balintbalazs/thesis/appendix_a.tex

% !TEX root = dissertation_BB.tex
% \cleardoublepage
% \chapter*{Appendix A}
% \addcontentsline{toc}{chapter}{Appendix A: Bill of materials}

\section{Bill of materials}
% \markboth{\MakeUppercase{Appendix A}}{}

% \setcounter{table}{0}
% \renewcommand{\thetable}{A\arabic{table}}

\begin{singlespace}
  
% \section*{Bill of Materials}
\label{sec:BOM}
\subsection*{Optical components}
  \begin{itemize}
    \item Lenses
    \begin{itemize}
      \item 2\texttimes Nikon CFI75 Apo LWD 25x/1.10w water dipping objectives
      \item 2\texttimes Nikon ITL200 \SI{200}{mm} tube lens
      \item 2\texttimes \SI{200}{mm} x \SI{25}{mm} Dia. achromatic lens (Edmund Optics, \#47-645)
      \item 2\texttimes \SI{400}{mm} x \SI{40}{mm} Dia. achromatic lens (Edmund Optics, \#49-281)
      \item 3\texttimes \SI{75}{mm} x \SI{25}{mm} Dia. achromatic lens (Edmund Optics, \#47-639)
      \item SILL 112751 1:2 beam expander
    \end{itemize}
    \item Filters
    \begin{itemize}
      \item 2\texttimes BrightLine quad-edge dichroic beam splitter (Semrock, Di03-R405/488/561/635-t3-25x36)
      \item EdgeBasic \SI{488}{nm} long pass filter (Semrock, BLP01-488R-25)
      \item BrightLine 525/50 band pass filter (Semrock, FF03-525/50-25)
      \item EdgeBasic \SI{561}{nm} long pass filter (Semrock, BLP02-561R-25)
      \item RazorEdge \SI{647}{nm} long pass filter (Semrock, LP02-647RU-25)
    \end{itemize}
    \item Mirrors
    \begin{itemize}
      \item 6\texttimes 1" Broadband Dielectric Elliptical Mirror (Thorlabs, BBE1-E03)
      \item 2\texttimes \SI{30}{mm} Broadband $1/10 \lambda$ Mirror (OptoSigma, TFMS-30C05-4/11)
      \item 10 Pack of 1" Protected Silver Mirrors (Thorlabs, PF10-03-P01-10)
      \item Knife-Edge Right-Angle Prism Dielectric Mirror (Thorlabs, MRAK25-E02)
    \end{itemize}
  \end{itemize}

\subsection*{Mechanical components}
  \begin{itemize}
    \item \SI{40}{mm} travel range pneumatic cylinder (Airtac, HM-10-040)
    \item 5/2-way electric valve (Airtac, M-20-510-HN)
    \item 2\texttimes \SI{25}{mm} extended contact bearing steel stage (OptoSigma, TSDH-251C)
    \item 30x90 mm stainless steel slide (OptoSigma,  IPWS-F3090)
    \item close proximity gimbal mirror mount (Thorlabs, GMB1/M)
    \item \SI{30}{mm} cage elliptical mirror mount (Thorlabs, KCB1E)
    \item Melles Griot Performance Plus Optical Breadboard
    \item 4\texttimes Newport Stabilizer, High Performance laminar Flow Isolator, I-2000 Series
  \end{itemize}

\subsection*{Custom parts}
  All parts are (anodized) aluminium, unless stated otherwise.
  \begin{itemize}
    \item 2\texttimes mirror holder block
    \item Front plate for objective, chamber and mirror mounting
    \item Imaging chamber (PEEK)
    \item Wedge ring and matching threaded ring to fasten objectives
    \item Camera bridge
    \item Illumination splitter unit
    \item adapter plates to mount stages
  \end{itemize}

\subsection*{Electronics}

  \begin{itemize}
    \item Embedded system (National Instruments, cRIO-9068) equipped with:
    \begin{itemize}
      \item 2\texttimes C series digital I/O card (NI 9401)
      \item 1\texttimes C Series \SI{100}{kS/s} 4-channel Voltage Output Module (NI 9263)
      \item 1\texttimes C Series \SI{25}{kS/s} 16-channel Voltage Output Module (NI 9264)
    \end{itemize}
    \item Omicron SOLE-3 laser combiner, with 488, 561 and \SI{638}{nm} laser lines
    \item Andor Zyla 4.2 sCMOS Camera
    \item Galvanometric scanner mirror (Cambridge Technology, 6210B)
    \item 6 position filter wheel (Ludl Electronic Products, 96A361)
    \item Filter wheel controller unit (Ludl Electronic Products, MAC5000)
    \item 2 piezoelectric stages (Nanos Instruments, LPS-30-30-1-V2\_61-S-N) 
    \item 2 stage controller boards (Nanos Instruments, BMC101)
  \end{itemize}
\end{singlespace}
