balintbalazs/thesis/diplomaterv.pdf

# Development of a symmetric single-plane

# illumination microscope

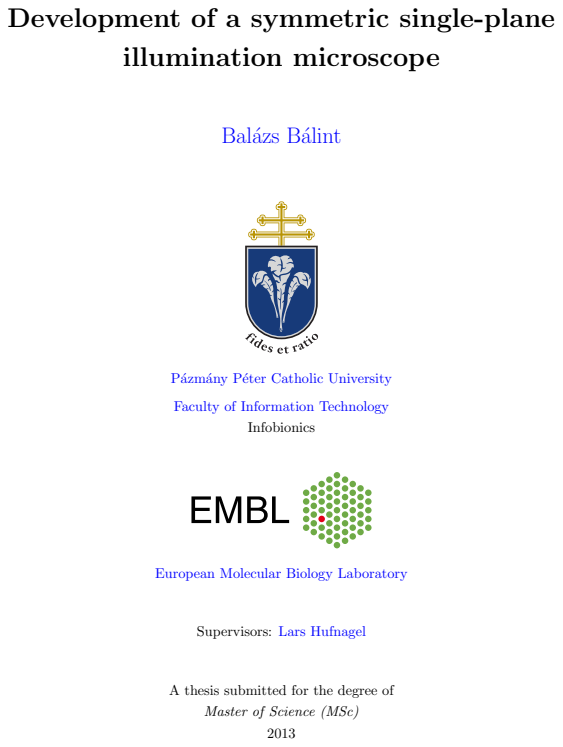
[picture p47: page 1]
Infobionics

Balázs Bálint

Pázmány Péter Catholic University (http://www.ppke.hu/)

Faculty of Information Technology (http://www.itk.ppke.hu/)

European Molecular Biology Laboratory (http://www.embl.de/)

Supervisors: Lars Hufnagel

A thesis submitted for the degree of
Master of Science (MSc)

Jelen dolgozat 2013 márcuis hó 27. napon a XXXI. OTDK Informatika szekciójában I. helyezést ért el.

## Nyilatkozat

Alulírott Balázs Bálint, a Pázmány Péter Katolikus Egyetem Információs

Technológiai Karának hallgatója kijelentem, hogy ezt a szakdolgozatot meg nem engedett segítség nélkül, saját magam készítettem, és a szakdolgozatban csak a megadott forrásokat használtam fel. Minden olyan részt, melyet szó szerint, vagy azonos értelemben, de átfogalmazva más forrásból átvettem, egyértelműen a forrás megadásával megjelöltem. Ezt a Szakdolgozatot más szakon még nem nyújtottam be.

Budapest, 2013.05.16.

aláírás

## Tartalmi kivonat

A komplex biológiai rendszerekben lezajló fejlődési folyamatok jobb megértésének feltétele az élő minták hosszan tartó képalkotása. A light-sheet alapú egysík megvilágítású mikroszkópia (SPIM) segítségével lehetővé vált ilyen minták

időbeni vizsgálatára három dimenzióban. A gyors képalkotás segítségével a sejtek mozgása megfelelően követhető még olyan gyorsan változó mintáknál is, mint például fejlődésben levő drosophila embrió, zebrahal agy vagy phallusia embrió.

Ez a mikroszkópia két, egymásra merőlegesen elhelyezett objektívet használ: az egyik egy vékony síkban megvilágítja a mintát, míg a másik a képalkotáshoz szükséges. A konfokális lézermikroszkópiához képest ez a technika jobb három dimenzós felbontást tesz lehetővé gyorsabb adatgyűjtés és kisebb fototoxicitás mellett. Ezen tulajdonságok alapján a light-sheet alapú mikroszkópia különösen alkalmas élő minták hosszan tartó megfigyelésére.

Jelen munkának célja egy olyan SPIM építése, mely két azonos objektívet felváltva használ mind megvilágításra, mind képalkotásra. Így jelentősen

növelhető a három dimenziós felbontás, hiszen a két különböző irányból készült felvételek fúziója mindkét eredeti képnél jobb felbontást fog eredményezni.

A mikroszkóp megfelelő irányításához és automatizálásához terveztünk továbbá egy egyedi programot, mely vezérli a képalkotás lépéseit és megfelelő felhasználói felületet nyújt. A program fejlesztésénél a legfőbb szempontjaink a felhasználóbarát felület biztosítása mellett a modularitás és könnyű adaptálhatóság voltak, így biztosítva a kompatibilitást különböző SPIM rendszerekkel.

Végső célunk a mikroszkóp használatával valós biológiai mintákról történő képalkotás. Az ezen mikroszkóppal szerzett adatok feldolgozásával lehetőség

nyílik a sejtek szegmentálására, valamint a sejtek osztódásának és migrációjának követésére, mely értékes információval szolgálhat számos faj embrionális fejlődésének megértésében.

## Abstract

To better understand development of complex biological systems, imaging of living samples over time is necessary. Using the light-sheet based Single-Plane Illumination Microscopy (SPIM), it became possible to image live specimens

with high resolutions in 3 dimensions over time. Fast image acquisitions makes cell tracking possible even in highly motile samples, such as a developing drosophila embryo, zebrafish brain, or phallusia embryo.

This microscopy technique uses two perpendicularly aligned objectives. One is used to illuminate a thin plane of the specimen, and the other is used to capture an image of this plane. Compared to confocal microscopy, this method provides better 3D resolution, higher acquisition rate and less phototoxicity. This makes light-sheet based microscopy especially suitable for imaging live specimens over a long period of time.

The aim of this work is to build a SPIM that uses identical objectives, and uses both of them for illumination and detection in an alternating fashion. This will significantly improve 3D resolution, because the two images taken from different views can be fused together providing a better resolution than either of them.

To be able to control and automate the microscope, we also designed a custom program that controls image acquisition and handles user interactions. Our aim when developing this program was that it should be modular and easily adaptable to different kinds of SPIM setups.

Our final goal is to use this microscope to image live specimens. Using data acquired with this microscope it will be possible to segment cells, and track cell divisions and cell migrations. This will provide valuable information on embryonic development in several species.

vi

# Contents

1 Introduction | 3
2 Single-plane illumination microscopy | 9
3 Control unit | 19
4 Results | 35
Acknowledgements | 41
References | 43

1

2

# Chapter 1

# Introduction

Vision is the most important of all of our senses, it provides the brain with more information than all the other senses together. However, using just the naked eye, it is not possible to answer all the questions of a curious mind. Using the tool of optics however, one can construct such instruments that allow to extend the boundaries of one’s eyes, and see much farther, or much closer.

Microscopy, derived from the ancient Greek words mikros, “small” and skopein, “to see”, aims to bring us closer to understand our world, by making it possible to visualise much smaller things than the naked eye can perceive.

Optical microscopy, or as often called, light microscopy uses a system of lenses to alter the path of visible light, and create magnified images of small samples. It dates back to the 17th century, when Leeuwenhoek first observed single cells using carefully crafted glass

spheres. It was also realized, that using multiple lenses, a more powerful device can be constructed.

Since then, optical microscopy advanced a great deal, and today it extended its boundaries to the infrared and ultraviolet range of light. The light source used for imaging is usually a light bulb, LED or laser. The path of the light is controlled by lenses, mirrors and apertures between the light source, the sample and the detection unit. The detection unit, if not our own eyes, can be a photomultiplier or a digital (CCD or sCMOS) camera.

Image appears on the detector, because the sample somehow interacts with the illumination light: it transmits, absorbs, reflects and scatters it. These can be visualized in different ways. Modern light microscopy also takes advantage of detecting all three properties of the light (wavelength, polarization and momentum), which provides us with

a wide variety of different contrasts.

In this work I will first revise current light microscopy techniques, and in Chapter 2 show the principles of single-plan illumination microscopy. In Chapter 3 I describe a custom program that was developed to control and automate a SPIM microscope. Finally, in Chapter 4 I demonstrate the capabilities of our symmetric SPIM controlled by the custom program.

3

## 1.1 Fluorescence microscopy

Fluorescence microscopy [1] is a microscopy technique that uses fluorophores, a special

group of chemicals that are capable of absorbing a photon of well defined energy, and emit a different photon within a stochastically determined time frame. The emitted photon usually has less energy than the absorbed photon, it is shifted towards the red side of the spectrum. This effect is called the Stokes-shift.
Using this phenomenon, it is possible to differentiate between the photons used for excitation and the emitted photons using an appropriate filter. Since the emitted photon usually has less energy, a low-pass filter can be used that will filter out the higher energy, lower wavelength illumination photons. Even though a very small amount of illumination photons will result in fluorescence (< 0.0001%), the signal to noise ratio of the fluorescence

is still very high due to the filtering.
Fluorescent microscopy is especially suitable to image live specimens, since a lot of organisms has naturally fluorescent structures. This phenomenon is called autofluorescence.
Imaging specimens using just autofluorescence although can be useful in some cases, but in most of the time we would want to narrow our interest in a specific part, specific structure of the specimen. This can be achieved in several ways, but the simplest and earliest solution is the use of fluorescent dyes. These dyes, as the name implies, emit fluorescence under a certain excitation wavelength, and have such a structure, that they can specifically bind to certain parts of the cell. Fluorescent dyes although very useful in most cases, have some limitations.
However, fluorescent microscopy took a great leap with the discovery of the green fluorescent protein. This had such an impact on future development of fluorescence microscopy, that three scientists were awarded with a Nobel Prize in chemistry in 2008 for it’s discovery [2]. Since then, several variants were generated, and so today a whole spectrum of fluorescent proteins are available [3]. The huge benefit of these proteins over the

synthetic fluorescent dyes, is that the cell is capable of producing them by itself. Using genetic manipulation techniques, it is possible to introduce the genetic material coding a fluorescent protein into the genome of virtually any organism. These proteins can also be modified and fused with certain proteins of interest. Using this technique, the fluorescent protein will be attached to a functional protein, this way its expression and localisation pattern can be determined.

### 1.1.1 Wide-field fluorescence microscopy

One of the simplest fluorescent microscopes is a wide-field fluorescent microscope (Figure 1.1). The main difference to a regular microscope, is the introduction of a filter cube.

This cube contains an excitation filter, emission filter and a dichroic mirror. The dichroic mirror is used to couple the illumination and detection light paths, and the filters are

4

used to separate the fluorescent light from the excitation light. The image of the sample is focused on the detector of a digital camera.

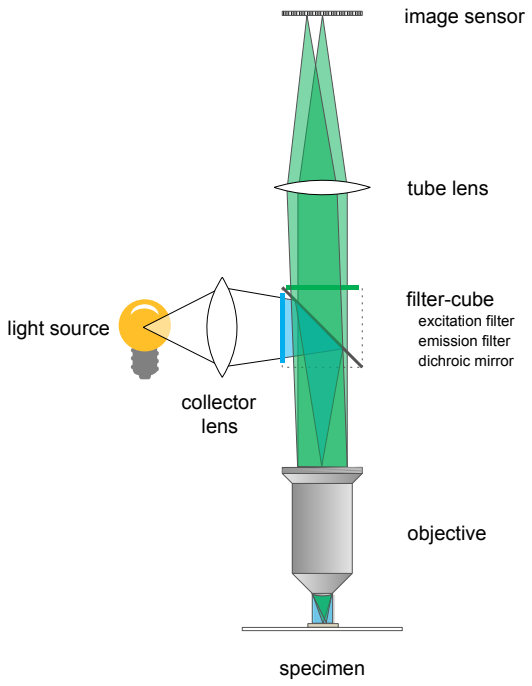
[picture p48: figure]
tube lens; filter-cube excitation filter emission filter dichroic mirror; objective; specimen; light source; collector lens; image sensor

Figure 1.1: Wide-field fluorescent microscope.

Resolution of a wide-field microscope

Resolution of a microscope is given by the minimal distance of two point that can sill be distinguished. The smaller this distance is, the better the resolving power of the microscope. However, the resolution is limited by the wave nature of light, and cannot be decreased infinitely.
A generally accepted method to calculate lateral (σxy) and axial (σz) resolution of an optical microscope is described by the Stelzer-Grill-Heisenberg, or SGH theory[4, 5]:

σxy =

λ
√
3 − 2 cos α − cos 2α

(1.1)

σz =

λ
1 − cos α

(1.2)

Generally, instead of α, the numerical aperture (NA) is commonly used to characterize a lens’ aperture. NA = n · sin α, where n is the refractive index of the medium and α

stands for the angular aperture.
Although high NA objectives have better axial resolution (Figure 1.2), this is still

around 3–6 times worse than the lateral resolution. In theory, it is possible to achieve

5

isotropic resolution in case of α = 180◦
, which means collecting all light emitted from the sample. However, it is currently unachievable to realize such a device that is capable of this. Because of this, 3D imaging with any microscopy technique that use one objective will always produce an anisotropic image.
Another disadvantage of the wide-field microscope, is that it can not be used with thick specimens. Usually this type of microscopy is only used for a single layer of cells, because all the objects in the field of view will appear on the imaging plane, not just the plane in focus. These objects will appear blurred if close to the focus, or just evenly add to the background noise if they are further from the focus. This is why imaging specimens much thicker than 10 µm will result in suboptimal image quality.

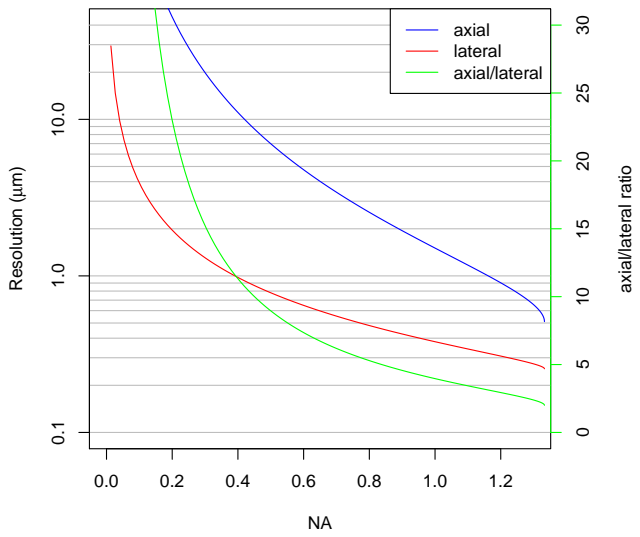
[picture p49: figure]
axial; lateral axial/lateral; Resolution (; axial/lateral ratio

Figure 1.2: Resolution of a wide-field microscope. Axial (blue) and lateral (red) resolutions of a wide-field microscope are shown with respect to the numerical aperture (NA). Resolutions are calculated with λ = 510nm, the emission maximum of GFP and n = 1.333, the refractive index of water, for water dipping objectives.

## 1.2 Confocal microscopy

Laser scanning confocal microscopy [6] addresses the problem of noise originating from

the out of focus planes. The principle for illumination and detection optics is very similar to a wide-filed microscope, but for illumination a focused laser light is used.

The biggest change is in the detection method: the confocal microscope uses a pinhole, to exclude light coming from out of focus planes. Since only those rays are taking part in the imaging that originate from the focus, the image quality is highly improved. This microscopy technique is also capable of 3D imaging, with an axial resolution corresponding

6

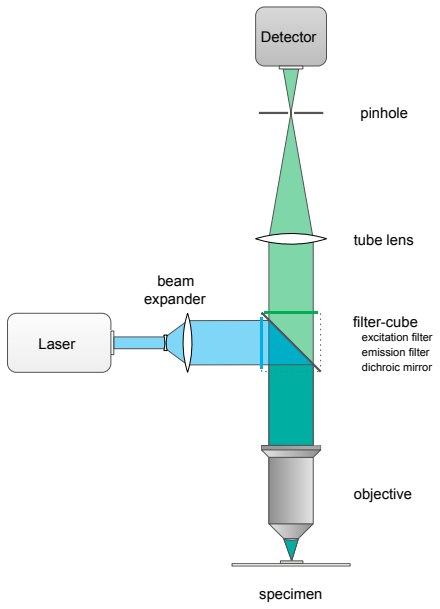
[picture p50: figure]
Laser; pinhole; Detector; tube lens; objective; beam expander; specimen; filter-cube excitation filter emission filter dichroic mirror

(a) Confocal microscope

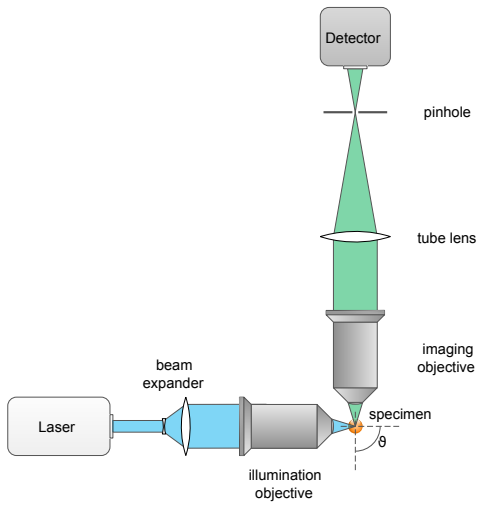
[picture p51: figure]
Laser; pinhole; Detector; tube lens; illumination objective; beam expander; specimen; imaging objective

(b) Confocal-theta microscope

Figure 1.3: Basic optical components of a laser scanning confocal and confocal-theta microscope. Both type of microscopes use confocal images detection, which means that a pinhole is used to exclude light coming from out of focus points. Light intensity is measured by a photomultiplier for every voxel in the region of interest. The final image is generated on a computer using the positions and recorded intensity values. A regular confocal microscope (1.3a) uses the same objective for illumination and detection, while a confocal-theta microscope (1.3b) uses a second objective that is rotated by ϑ around the focus. In this case, ϑ = 90◦.

to a wide-filed microscope.

However, the image can not be registered as simply as with the wide-filed detection, since at any given time, only a very small portion of the sample will be used in the imaging. Because of this, a more sensitive detection is required, which generally means the use of a photomultiplier. To get the whole image, the focus is scanned through the whole sample (or rather, the sample is scanned through the focus), recording an intensity value for each

position. The image is then generated using a computer based on the recorded position and intensity values.

Although this microscopy technique already has 3D capabilities, it’s axial resolution is still limited by the SGH theory, since it uses only one objective. Imaging live specimens for an extended period of time with confocal microscopy although possible [7], is not

ideal. Since for each voxel imaged, almost the entire specimen has to be illuminated, which results in a very high dose of radiation of the samples. This can be as much as 30–100 times bigger, than the dose used for the actual imaging [8]. High power of laser

for an extended time frame can result in bleaching the fluorophores, thus resulting in a lower signal at later times, but the more significant issue is phototoxicity, that is when the cells themselves are damaged by the laser light.

7

## 1.3 Confocal-theta microscopy

Although confocal microscopy already provides a better resolution in all dimensions, the ratio of the axial and lateral resolution is still very high, due to the single objective illumination and detection. This seriously limits the microscope’s 3D imaging capabilities, since in the z direction (i.e. along the imaging axis) the resolution would be significantly

worse than in the other directions.
Confocal-theta microscopy [9] introduces a second objective to a regular confocal microscope, that is used to illuminate the sample (Figure 1.3b). Since this decouples the

illumination and detection, using a filter cube is no longer necessary. The second objective is rotated by ϑ around the focus, this is the where the name of this setup originates. Resolution is also improved compared to the regular confocal microscope, because the lateral resolution of the imaging objective now corresponds to the axial resolution of the detection objective. The combined resolution of the two-objective system can be calculated in the following manner [10]:

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
(1.3)

where σill = σxy and σdet = σz for the axial resolution of the system, and reversed for the lateral resolution of the system. This means, that the axial and lateral resolution would be the same (if the same objectives are used), and the resulting point spread function is

almost isotropic.
Although this is a big improvement to confocal microscopy, the issue of photobleaching and phototoxicity is still not solved with a confocal theta microscope, which means that longer developmental processes are near impossible to follow with this type of microscopy.

8

# Chapter 2

# Single-plane illumination

# microscopy

The main principle behind single plane illumination microscopy, that is illuminating the sample from the side by a very thin light-sheet, dates back to the early 20th century, when

Siedentopf and Zsigmondy first described the ultramicroscope [11]. This microscope used

sunlight as an illumination source, that was guided through a precision slit to generate a thin light-sheet. This allowed Zsigmondy to visualize gold nanoparticles floating in and out of the light-sheet. Since these particles are much smaller than the wavelength of the light, the device was called an ultramicroscope. His studies with colloids together with the development of the ultramicroscope led Zsigmondy to win the Nobel Prize in 1925.

Since then however, light-sheet microscopy was seldom used, but in the last decade it was reinvented and combined with fluorescent microscopy. The first notable light-sheet fluorescent microscope (LSFM) was developed at EMBL in 2004 [12], that demonstrated

the benefits of using a light-sheet in imaging developmental processes in three dimension.

Since then, light-sheet based imaging has gained more and more popularity, as it can be adapted and applied to a wide variety of problems. It was numerously proven to be a better choice than confocal microscopy [8, 13] especially in developmental biological applications [14]. It can also be used with a wide variety of specimens of different sizes, such as zebrafish embryo [15], mouse brain [16] or drosophila embryo [17]. It is also

possible to use light-sheet microscopy in super-resolution, allowing for individual molecule localization [?].

## 2.1 Optical properties

A selective-plane illumination microscope (SPIM) uses a light-sheet to illuminate only a thin section of the sample (Figure 2.1). This illumination plane is perpendicular to the

imaging axis of the detection objective and coincides with the focal plane. This way the image is taken of only that specific plane that is illuminated, thus providing much better

9

signal to noise ratio. In case of conventional wide-field fluorescent microscopy, where the whole specimen is illuminated, light scattering from different regions contribute to a significant background noise. With selective-plane illumination, this problem is intrinsically solved, and it also provides a true sectioning capability. This makes SPIM especially suitable for 3D imaging.

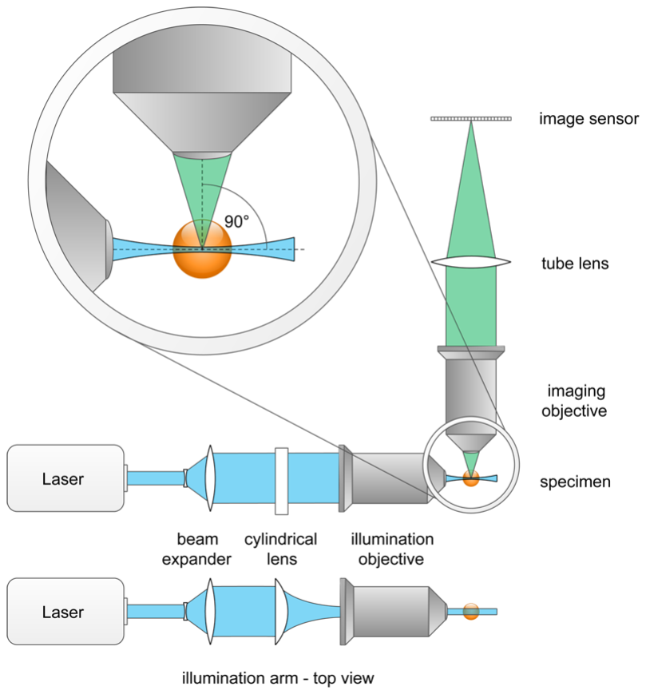
[picture p52: figure]

Figure 2.1: Basic optical components of a SPIM. A selective plane illumination microscope uses two objectives orthogonally aligned. One objective is used to generate a thin light-sheet that illuminates the sample from the side, while the other is used for detection. To generate an image of the specimen, a suitable tube lens is used to focus the light on the sensor of a detection unit (e.g. sCMOS camera). The light-sheet is generated by the illumination objective, using a beam that is previously shaped by a cylindrical lens.

### 2.1.1 Detection

The detection unit of a SPIM is basically equivalent to a detection unit of a wide-field microscope, without a dichroic mirror (Figure 2.1). Most important components are the

objective together with the tube lens, filter wheel, and a sensor, typically a CCD or sCMOS camera.
One of the most important aspects that determine the resolution of the microscope is the detection objective. Since in developmental biology specimens require a water-based

10 solution, these objectives are usually water dipping objectives directly submerged in the medium. Since the refraction index of water (n = 1.333) is greater than the refraction

index of air, these objectives tend to have a higher NA, which results in higher resolution. This, however, also depends on the sensor used, mainly on the pixel size (dsensor).

The magnification is typically 10×, 20×, 40× or 100× but these values are sound

only when the objective is used together with the prescribed tube lens. These lenses are specially made to be used with the specific objectives, and are corrected for any aberrations. They typically have a focal length of 160–200mm.

### 2.1.2 Illumination

Using cylindrical lens

The light-sheet can be generated using a cylindrical lens, which focuses the laser beam in only one direction, and creating a thin sheet in the proximity of the focal point. However, to achieve light-sheets that are thin enough, one would need to use cylindrical lens with low focal lengths, but these are hardly accessible in well corrected formats. For this reason, its more common to use a longer focal length cylindrical lens in conjunction with a microscope objective, which is well corrected for chromatic and spherical aberrations [18]. This way, the light-sheet length, thickness and width can be adjusted for the specific

imaging tasks.

For paraxial waves, i.e. waves with nearly parallel wave front normals, a general wave equation can be approximated with the paraxial Helmholz equation [10, 19]

∇²
T + i2k

∂U
∂z = 0 | (2.1)

where ∇²
T =

∂

2
∂x² +

∂

2
∂y² , U(~r) is the wave-function, k =

2π
λ
| is the wavenumber and we
assume, that the light spreads in z direction.
A simple solution to this differential equation is the Gaussian beam:

U(r, z) = A0 ·

W0
W(z)
- e

− r

2
W2(z)
- e

−i·φ(r,z)
| (2.2)

where A0 is the amplitude of the wave, W0 is the radius of the beam waist (the thinnest location on the beam), r =

p
x

2 + y

2 is the distance from the center of the beam, W(z)

is the radius of the beam z distance from the waist, and φ(r, z) is the combined phase

part of the wave-function. Furthermore:

W(z) = W0

s
1 +
z
z0

2
(2.3)

where the parameter z0 is called the Rayliegh-range. This has the following connection with the beam waist:

11

z0 =

πW0
λ

(2.4)

Which means, the thinner the beam waist, the shorter the Rayliegh-range, that is the beam divergence is faster for more focused beams.

Intensity of the emitted flurescence is based on the intensity of the excitation light. In case of a Gaussian beam:

I(r, z) = U(r, z) · U

∗
(r, z) = |A0|

2
·
W0
W(z)

2
- e

− 2r

2
W2(z) | (2.5)

Apart from the circular Gaussian beam, the elliptical Gaussian beam is also an eigenfunction of Helmholtz equation (2.1):

U(x, y, z) = A0 ·

s
Wx,0
Wx(z)

s
Wy,0
Wy(z)
- e

− x

2
W2
x(z)
- e

−

y

2
W2
y (z)
- e

−i·φ(x,y,z)
(2.6)

This beam still has a Gaussian profile along the x and y axes, but the radii are uncoupled, which results in an elliptical beam. Since the beam waist is different along the two axes, the Rayliegh range is also different:

zx,0 =

πW²
x,0
λ

(2.7)

zy,0 =

πW²
y,0
λ

(2.8)

Intensity of the beam is the following:

I(x, y, z) = U(x, y, z) · U

∗
(x, y, z) = |A0|

2
·

Wx,0
Wx(z)

·

Wy,0
Wy(z)
- e

− 2x

2
W2
x(z)
- e

−

2y

2
W2
y (z)
(2.9)

where

Wx(z) = Wx,0

s
1 +
z

zx,0

2
and Wy(z) = Wy,0

s
1 +
z

zy,0

2
(2.10)

Since the illumination is uneven, the usable field of view is smaller than the actual illuminated region (Figure 2.2a). The width of the field of view wf ov is determined by the

Rayliegh length, since this is in a direct relation with the beam divergence. To stay in the optimal region, the light-sheet should only be used in the range of 1 Rayleigh length on both sides of the beam waist (Figure 2.2b). In this range, the ratio between the thickest (at z = z0) and the thinnest (at z = 0) part of the beam W(z) will be √
2 ≈ 1.4142 which

is still acceptable.

Light-sheet height is determined by the profile of the beam along the vertical axis (Figure 2.2c). Since this is a Gaussian function (see Equation 2.2), only a small part in

12 the middle can be used for imaging, because towards the sides the intensity dramatically drops. To allow a maximum 80% drop of intensity at the edges, the light-sheet height is hf ov = 2 · 0.472 · Wx,0

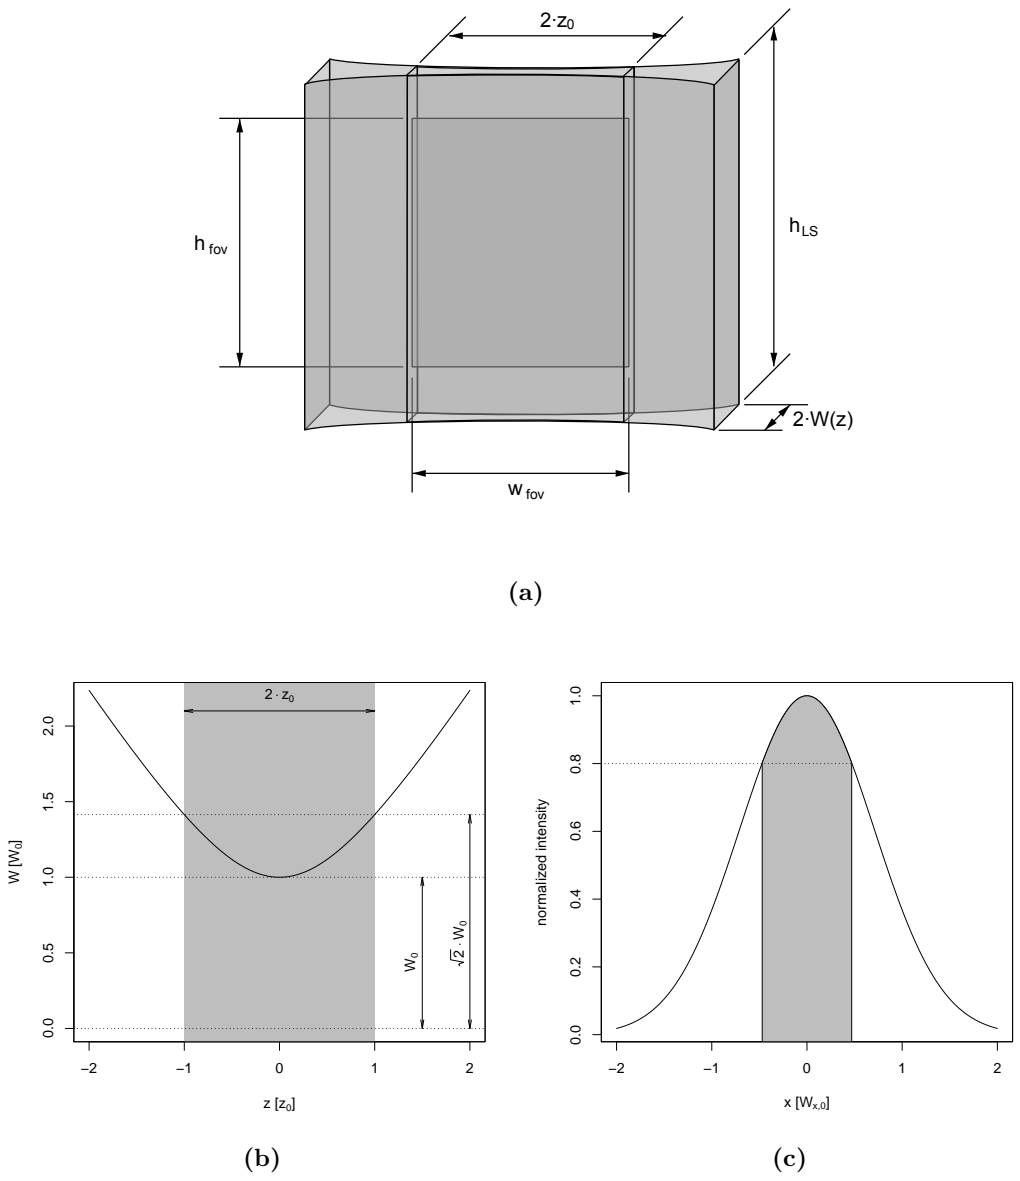
[picture p53: figure]
h fov; w fov; hLS; normalized intensity

Figure 2.2: Light-sheet dimensions. 2.2a shows a light sheet, with the field of view indicated. Since the light-sheet intensity is uneven, the field of view has to be confined to a smaller region. 2.2b The width and thickness of the field of view depends on the Rayleigh length of the beam (zy,0). 2.2c Height of the field of view is determined by the Gaussian profile of the elliptical beam.

13

Using focused beam scanning

Since using cylindrical lenses it’s not possible to generate a homogeneous light-sheet, moreover at higher magnification the Rayleigh range would be too small, we also consider using focused beam scanning to generate the light-sheet (digital scanned light-sheet microscopy, DSLM). To generate a scanning beam, a galvanometer controlled mirror is

used to alter the beam path. This can quickly turn around its axis which will result in an angular sweep with the laser beam. To change the angular movement to translation, a scan lens is used to generate an intermediate scanning plane. This plane is then imaged to the specimen by the tube lens and the illumination objective, resulting in a scanned focused beam.

This method to generate the light-sheet has several advantages compared to a static light-sheet. The height of this sheet is not determined by the cylindrical lens, but it can be dynamically modified. Also, the intensity is uniform through the whole height of the

light-sheet.

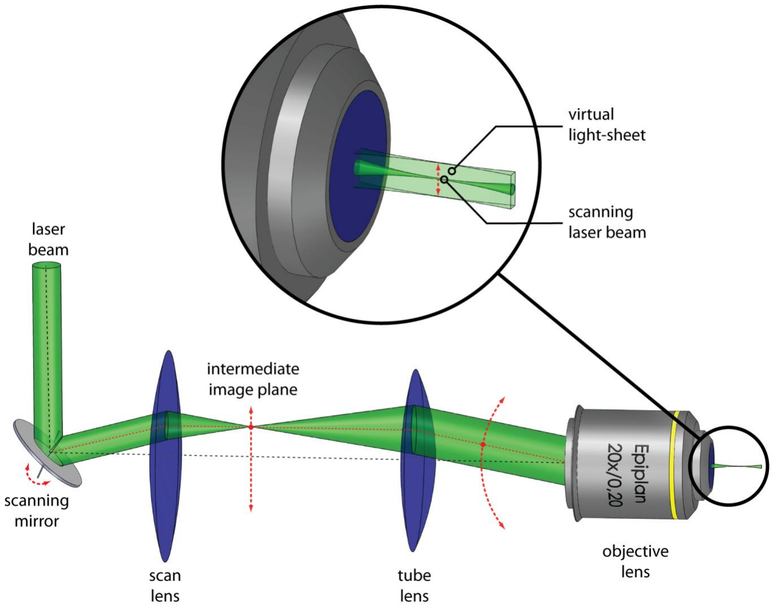
[picture p54: figure]

Figure 2.3: DSLM illumination. DSLM illuminates a specimen by a circularly-symmetric beam that is scanned over the field of view. This creates a virtual light-sheet, which illuminates a section of a specimen just like the SPIM. Light-sheet in DSLM is uniform over the whole field of view and its height can be dynamically altered by changing the beam scan range.

## 2.2 Symmetric SPIM

To address the challenges of isotropic 3D imaging, we propose a new SPIM microscope. Usually, in a SPIM setup, the two objectives have different optical properties – the one

14

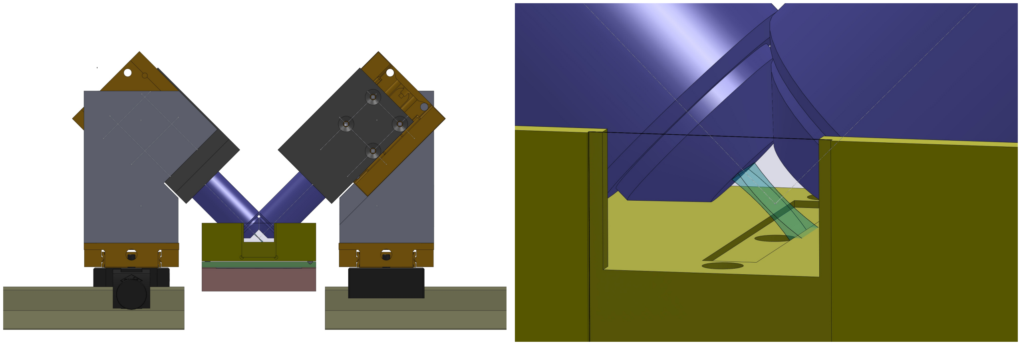
[picture p55: figure]

(a) Objective alignment | (b) Light-sheet

Figure 2.4: Objective alignment and light-sheet position.

used for imaging typically has a higher NA, and the one used for illumination has a lower NA. In the isotropic SPIM setup we use two objectives of the same type, both for illumination and detection. The objectives are placed in a V-shape, above the sample (Figure 2.4a), perpendicular to each other and the light-sheet in a 45◦ angle (Figure 2.4b).

This arrangement makes sample mounting much easier compared to mounting in capillary, but rotation is not possible.

However, since both objectives are used for imaging and illumination in an alternating fashion, this makes sample rotation unnecessary, and images from the two opposing views can be taken in rapid succession. This, and the fact that sample mounting is much simpler makes this microscope an ideal candidate for screening applications. Combined with a multi-positioning stage, it will be possible to image as much as 100 specimens with this microscope.

To achieve this type of operation, it is not enough to just simply put two conventional SPIMs facing towards each other. Since the objectives are now used both for imaging and illumination, a dichroic mirror is needed to couple the optical paths. The dichroic mirror is chosen so it will reflect the wavelength of the illumination light, but transmit the wavelength of the excitation light (Figure 2.5). Besides this, the detection uses the

same components as a normal wide-field fluorescent microscope, a filterwheel, a tube lens and a detection unit, in our case a CCD camera.

### 2.2.1 Image registration

When imaging with the symmetric SPIM, we have to take into consideration the 45◦

objective alignment. Since the stage moves horizontally, this will result in a specimen translation not perpendicular to the imaging axis, but rather in a 45◦ angle. Since nor-

mally the 3D image stacks are represented in an orthogonal coordinate system, when displaying a stack made with the symmetric SPIM, it will be sheared along the imaging plane. To correct this, we have to apply an affine transformation, which will align the

15

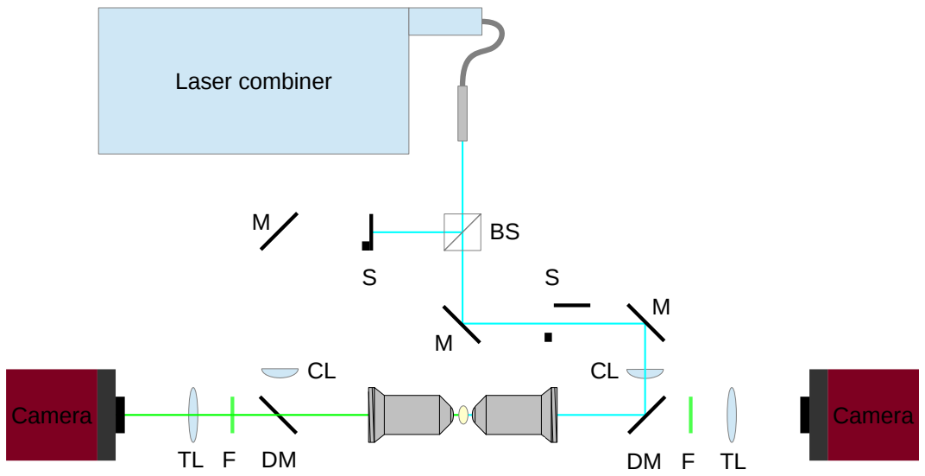
[picture p56: figure]
Laser combiner; Camera

Figure 2.5: Schematics of a symmetric SPIM setup. The laser light is split in two with a 50–50 beamsplitter (BS). The light-paths are selected using mechanical shutters. The laser beam is then shaped using a cylindrical lens (CL), which focuses the beam in one direction to the back focal plane of the illumination objective. This objective then creates the final light-sheet that can be used for imaging. Abbreviations: M – mirror, BS – beam splitter, S – shutter, CL – cylindrical lens, DM – dichroic mirror, F – filter, TL – tube lens.

planes correctly.

When the imaging and translation axes are not perpendicular, but in an α angle, the real stack recorded will be a parallelepiped (Figure 2.6, marked in red). However, when

opening it in an image processing application, the program will assume that all the bases are orthogonal, and will display it incorrectly, that is sheared compared to the original, real stack (Figure 2.6, marked in blue).

To perform the inverse shear transformation, we need to apply the following transformation matrix to our 3D stack:

A =

1 0 0
0 1 s
0 0 1

| (2.11)

where s depends on the lateral resolution(dxy), the stage translation (d

0
z

) and the angle
between the imaging and translation axes (α).

s =

c

dxy

(2.12)

16

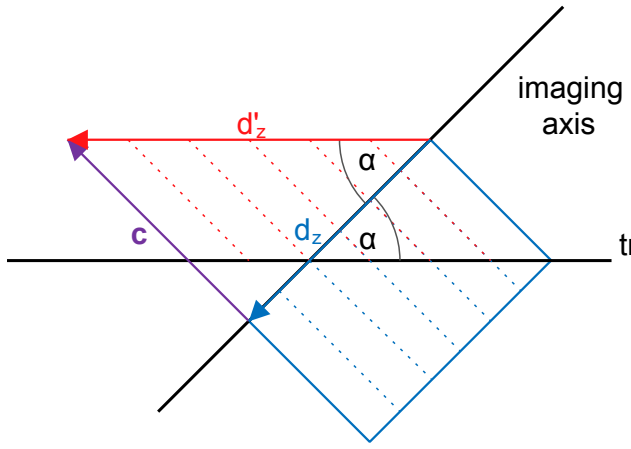
[picture p57: figure]
imaging axis

## translation axis

Figure 2.6: Real and virtual stacks. The red dashed lines indicate the positions where the images are taken. The parallelogram shape is the result of the α angle between the translation and imaging axis. When displaying the stack on a computer, it will display a transformed, virtual stack, which is marked with blue. To correctly display the 3D stack, an inverse of this shear transformation has to be performed.

where dxy =

dsensor
M and c = d

0
z

cot sin(α), thus

s =

d

0
z
dsensor
M

sin(α) = d

0
z
- M

dsensor

sin(α) | (2.13)

For α = 0◦
, when the imaging axis is parallel to the translation axis, A = I.

17

18

# Chapter 3

# Control unit

Since the microscope setup is custom built and uses components individually selected, the second objective of this work was to develop a program to control and automate image acquisition. The main criteria for this program were modularity and user friendliness. Although the group already had a working microscope (MuVi SPIM [17]) with a custom

program, this program was completely specific to that setup. Since the group plans to build several different microscopes that use similar components, we aimed to develop a completely modular program that has the ability to control different SPIM (or other microscope) setups.

User friendliness is also critical, because microscopes are typically used by personnel who has little programming knowledge. To this end, we used LabView to implement the program, because LabView is mainly designed for hardware control it also provides a convenient tool to generate user interfaces.

## 3.1 General description

The devices we implemented in this program are camera, laser, stage, galvanometric scanner (galvo), filter wheel and shutter. Since most of these devices can be controlled by digital triggers and/or analog signals, and synchronization is critical, we use an FPGA

to generate the appropriate signals. Some devices however are still controlled through other means of communications, such as VISA, through COM port. These devices can introduce some factor of uncertainty, but fortunately all of the devices that are used in the most time-critical operations use digital triggers or analog signals as an input. These devices include the laser, camera, scanning mirror (galvo) and translation stage. Because

the program uses these names as class names, in further discussion I will use regular text to refer to physical devices, and emphasized text to refer to Classes or Functions. For example, laser will mean the actual hardware, and Laser will mean the class that is used to control the laser.

When starting the program, the user first has to define the hardware configuration

19 of the microscope. This includes selecting the physical channels the device is connected to and some other parameters that influence how the device should work. These parameters are further discussed in the following sections. After setting up the hardware configuration, it is possible to save the settings and load them later.

When the hardware settings are defined, Main loops through each device to initialize them (InitDevice). Most of the time this mean opening communication port, handshaking,

and setting initial values. In the case of FPGA, this is only setting the initial values. After initialization, Main enters the main loop, where it displays the appropriate front panels for devices, listens for user events, and handles them appropriately. Since in the development phase we wanted to have the program as flexible as possible, all devices have a separate front panel, and Main opens a new one for each of them. These front panels then communicate with Main through TCP/IP, implemented using the STM package for LabView (Figure 3.1).

This means, that the user interaction side of the program is completely uncoupled from Main, so these front panels could run on a completely different computer. Furthermore, the front panels don’t even need to be programmed in LabView, they can be implemented in any other programming language, which makes it possible to run the microscope from a browser for example. TCP/IP communication also enables us to control the whole

program through external scripts, without real user interaction. This can be useful in the future for example if we want to couple the microscope operation with real-time image analysis. The external program could adjust the microscope settings according to the results, for example determine the center of mass of the fluorescence, and set the stage so it would be in the center of the field of view. Main Computer

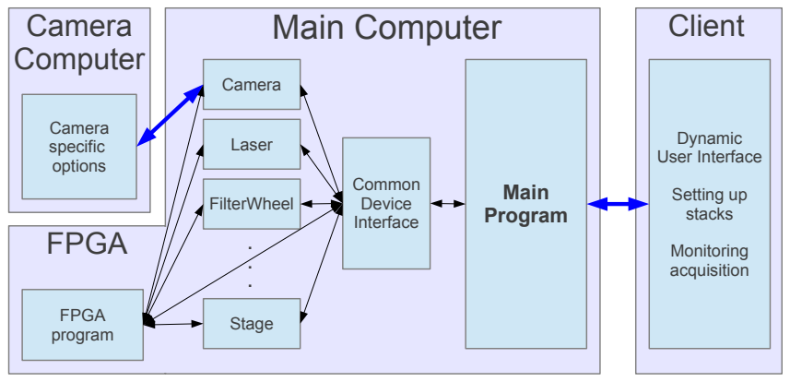
[picture p58: figure]
FPGA; Client; Main Program; Camera; Laser; FilterWheel; Stage; Common Device Interface; Dynamic User Interface; Setting up stacks; Monitoring acquisition; Camera Computer; Camera specific options; FPGA program

Figure 3.1: Basic structure of the control program. The main program is written in LabView (National Instruments), and runs on the computer which is directly connected to the components of the microscope. To ensure flexibility and modularity, we took an object oriented approach towards the implementation. The main program only calls the functions of a generic Device class, and has no further knowledge of the devices. Black arrows: LabView internal communication; blue arrows: TCP/IP communication.

20

## 3.2 Detailed operation

The program is implemented in a way, that the Main doesn’t need to know anything about the specific data types of the Devices. This is achieved through LVOOP (LabView Object Oriented Programming), which is very similar to regular object oriented programming,

but still retains the data-flow model used by LabView. The Main stores the Devices in an associative array, and calls only the high-level functions of the general Device. The only exception is the FPGA which does need to have some specific functions on Main, but this can be treated specially, because it is needed for the operation of several other devices.

### 3.2.1 Automator

The devices apart from the physical components of the microscope, also include an Automator. This Automator is a virtual device, it is used to control the flow of the imaging loop. The two main concepts it uses are Stacks and Channels.

Stacks are used to define a region in the specimen to image. They store two stage positions, a starting and end positions together with the number of planes to image. The Run mode will then use this data to move the stage to every position and take an image with the settings specified in Channels.

A Channel defines the settings of every device that is used to by the microscope, except for the stage (stage data is used in Stacks. When the user is satisfied with a certain

combination of settings, e.g. laser wavelength and intensity, filter type or exposure time; they can define a Channel based on the current device settings. These Channels then can be added to the Stacks, even to multiple Stacks, or multiple Channels to the same Stack.

Live mode

In live mode, all the front panels are active, the user can interact with the devices in real time, and see the result immediately. This mode is used to move the specimen to the correct positions, define stacks and find the optimal settings for channels. Live mode has two further options, continuous and single. Depending on the user’s choice, the images are taken continuously, or just on at a time. Continuous mode offers faster feedback on the changes, and so this is normally used for coarse alignment of the specimen, or adjusting the light-sheet properties. Single mode is better suited for sensitive samples. Using this to fine-tune the settings although can take a little more time, but the phototoxic stress on the sample is greatly reduced.

Live mode is also used to define the flow of the automated image acquisition. Once the stacks and channels are defined, the user can build a command queue of these elements (see Figure 3.2). The simplest case uses a loop over time: one can specify the delay

between the loops and the number of repetitions. This feature can be used for time-lapse

21

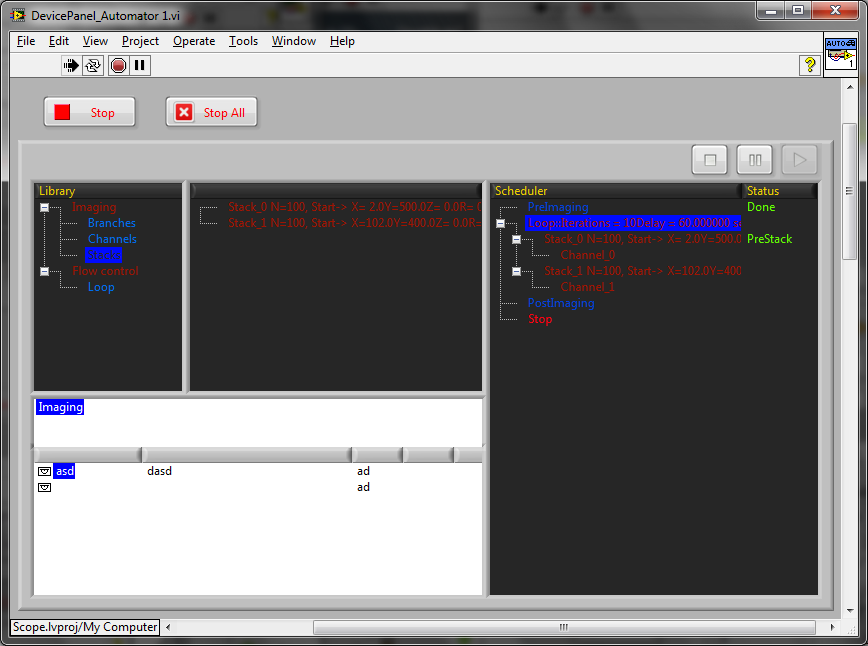
[picture p59: figure]

Figure 3.2: User interface for Automator. The front panel of the Automator consists of 3 main panels. The left panel contains a library of possible commands or functions that define the flow of microscope automation. The center plane displays further information when an element is chosen from the library, and the right panel shows the Scheduler, which contains the currently selected operations. Adding elements to the queue can be done simply by drag-and-drop, and they can be removed or modified by right clicking on them. When in run mode, the execution status is displayed next to the elements (green).

imaging.

Other options are also taken into consideration, but are not yet implemented. This could include for example some kind of checkpoint, where after taking the images they are immediately processed (either in LabView, or an other application), and depending

on the results, the settings of the microscope could be updated automatically.

Run mode

When the user defines the flow of the microscope program and clicks on Play, the Automator will enter the Run mode. Here, a series of functions will be called based on the scheduler queue. Once the next element in the queue is executed it is removed, unless it is tagged, in which case it will be popped back to the queue again. This is the case for the stacks for example.

If the stacks would just run in a loop with a pre-set number of repetitions, aborting or stopping the execution would not be so simple. In this case however, when a stack is running and the user clicks Pause or Stop, these command will be pushed in the queue before the next stack. This means, that the program flow can be easily manipulated while it is still running.

When executing the time loop, the Automator loops through all the stacks (all of them are represented in the scheduler queue), and then in a stack loops through all

22 channels. Before executing a stack, P reStack is called, which sets the stage to its initial position and calls any other functions that need to run before taking the stack. After this, the Automator loop through all the channels that are defined for the stack, and after completing this it calls PostStack for all devices which prepares the devices to be ready for the next stack.

Executing the channels also consists of 3 parts: PreChannel, Execute, and PostChannel. The pre- and post functions serve similar functions as the ones for the stacks, only this is on a different level of execution, thus allowing for more generalized structure. After setting every device to the appropriate initial position defined in the channel, the Automator loops through all the planes and performs stage translation, laser control and image exposure in a synchronized fashion. Since all the devices that are used at this point receive signals from the FPGA, this part of the program just uploads the appropriate

commands on the card and executes them.

### 3.2.2 FPGA

FPGA, or field programmable gate array is an integrated circuit device that can be reconfigured after manufacturing. Since the reprogramming is done in the hardware level, FPGAs can be really fast executing a single, specific operation. They usually also provide configurable inputs and outputs which can be used for measurements or to control other devices.
To program the FPGA we used the FPGA module for LabView, which creates an interface to the FPGA that enables normal vi-s (virtual instruments) to communicate

with the FPGA and pass data to it. The card we use is NI PCIe-7841R, which contains a Xilinx Virtex-5 LX30 FPGA. It has 8 analog and 96 digital outputs, and the current version uses 8 of each. The digital outputs have a maximum output rate of 40MHz, while the analog outputs have a maximum output rate at 1MHz. Output ranges from -10 V to 10 V with 16 bit resolution. These properties make this FPGA card especially useful

when generating the signals to control time-critical operations.

Sections

We define a signal with a series of sections that are interpreted by the FPGA. For the digital lines these sections are defined by a section length, section value which is a boolean value, and section type. Since the FPGA operates in discrete time domain, instead of continuous time, we define the length of a signal in counter ticks (n = t/f, where f is the counter frequency on the FPGA and t is the signal length). Section type is also boolean,

it defines whether to update the output to a new value, or use the previous one. In this case, section value is not taken into consideration, only the section length (Figure 3.3).

For analog channels the section value is a 16 bit integer which will be converted to voltage in the range of -10 V to 10 V. Analog sections have two more properties: Dvalue

23 and DDvalue, which are values of the first and second derivative respectively. For every time point, the FPGA integrates, and adds the DDvalue to the Dvalue, and Dvalue to the value, which becomes the output signal. Section type is also different, it is a 1D boolean array of length 3, which defines if the value, Dvalue or DDvalue needs to be updated or not at the beginning of the section.

| 1 | 2 | 3
length | 100 | 100 | 200
value | 0 | 10000 | 0
Dvalue | 0 | -200 | 0
DDvalue | 0 | 0 | 1
type (base 2) | 111 | 011 | 110

(a)

0 | 100 | 200 | 300 | 400

−10000 −5000

0 5000 10000

Output example of FPGA

t [ticks]

value

1 | 2 | 3

(b)

Figure 3.3: Example for analog sections. The first section sets every value to 0, resulting in a constant signal for 100 ticks. The next section then sets only the value and Dvalue, to 10000 and -200 respectively, this produces a linear slope. The last section sets the Dvalue and DDvalue to 0 and 1, which results in a parabolic signal that starts from the last value of the previous section.

Using these sections to define the signals is very convenient, since the data passed to the FPGA is minimal compared to the case where all the values are calculated for every time point. Instead, we just need to send these few parameters, and the FPGA will do the calculations for any signal that can be represented as a series of linear and parabolic segments.
The FPGA also uses a global variable which is the signal length in ticks. After the number of iterations reach this number, the FPGA sets all channels back to the initial position and starts iterating form the beginning again. This length is the sum of the exposure time and the delays that the user defined. If the sections for a channel are shorter than this signal length, then the sections will repeat periodically until the signal length is reached.

Uploading new sections

Whenever the device settings change in Main, the program recalculates the sections and sends this data to the FPGA through a FIFO, which enables direct memory access on the FPGA. The sections for every 8 channel are sent as a continuous stream of numbers, but at the beginning of every channel the first value indicates the number of sections that the channel will need to use. Also, before all the sections, the length of the whole data stream is sent, so the FPGA will know right away how much data it will need to handle.

24

Based on this number, the FPGA then reads the values and stores them in an internal random access memory block. When executing the sections, the pointer to the first element of the sections are specified, and the FPGA will iterate through all of them sequentially. Since the memory on the FPGA is big enough, it is possible to upload multiple streams of sections, each of them to a different starting position of the memory block. After this is done, the M ain just needs to send the appropriate pointer value, and the FPGA will execute the corresponding sections.

Another feature of the FPGA program, is the automatic smooth transition of analog signals when new sections are uploaded to the card that has different initial values than the current values. This is necessary, because in some cases the analog signal directly controls a mechanical system that can be very sensitive to sudden changes of the input. Although some of these devices has built in low-pass filters to prevent this, it is still better

not to take the chance, and use smooth transitions whenever possible.

These transitions are achieved also by using sections to define paraboloids, but in this case the FPGA itself calculates these based on its current state and the next initial values. These sections are then stored in a separate part of the memory, so the Main can not modify it. The transition occurs immediately after uploading the new sections, this way ensuring that the outputs are already in the correct initial position when starting executing the sections.

Section manager

Since the instruments controlled by the FPGA are not completely independent, we introduced a section manager that collects data from all the devices and synchronizes their settings. In some cases for example, when a device needs a parabolic output, it can happen that when calculating the sections for these devices, the sum of their length won’t be exactly the same as the globally defined length. This happens due to rounding errors, and even though the ratio of these error are quite small (< 10⁻³
), they can not be neglected.

At first, this won’t pose any problems, but since these section run periodically again and again, the different channels will go out of synchronization which will severely affect the imaging quality.

The section manager deals with this problem in a way, that if it detects that under the current setting a timing error would occur, it overrides the section lengths for those devices that don’t use any rounding when calculating the sections. Even though this will result in a slightly different timing than the user specified, the ratio of difference as mentioned, in below 10⁻³
, so the overall image quality won’t be affected.

The section manager also has the ability to qualitatively change the behaviour of a device. The laser for example has two modes of operation, one with galvo and one without it. For more details see sections Laser (3.2.4) and Galvo (3.2.5).

25

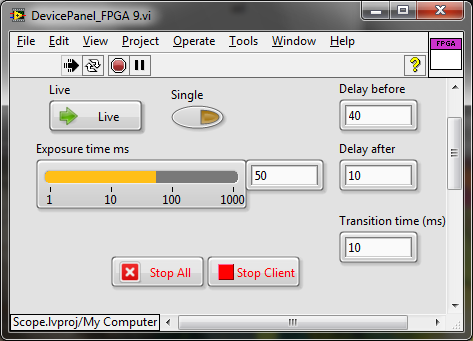
[picture p60: figure]

Figure 3.4: User interface for FPGA. In this interface the user can specify all the timing values of an imaging cycle, including the exposure time and delays before and after exposure. Values have to be provided in milliseconds. When in live mode (see Automator, section 3.2.1) the user can also control the trigger output using the Live and Single buttons.

User interface

The FPGA settings can be modified through a specific front panel (Figure 3.4). Since

most of the other devices depend on the FPGA, especially those used for the actual

imaging, the timing has to set here. This includes setting an exposure time, and a delay before and after the exposure. The reason we have 2 different delays instead of just one, is that this solution offers more flexibility when designing the triggers of an imaging cycle.

The front panel also has two buttons, Live and Single. When the microscope is in live mode (i.e. started but not acquiring images), the FPGA by default doesn’t send any

triggers yet. The user can control the trigger output by turning Live on or off on the FPGA front panel. Turning this on will start sending triggers to all connected devices continuously. To offer a better control, when Single is selected and turning Live on, the FPGA will send only one period of the triggers instead of a continuous signal. This allows the user to have a more precise control over the amount of laser used, which can significantly reduce photobleaching effects occurring while setting up the experiment.

Additional to the settings above, one can also specify the length of the smooth transition that occurs when updating the analog sections on the FPGA.

### 3.2.3 Camera

Cameras are handled on a different computer (see Figure 3.1) for two reasons. First,

compared to the other devices, they have significantly more options, and thus it requires more elaborate programming to control them. Even though most cameras share some basic settings, they can be very different depending on the manufacturer. Because of this, the Camera Control program is completely separate from the Main, and uses a simple command-based communication over TCP/IP. This approach allows us to easily expand

the range of supported cameras by just implementing the appropriate functions for this command-based operation.

The other reason to have the cameras on a different computer is that they produce

26 such incredible amount of data in a short period of time, that serious computing power is needed just to store the images. To ensure smooth operation, this process needs to be handled on a different computer than the one that runs Main. The dedicated camera computer generally has more RAM (typically 24 GB), and uses a RAID 0 array of up to

7 hard drives.

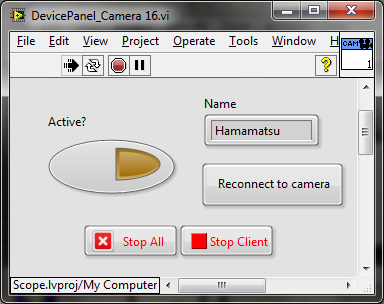
[picture p61: figure]

Figure 3.5: User interface for camera

The user interface has two parts: one runs on the main computer, while the other on the dedicated camera computer. The program on the main computer (Figure 3.5) is really

simple. It only has two options, a button to reconnect to the camera computer in case the connection was lost, and a switch to select whether to use the camera for imaging or not. This function is useful when using the program with more than one cameras (such as in case of the symmetric SPIM), but we don’t need both to image at the same time.

The program on the camera computer differs with each type of camera, but the structure is the same. After initializing the camera, and connecting to Main through TCP/IP,

the camera program starts three parallel loops.

The first loop has three states, and it defines the camera operation mode. These can be idle, continuous image acquisition or finite image acquisition. Idle mode is self explanatory, continuous mode is used when the Main is in live mode, while finite is used when imaging a stack, since in this case the number of images to acquire are predefined.

The second loop constantly listens for user interactions on the camera program front panel. These include for example setting the ROI or the binning of the camera, along with some camera specific setting, such as operating mode of the sensor, camera cooling, or trigger mode.

The third loop listens to the Main through the TCP/IP communication, and performs

the appropriate functions, acknowledging completion by replying to the command. These commands include for example getting camera settings, initializing directory structure, or starting finite image acquisition. In most of the cases, when the camera completed the action, it just replies with ”Done”, however in the case of getting the camera settings, it also sends a user readable string that contains the most important settings along with all of the setting flattened to a string. The Main uses the user readable string to display it in the Automator window, but has no knowledge how to interpret the full settings. These

27 settings are just stored in the appropriate channel data, and before starting to image a stack, they are sent back to the camera control computer which can interpret it, and will set the camera accordingly.

### 3.2.4 Laser

The lasers are controlled through a digital and an analog channel simultaneously. The analog channel sets the laser power, while the digital channel controls the blanking. The input typically ranges from 0–1 V to 0–5 V based on the laser model. When configuring a new laser for the program, one has to provide this range together with the channels used by the FPGA, and the wavelength of the laser. The user has the option to configure up to 6 laser lines which will share the same front panel (Figure 3.6).

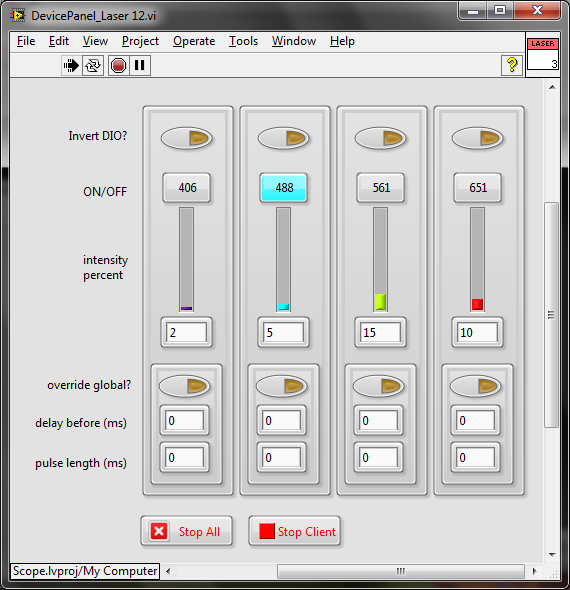
[picture p62: figure]

Figure 3.6: User interface for laser

The front panel is dynamically generated based on the current laser configuration. The number of controls appearing depends on the laser lines configured, and each of these controls are colored based on the wavelength specified. On the laser on/off button the

wavelength is also displayed in numbers for easy identification.

Each laser line has several options, but the most important is the on/off switch and the

slider to set the power. The number on this slider shows the intensity output in percentage of the maximum power. Although usually the laser triggers have to be synchronized with the camera triggers, in some cases this might not be enough. For example, in STED (stimulated emission depletion microscopy) [20] a series of different laser pulses are used

before the actual imaging. To this end, we implemented an override function which can be enabled separately for each laser line. When this option is enabled, the laser line will use its own timing information that can be set to any desired value.

28

Operating the laser through Main is rather simple, each channel only requires 3 sections (Table 3.1). The timing for both the analog and digital channels are the same, each defined by the FPGA settings exposure (nexp), delay before (nd1

) and delay after (nd2

).

These sections use constant values, so Dvalue and DDvalue remains 0 for all of them. The only thing that varies is the value, during exposure the digital trigger is high, and the analog line sets the voltage corresponding to the required output power.

The laser has a second operation mode, depending on the system configuration. If the microscope uses a galvo to generate a virtual light-sheet, the laser pulses are synchronized with the linear movements of the galvo (see Galvo, section 3.2.5).

1 | 2 | 3
length | nd1 | nexp | nd2
value | 0 | 1 | 0
type | 1 | 1 | 1
(a) Digital sections
1 | 2 | 3
length | nd1 | nexp | nd2
value | 0 | I | 0
Dvalue | 0 | 0 | 0
DDvalue | 0 | 0 | 0
type | 111 | 111 | 111
(b) Analog sections

Table 3.1: Sections used by Laser. Laser output is defined in 3 sections on both analog and digital channels. A digital channel is used to enable or disable laser blanking, while the analog signal sets the laser intensity. Note that for the analog channels, only one section would be sufficient that stores the intensity, since the digital line controls on/off state. Abbreviations: nd1
: delay length before exposure, nexp: exposure length, nd2

: delay length after exposure, I: laser intensity.

### 3.2.5 Galvo

A galvo, or galvanometer-driven laser scanning mirror is used to generate the virtual light-sheet for the microscope. This is controlled through an analog channel quite simply: the galvanometer turns a mirror attached to it based on the input voltage. Although modern

galvos can scan with a high speed, up to 1000 Hz, they are very delicate instruments, and one has to be careful when operating them. This was one of the main reasons why we implemented the smooth transition function on the FPGA (see section 3.2.2).

To achieve an evenly illuminated light-sheet, the scanning has to be done linearly, and more than once if possible during the exposure. Generally this would be achieved by a triangle signal, but in the case of the galvo we can’t use it. Because the signal is translated to a mechanical movement, and its derivative at the turning point is not continuous, this would mean an infinite acceleration for the galvo. To avoid this, and avoid damaging the instrument, we use short parabolic segments at the turning point.
One scanning period consists of 6 parts (Table 3.2 and Figure 3.7). The first three

corresponds to acceleration, linear scanning and deceleration. The second three are very similar, only in the opposite direction. The turn time can be controlled by the user, by changing the turn time percentage parameter on the front panel (Figure 3.8). This is a

percentage of the exposure time that will be used for turning the galvo. Since in this time

29

| 0 | 6n + 1 | 6n + 2 | 6n + 3 | 6n + 4 | 6n + 5 | 6n + 6 | 6N + 1
length | nd1 | n1 | n2 | n1 | n1 | n2 | n1 | nd2
value | A + U0 | A + U0 | 0 | 0 | 0 | 0 | 0 | A + U0
Dvalue | 0 | 0 | v | 0 | 0 | v | 0 | 0
DDvalue | 0 | a | 0 | −a | −a | 0 | a | 0
type | 111 | 111 | 110 | 100 | 100 | 110 | 100 | 111

Table 3.2: Analog Sections used by Galvo. The sections can be divided in 3 parts: delay before exposure, exposure and delay after exposure. The first (0) and last (6N + 1) sections represent the delays, while the others are used to generate the scanning motion. One scan is again divided into 6 sections: acceleration, linear, deceleration and the same in the opposite direction. n ∈ {1, 2, ..., N −1} ⊂ N, where N is the number of scans performed during an exposure. Note that at the beginning of each scan, the value is also reset to the initial position. Even though the FPGA uses 48 bit upsampling when calculating the sections, some rounding errors can still occur, especially for faster transitions. Setting the initial value at the beginning of a scan counteracts the accumulating error. nd1

| | , nd2

: length before and after exposure, n1: length of acceleration/deceleration, n2: length of linear section, v: slope of the linear section, a: acceleration, A: amplitude, U0: offset

0 | 50 | 100 | 150

0.0 1.5 3.0

Camera triggers

time (ms)

voltage (V)

0 | 50 | 100 | 150

0.0 1.5 3.0

Laser triggers

time (ms)

voltage (V)

0 | 50 | 100 | 150

−0.02 0.00 0.02

Galvo signal

time (ms)

voltage (V)

Figure 3.7: Signals sent to devices when a galvo is used. The signals displayed use the following timing settings: exposure time: 50ms, delay: 50ms, turn time percentage: 32%, scan amplitude: 0.02V, number of scans: 2. Laser triggers are synchronized with the galvo scanning: the laser is only on, when the galvo is in a linear section. This ensures even illumination through the whole field of view. Camera triggers are unaffected. Turn time percentage is exaggerated for demonstration purposes, typically 10% is used.

30 the galvo movement is not linear, the laser is switched off to avoid uneven illumination at the sides. This synchronization is done by the Section manager of the FPGA (see FPGA, section 3.2.2).

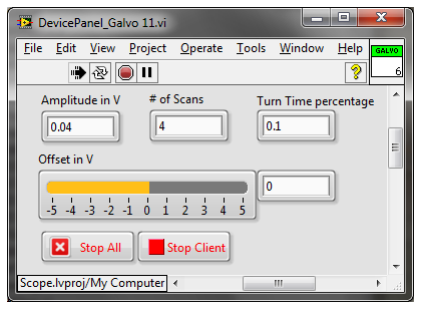
[picture p63: figure]

Figure 3.8: User interface for galvo The following parameters can be changed: scanning amplitude, offset, number of scans and turn time percentage.

### 3.2.6 Stage

To position the sample, a piezoelectric translation stage is used. Depending on the configuration, the stage can use 1, 2 or 3 translation axes. The micro-controller of this device uses an analog input signal in the range of 0–10V, and positions the stage between its boundaries accordingly. Every axis has its own input signal, each coming from its own channel on the FPGA.

During the hardware configuration, the number of axes has to be specified along with the channel number and the direction (this is only needed for displaying). Each axis also

needs a lower and upper boundary, specified in µm. Finally, the user has to provide the scaling factor from µm to Volt, so the FPGA will use the correct values.

Through the front panel (Figure 3.9) the user can move the stage to different positions using the arrow buttons for X and Y direction, and the + and − signs for Z direction. The

step can be specified in the DXYZ field. Apart from interacting with the buttons, one can directly specify the position value in the X, Y and Z fields in µm. These values will be coerced to the physical boundaries of the device, which was given during the hardware configuration.

This front panel is also used to define the Stacks (see Automator, section 3.2.1). One

can specify the starting and end position of the stage, and the number of images to take. Based on these values, the front panel automatically displays the distance between the planes, so the user has a better feedback. It is also possible to reverse a stack, which is useful when imaging with multiple channels. In principle it is possible to link more channels to the same stack, but in that case when the first channel is ready, the stage will move back again to the starting position. If the user specifies two stacks for the two channels, both between the same positions but in the opposite direction, the jumping will not occur.

31

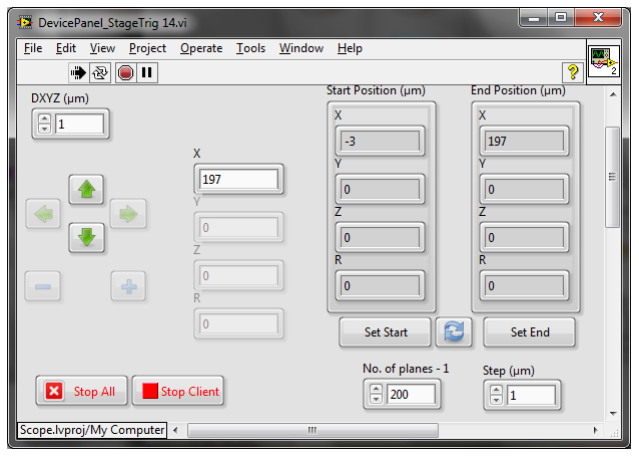
[picture p64: figure]

Figure 3.9: User interface for stage. The arrow, + and − buttons can be used to move the stage by the value specified in DXYZ. It is also possible to directly write the new position in the fields X, Y or Z. A stack is defined by setting the starting and end position using the SetStart and SetEnd buttons, and specifying the number of planes. The user interface adapts itself to the stage configuration, allowing to change only those axes that were previously defined. This illustration only uses the X axis.

While in run mode, in the PreStack phase, a single stack is uploaded to the FPGA with the starting position of the stage. This will smoothly move the stage to the correct position using the automatic smooth transition feature of the FPGA. Since this section will never run actually, its length is irrelevant, so we just use a length of one tick.

Once the Main enters the Execute stack function, the stage will use 3 sections for the translation movement (Table 3.3). For the time of the first delay and the exposure the

stage will stay in the same positions, and during the second delay the stage will move to the next position. This movement consists of two parts, an acceleration and a deceleration, so there will be no jumps. In each section only the DDvalue is updated, all other values are taken from the previous sections. To compensate for unlikely but possible rounding errors, the first section also sets the Dvalue to 0. This makes sure, that the stage will stay in the same position for the whole exposure time.

| 0 | 1 | 2 | 3
length | 1 | nd1 + nexp | nd2
| | | /2 | nd2

/2
value | U0 | 0 | 0 | 0
Dvalue | 0 | 0 | 0 | 0
DDvalue | 0 | 0 | a | −a
type | 111 | 110 | 100 | 100

Table 3.3: Analog sections used by the stage.

### 3.2.7 Filter wheel

The filter wheels used by our group communicate through a COM port, via the VISA communication protocol. When setting up the microscope’s hardware configuration, one has to specify the COM port, and based on the filter wheel model, also the wheel to use.

32

These can accommodate 6 to 10 filters. During the hardware setup the filter types can be specified in an array of strings, with the array index corresponding to the filters physical position in the wheel.
While in live mode, the front panel (Figure 3.10) shows a drop-down list containing the

previously specified filter names. Changing the value immediately takes effect, because this device is not controlled by the FPGA.
During imaging, the filter wheel is only used in the PreChannel function, where it is set to the correct position specified by the current channel setting.

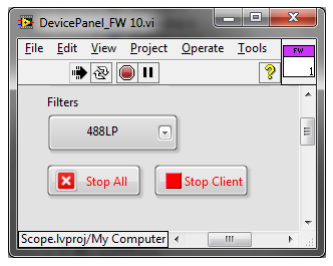
[picture p65: figure]

Figure 3.10: User interfaces for filter wheel The front panel show a drop-down list with the available filter names. Using this, the user can specify the filter to be used for imaging.

### 3.2.8 Shutter

A shutter is a mechanical device that can move in and out of the laser’s illumination path.

Using this device it is possible to switch between the illumination and imaging path. The devices we use require a digital input, 0 meaning an open shutter and 1 meaning closed. To control this device, the FPGA only needs one section, a section with the length of an imaging cycle (nd1 + nexp + nd2

), and a value to determine the state. The user can change the state on the front panel (Figure 3.11), and also has the possibility to set a

waiting time in seconds. This should correspond to the time the shutter needs to switch between the states. Before executing a stack the shutter is set to the correct position and the program waits for it to complete movement before starting the imaging.
Although this is the simplest device of all, it can be versatilely used with other devices also. Instead of a shutter for example, it is possible to use this class to control a flipping mirror. Such mirror can be used to alter the laser path, which can also be used to switch between different illumination paths.

33

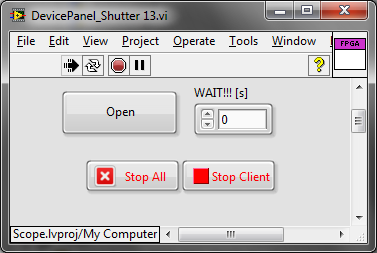
[picture p66: figure]

Figure 3.11: User interface for shutter The simplest device only have two options: a button to choose whether the shutter is open or closed, and a delay specified in seconds. This delay is used in the run mode: before starting to take the images the program will wait for the shutter to perform the movement.

34

# Chapter 4

# Results

In this chapter I will describe the symmetrical SPIM we built based on the principles discussed in Chapter 2, and present some images that were acquired using the program described in Chapter 3.

## 4.1 Microscope setup

The setup is built on a Melles Griot optical table that uses Newport laminar-flow isolators as legs. The optical components are mounted on a 65 mm rail system. To achieve symmetric imaging two identical objectives (O1 and O2 on Figure 4.1) are placed perpendicular to each other and 45◦
to the table. The objectives are mounted on custom designed turrets, that are compatible with the rail system. Both turrets have a mechanical translation stage coupled to the objectives which can be used to align the focus. One of the turrets has an additional horizontal translation stage, which adds a third degree of freedom to position the objectives. Both objectives are water-dipping, 40× magnification

with 0.8 numerical aperture.

For illumination an Omicron LightHub

R
-6 laser combiner is used, which houses a 405 nm, 488 nm, 561 nm and 647 nm lasers. The output is coupled to the microscope using fiber optics.

To record the images of the two objectives, the system uses two identical Hamamatsu ORCA-Flash4.0 sCMOS cameras. These cameras have a resolution of 2048 × 2048, pixel

size of 6.5 µm, and can acquire images at 100 fps on full resolution. Readout noise and quantum efficiency is also exceptionally good.

Light-sheet is generated by scanning with the focused laser-beam using a galvanometer-driven scanning mirror (SM). To make sure that the illumination paths are as identical as

possible, the beam is split only after the scanning mirror, immediately after the scan lens (SL). This is done by a 50-50 beam splitter (BS). After the beam splitter, both illumination arms have a 160 mm tube lens (TL) that focuses the beams on the back focal plane

of the objectives. The other focus of these lens coincide with the focus of the scan lens.

35

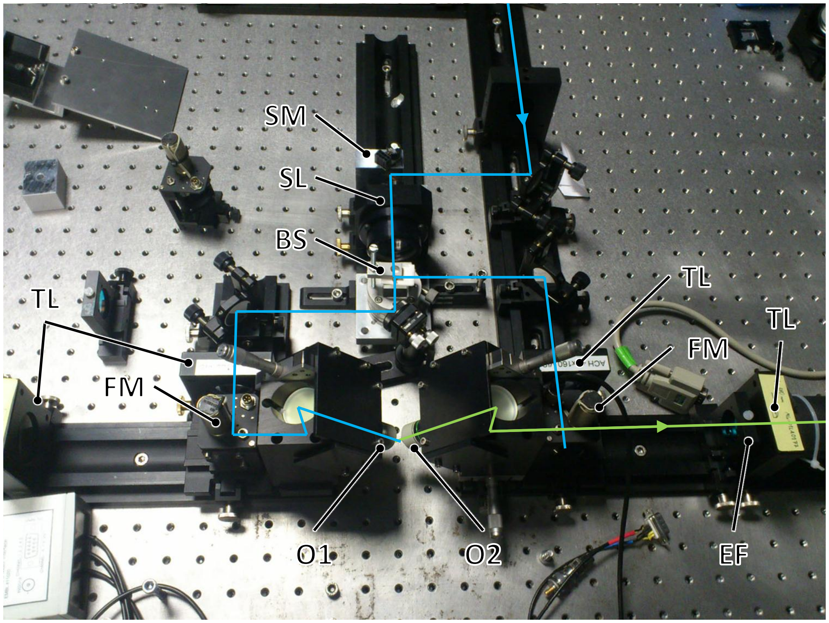
[picture p67: figure]

Figure 4.1: Symmetrical SPIM. Illumination light path shown in blue, fluorescence light path shown in green. The translation stage was taken out to allow a better view on the objective alignment. Abbreviations: O1, O2: objectives, SM: scanning mirror, SL: scan lens, BS: beam splitter, TL: tube lens, FM: flip mirror, EF: emission filter

36

To separate the illumination and imaging paths, a flip mirror (FM) is used to reflect the

illumination light towards the objectives.

To use an objective for imaging, the corresponding flip mirror is opened, and this will allow the light coming from the objective to pass through to the imaging tube lens. This lens will then focus the light on the detector of the camera (not shown on the image).

The imaging path also contains an emission filter (EF), to separate the illumintaion

and fluorescence light. In this case, since for the first time we only imaged using a single channel, these are fixed filters, a filter wheel is not used.

## 4.2 3D imaging

First we used the microscope to image Phallusia mammillata, or white sea squirt embryo. Phallusia m. is a chordate intervertebrate model organism for developmental biology. Although phylogenetically this species is rather far from humans, it’s widely used when studying embryogenesis, since it has relatively small amount of cells, and it is very transparent [21]. This property is especially useful in imaging, using SPIM very clear images

can be obtained of these embryos.

Since Phallusia m. is a sea creature, imaging is also performed in seawater. Labelling is done using the fluorescent dye FM4-64, which attaches to the cell membrane and has a quite broad emission and absorption spectrum [22]. The embryos were attached to glass

plates mounted on the stage, submerged in seawater. For imaging we used 488 nm laser, 50 ms exposure time and 2 µm translation. Because of the 45◦ arrangement, this resulted in a √
2 µm distance between the planes.
After taking a stack, it was affine transformed, to reverse the shear effect of the 45◦

translation (see Image registration, section 2.2.1) using the open source application Fiji [23]. The result is shown on Figure 4.2.

## 4.3 Time-lapse imaging

To test the stability of the system, we imaged the same Phallusia m. embryo for 4 hours, every 2 minutes using the same setting as described before. All the images were acquired, and the specimen stayed in the same position. After affine transforming all of the stacks, we generated a 3D projection of each using Fiji. These projections are then used as frames in a time lapse movie. Figure 4.3 shows every 5 frame of this movie.

## 4.4 Confocal imaging with light-sheet microscopy

It was recently shown, that using Hamamatsu sCMOS cameras it is possible to combine light-sheet microscopy with line-scanning confocal microscopy [24]. In this setup,

37

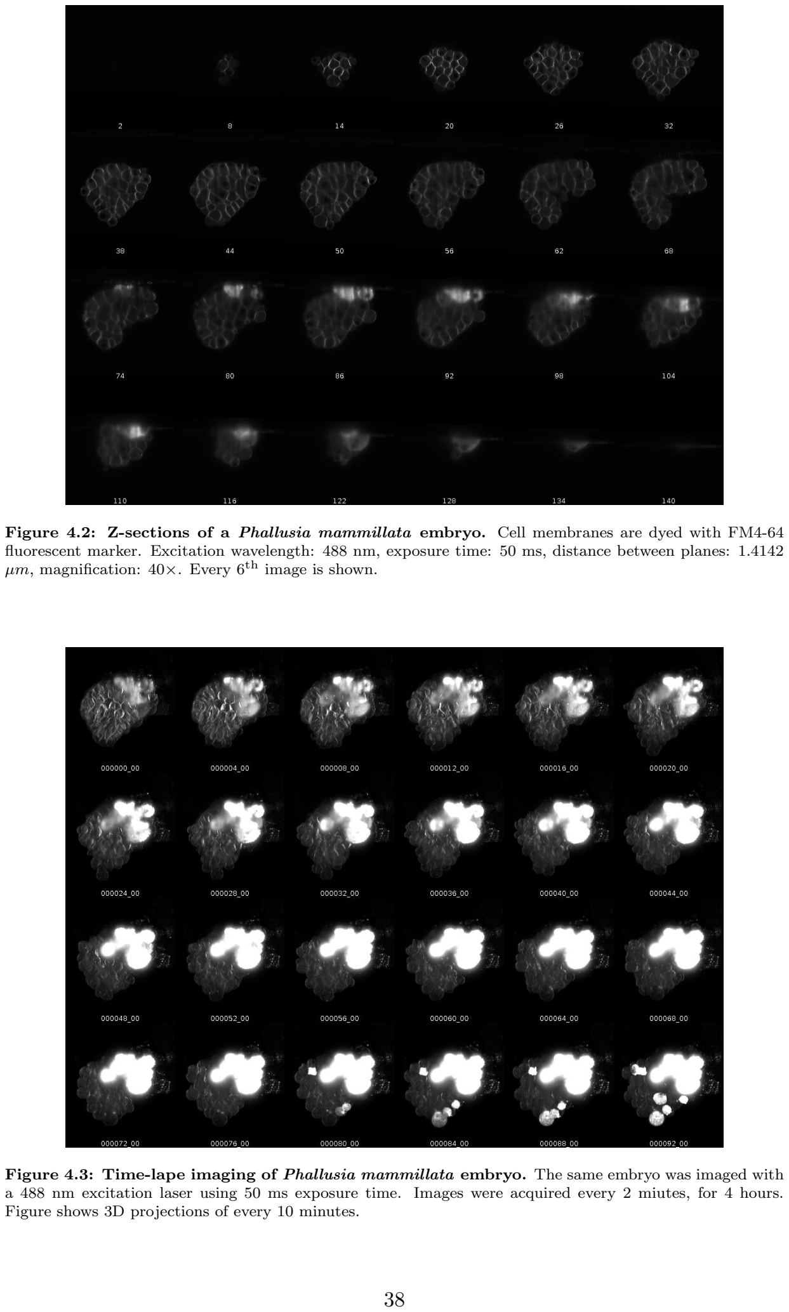
[picture p68: page 44]

Figure 4.2: Z-sections of a Phallusia mammillata embryo. Cell membranes are dyed with FM4-64 fluorescent marker. Excitation wavelength: 488 nm, exposure time: 50 ms, distance between planes: 1.4142 µm, magnification: 40×. Every 6th image is shown.

Figure 4.3: Time-lape imaging of Phallusia mammillata embryo. The same embryo was imaged with a 488 nm excitation laser using 50 ms exposure time. Images were acquired every 2 miutes, for 4 hours. Figure shows 3D projections of every 10 minutes.

38

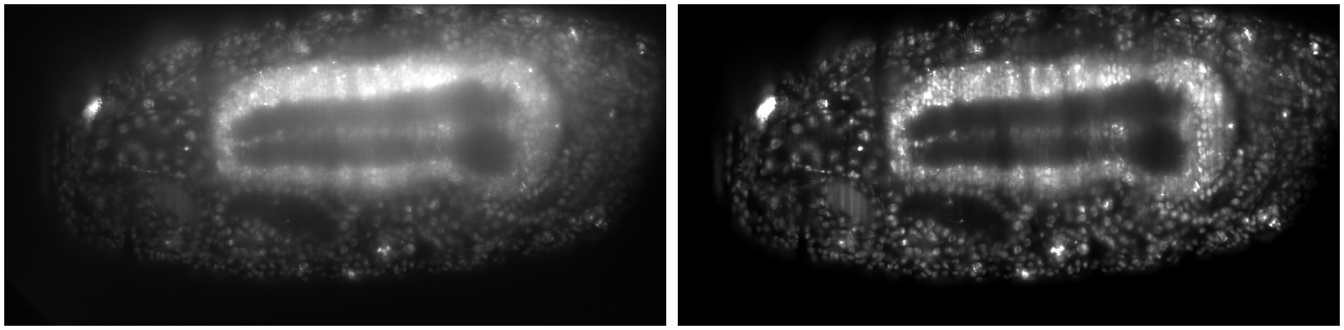
[picture p69: figure]

(a) (b)

Figure 4.4: Drosophila melanogaster embryo. Images were taken of a single beam in different positions and fused later using two different methods. 4.4a shows the result of a simulated global shutter mode, while 4.4b shows the result of a simulated rolling shutter mode. The rolling shutter results in a much clearer image with less scattering and more contrast.

the scanning of the laser is synchronized with the camera readout, thus excluding sidescattered light from imaging. However, to achieve this type of imaging, one has to use a rolling shutter instead of a global shutter. This means, that exposure of the chip is done row by row with a slight delay, and readout is also done in the same manner after some integration time. Depending on when the readout starts, one can set the width of this virtual slit.

To test if our setup would also benefit from this kind of image registration, we imaged a Drosophila melanogaster embryo that expressed mCherry histone marker. Since implementing the rolling shutter mode, and synchronizing it with the scanning wasn’t the objective of this project, we imaged the specimen illuminated with a single beam at different positions and merged the images in Fiji to simulate the slit mode.

The embryo was illuminated with a 561 nm laser, using 20 ms exposure time and 20 ms delay. The embryo was fully covered with 85 different positions of the beam, so imaging took 3.4 seconds. After acquiring the images, the images were fused using two different methods. First, the images were simply averaged, with this representing the global shutter mode (Figure 4.4a). In the second method before averaging, we applied a non-linear filter to all of the frames, this way simulating the effect of the slit (Figure 4.4b).

Difference between the two images is striking. The image simulating the rolling shutter mode has significantly less scattering, higher contrast and overall better image quality. This image registration method would be especially useful when imaging opaque samples (such as Drosophila m.), but more transparent samples would also benefit from the better

contrast.

## 4.5 Discussion

Single plane illumination microscopy is a rapidly growing part of optical microscopy. It’s use of a thin illumination plane to excite fluorophores is much more efficient than the

39 scanning method of confocal microscopy. Since the method uses two objectives in a perpendicular alignment, the axial resolution of the system is greatly improved. Fast imaging and low illumination power makes this technique especially useful when investigating developmental biological processes, such as early embryo development.
In this work, I summarized the basic principles of selective plane illumination microscopy, and took part in developing a symmetrical SPIM system, that is designed to operate on high speeds, and offers near isotropic 3D images through image fusion. Moreover, a custom program was developed in LabView, which enables easy control and automation of the microscope setup, as well as other similar setups. The program was ultimately tested on three different microscopes, using rather different hardware configurations, and in all three cases it performed above expectations.
Using this program, and the prototype of the symmetrical SPIM, we imaged a live Phallusia m. embryo for an extended time, and showed, that despite the lack of rotation, dense specimens, such as Drosophila m. embryos can also be imaged with high quality if using a (simulated) rolling shutter exposure mode.

Further plans for this microscope include implementing the rolling shutter mode for enhanced image quality, adding real-time image processing capabilities for automatic selfcalibrating, and adding a multi-positioning stage for possible screening applications.

40

## Acknowledgements

I would like to thank Lars Hufnagel for this opportunity to work in his group, and involving me in developing this microscope system. He gave me a lot of support, and helped in understanding and solving the possible difficulties that we came across during the development process.

I greatly appreciate the help of Uroš Kržič, who gave me an insight on the principles of selective plane illumination microscopy, and also prepared some illustrations for this work.

I thank Stefan Günther for providing the Drosophila m. embryos, and Ulla-Maj Fiuza for providing the Phallusia m. embryos.

Finally, I would like to thank Gustavo Quintas Glasner de Medeiros and Nils Norlin, as they both participated in the microscope design and program development, and both of them inspired me greatly. Without their help, I couldn’t have written this paper.

42

# References

[1] J. W. Lichtman and J.-A. Conchello, “Fluorescence microscopy,” Nature Methods, vol. 2, no. 12, pp. 910–919, Dec. 2005. [Online]. Available: http://www.nature.com/nmeth/journal/v2/n12/full/nmeth817.html (http://www.nature.com/nmeth/journal/v2/n12/full/nmeth817.html) 4
[2] R. F. Service, “Three Scientists Bask in Prize’s Fluorescent Glow,” Science, vol. 322, no. 5900, pp. 361–361, Oct. 2008. [Online]. Available: http://www.sciencemag.org/content/322/5900/361 4
[3] N. C. Shaner, P. A. Steinbach, and R. Y. Tsien, “A guide to choosing fluorescent proteins,” Nature Methods, vol. 2, no. 12, pp. 905–909, Dec. 2005. [Online]. Available: http://www.nature.com/nmeth/journal/v2/n12/full/nmeth819.html 4
[4] S. Grill and E. H. K. Stelzer, “Method to calculate lateral and axial gain factors of optical setups with a large solid angle,” Journal of the Optical Society of America A, vol. 16, no. 11, pp. 2658–2665, Nov. 1999. [Online]. Available: http://josaa.osa.org/abstract.cfm?URI=josaa-16-11-2658 5
[5] E. Stelzer and S. Grill, “The uncertainty principle applied to estimate focal spot dimensions,”
Optics Communications, | vol. 173, | no. 1–6, | pp. 51–56, | Jan. 2000. [Online]. Available:
http://www.sciencedirect.com/science/article/pii/S0030401899006446 5
[6] P. Davidovits and M. D. Egger, | “Photomicrography of Corneal Endothelial Cells in
vivo,” Nature, vol. 244, no. 5415, pp. 366–367, Aug. 1973. [Online]. Available: | http:
//www.nature.com/nature/journal/v244/n5415/abs/244366a0.html 6
[7] S. Aldaz, L. M. Escudero, and M. Freeman, “Live Imaging of Drosophila Imaginal Disc Development,” Proceedings of the National Academy of Sciences, vol. 107, no. 32, pp. 14 217–14 222, Aug. 2010. [Online]. Available: http://www.pnas.org/content/107/32/14217 7
[8] E. G. Reynaud, U. Kržič, K. Greger, and E. H. Stelzer, “Light sheet-based fluorescence microscopy: more dimensions, more photons, and less photodamage,” HFSP Journal, vol. 2, no. 5, pp. 266–275, Oct. 2008. 7, 9
[9] E. H. Stelzer and S. Lindek, “Fundamental reduction of the observation volume in far-field light microscopy by detection orthogonal to the illumination axis: confocal theta microscopy,” Optics Communications, vol. 111, no. 5–6, pp. 536–547, Oct. 1994. [Online]. Available: http://www.sciencedirect.com/science/article/pii/0030401894905339 8
[10] U. Kržič, “Multiple-view microscopy with light-sheet based fluorescence microscope,” Ph.D. dissertation, Ruperto-Carola University of Heidelberg, Germany, 2009. 8, 11
[11] H. | Siedentopf | and | R. | Zsigmondy, | “Uber | Sichtbarmachung | und | Größenbestimmung
ultramikoskopischer | Teilchen, | mit | besonderer | Anwendung | auf | Goldrubingläser,” | An-
nalen | der | Physik, | vol. | 315, | no. | 1, | pp. | 1–39, | 1902. | [Online]. | Available:
http://onlinelibrary.wiley.com/doi/10.1002/andp.19023150102/abstract 9
[12] J. Huisken, J. Swoger, F. Del Bene, J. Wittbrodt, and E. H. K. Stelzer, “Optical Sectioning Deep Inside Live Embryos by Selective Plane Illumination Microscopy,” Science, vol. 305, no. 5686, pp.

43

1007–1009, 2004. [Online]. Available: http://www.sciencemag.org/content/305/5686/1007.abstract 9

[13] J. Huisken and D. Y. R. Stainier, “Selective plane illumination microscopy techniques in developmental biology,” Development, vol. 136, no. 12, pp. 1963–1975, Jun. 2009. [Online]. Available: http://dev.biologists.org/content/136/12/1963 9
[14] M. Weber and J. Huisken, “Light sheet microscopy for real-time developmental biology,” Current Opinion in Genetics & Development, vol. 21, no. 5, pp. 566–572, 2011. [Online]. Available: http://www.sciencedirect.com/science/article/pii/S0959437X11001444 9
[15] P. J. Keller, A. D. Schmidt, J. Wittbrodt, and E. H. K. Stelzer, “Reconstruction of Zebrafish Early Embryonic Development by Scanned Light Sheet Microscopy,” Science, vol. 322, no. 5904, pp. 1065–1069, Nov. 2008. [Online]. Available: http://www.sciencemag.org/content/322/5904/1065 9
[16] H.-U. Dodt, U. Leischner, A. Schierloh, N. Jährling, C. P. Mauch, K. Deininger, J. M. Deussing,
M. Eder, W. Zieglgänsberger, and K. Becker, “Ultramicroscopy: three-dimensional visualization of neuronal networks in the whole mouse brain,” Nature Methods, vol. 4, no. 4, pp. 331–336, Mar. 2007. [Online]. Available: http://www.nature.com/nmeth/journal/v4/n4/full/nmeth1036.html 9
[17] U. Krzic, S. Gunther, T. E. Saunders, S. J. Streichan, and L. Hufnagel, “Multiview light-sheet microscope for rapid in toto imaging,” Nature Methods, vol. 9, no. 7, pp. 730–733, Jul. 2012. [Online]. Available: http://www.nature.com/nmeth/journal/v9/n7/full/nmeth.2064.html 9, 19
[18] K. Greger, J. Swoger, and E. H. K. Stelzer, “Basic building units and properties of a fluorescence single plane illumination microscope,” Review of Scientific Instruments, vol. 78, no. 2, pp. 023 705– 023 705–7, Feb. 2007. [Online]. Available: http://rsi.aip.org/resource/1/rsinak/v78/i2/p023705 s1 11
[19] B. E. A. Saleh and M. C. Teich, Fundamentals of Photonics. John Wiley & Sons, Mar. 2007. 11
[20] S. W. Hell and J. Wichmann, “Breaking the diffraction resolution limit by stimulated emission: stimulated-emission-depletion fluorescence microscopy,” Optics Letters, vol. 19, no. 11, pp. 780–782, 1994. [Online]. Available: http://ol.osa.org/abstract.cfm?URI=ol-19-11-780 28
[21] C. A. Ettensohn, G. A. Wray, and G. M. Wessel, Methods In Cell Biology: Development Of Sea Urchins, Ascidians, And Other Invertebrate Deuterostomes: Experimental Approaches. Academic Press, 2004. 37
[22] S. Bolte, C. Talbot, Y. Boutte, O. Catrice, N. D. Read, and B. Satiat-Jeunemaitre, “FM-dyes as experimental probes for dissecting vesicle trafficking in living plant cells,” Journal of microscopy, vol. 214, no. Pt 2, pp. 159–173, May 2004. 37
[23] J. Schindelin, I. Arganda-Carreras, E. Frise, V. Kaynig, M. Longair, T. Pietzsch, S. Preibisch,
C. Rueden, S. Saalfeld, B. Schmid, J.-Y. Tinevez, D. J. White, V. Hartenstein, K. Eliceiri,
P. Tomancak, | and A. Cardona, | “Fiji: | an open-source platform for biological-image
analysis,” Nature Methods, vol. 9, no. 7, pp. 676–682, Jul. 2012. [Online]. Available: http://www.nature.com/nmeth/journal/v9/n7/full/nmeth.2019.html 37
[24] E. Baumgart and U. Kubitscheck, “Scanned light sheet microscopy with confocal slit detection,” Optics Express, vol. 20, no. 19, pp. 21 805–21 814, 2012. [Online]. Available: http://www.opticsexpress.org/abstract.cfm?URI=oe-20-19-21805 37

44
