balintbalazs/thesis/figures/4_gpu/LLvsB3D.pdf

a | b | c | d

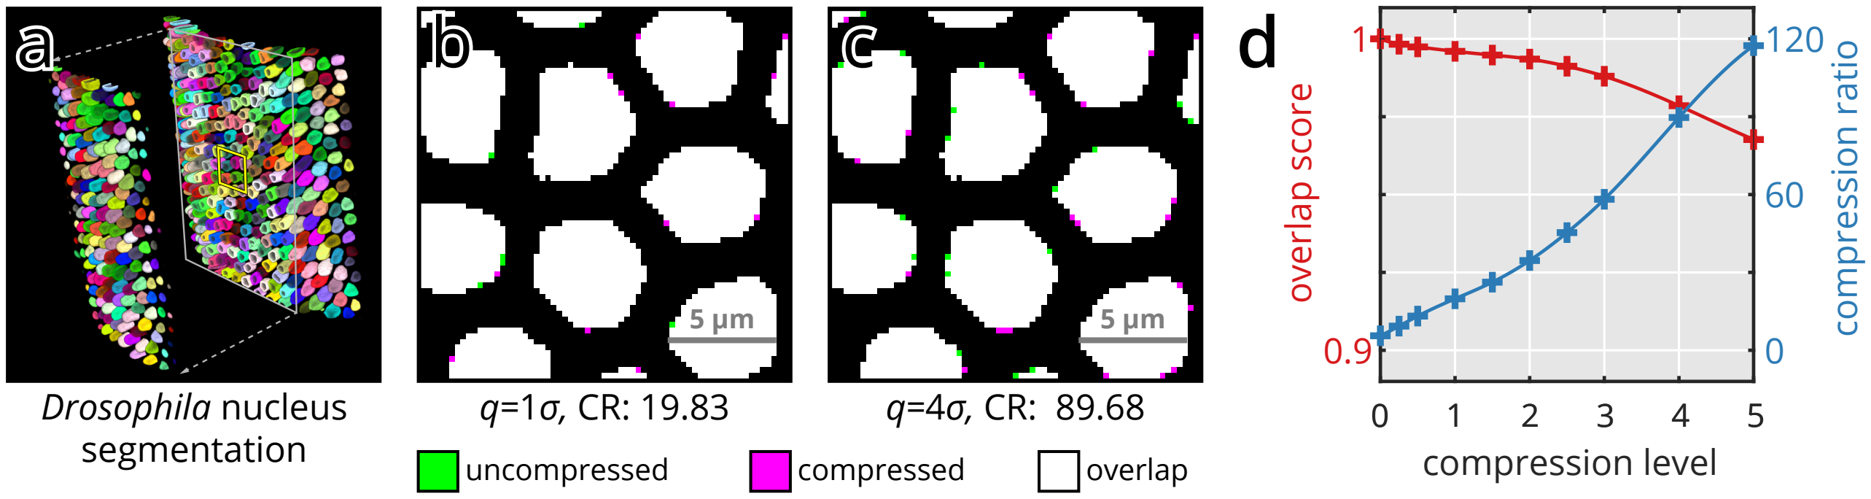
[picture p70: page 1]

0 | 1 | 2 | 3 | 4 | 5
compression level

0.9

1
overlap score
0 | 1 | 2 | 3 | 4 | 5

0

60

120

5 μm | 5 μm

compression ratio

q=1σ, CR: 19.83 | q=4σ, CR: 89.68
uncompressed | compressed | overlap

Drosophila nucleus
segmentation

a | b | c | d

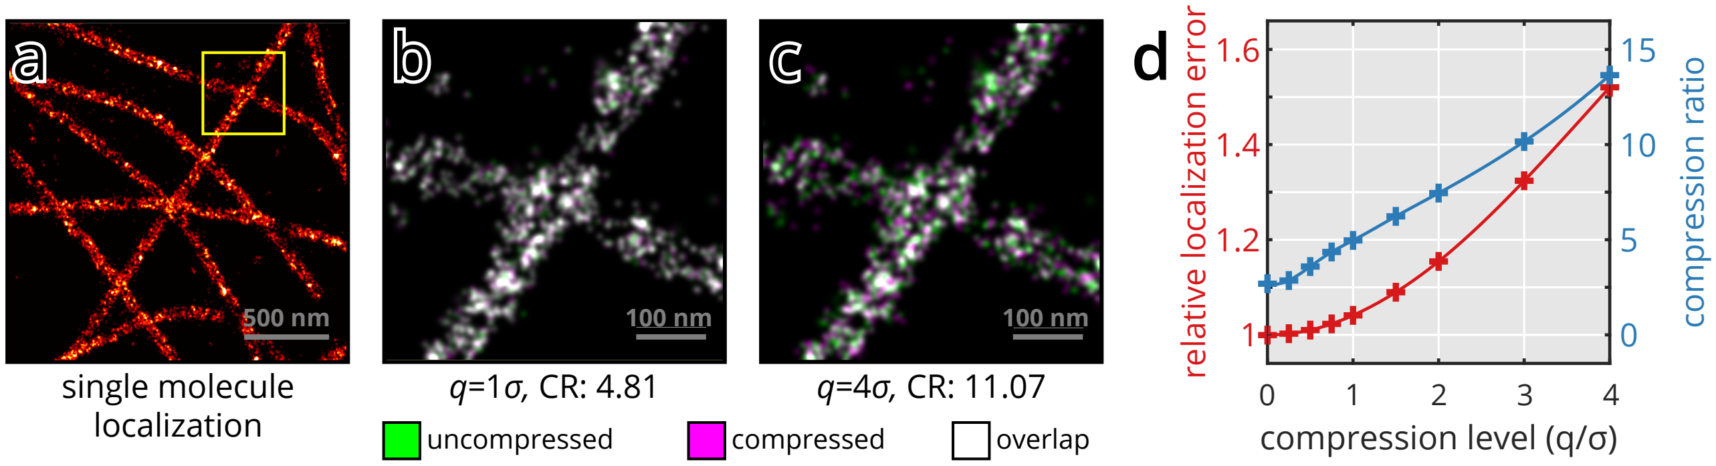
[picture p71: page 2]

0 | 1 | 2 | 3 | 4
FRPSUHVVLRQOHYHOT

1

1.2

1.4

1.6

relative localization error

0

5

10

15
compression ratio
uncompressed | compressed | overlap

100 nm
single molecule | q=1σ, CR: 4.81 | q=4σ, CR: 11.07
localization
500 nm | 100 nm

a | b | c | d

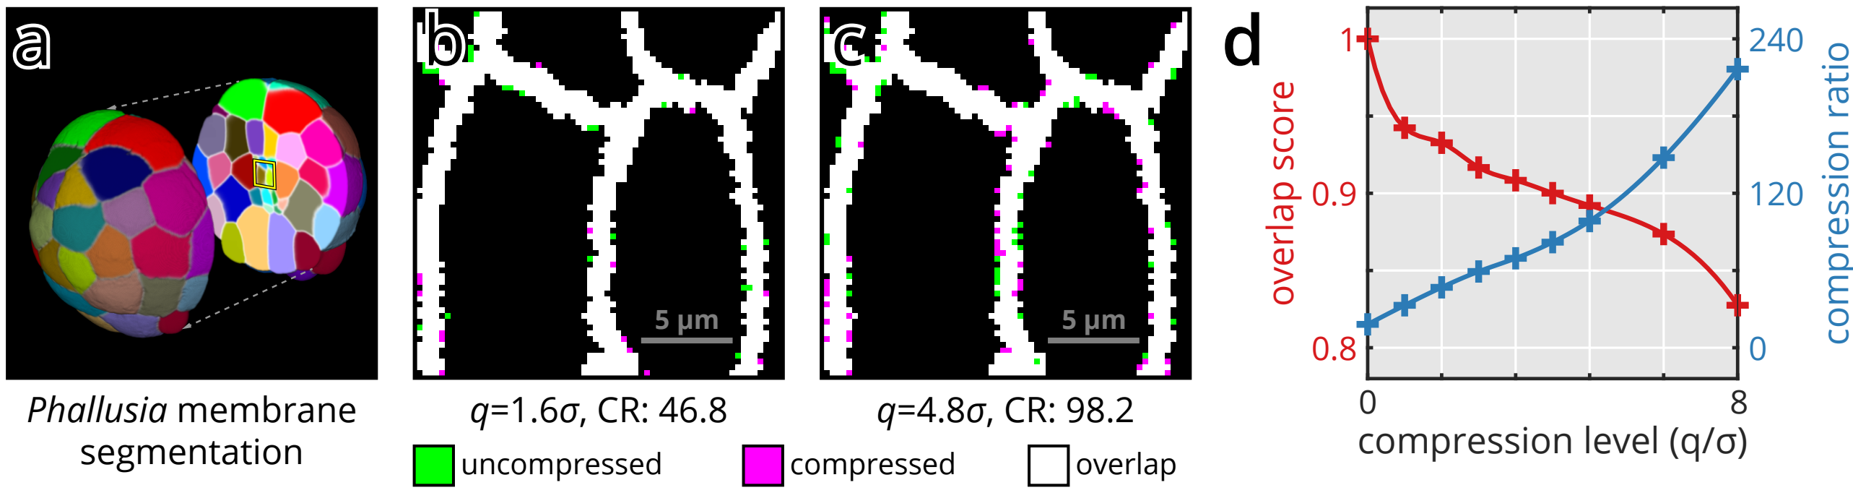
[picture p72: page 3]

FRPSUHVVLRQOHYHOT

0

overlap score

0.8

0.9

1
compression ratio

0

120

240

8
uncompressed | compressed | overlap

### 5 μm

q=1.6σ, CR: 46.8

| | 5 μm
Phallusia membrane | q=4.8σ, CR: 98.2
segmentation
