balintbalazs/thesis/figures/4_gpu/fusion/muvi-spim.pdf

e a

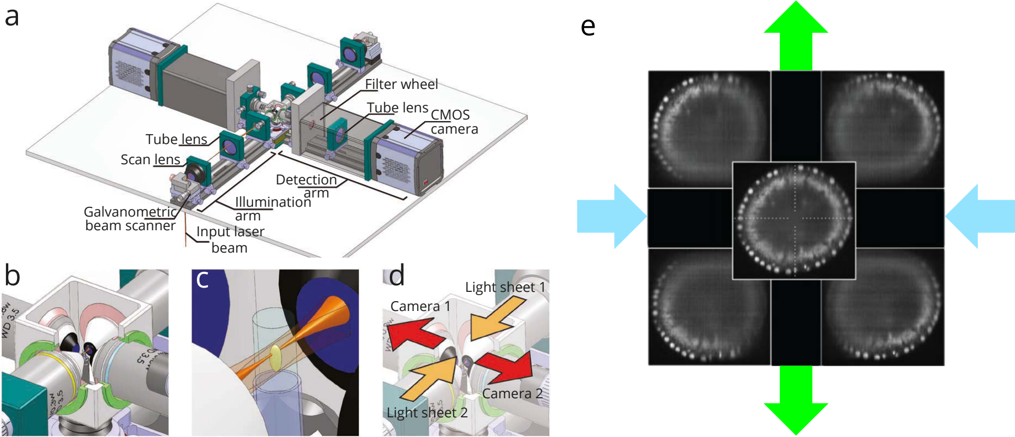
[picture p73: page 1]

b | c | d
| Tube lens

Detection

| | Filter wheel Tube lensCMOS

camera

arm Illumination
arm

Camera 1

Light sheet 1

Camera 2
Light sheet 2

Input laser
beam

Scan lens

Galvanometric
beam scanner
