balintbalazs/thesis/figures/1_spim/mammals/Figure4.pdf

A
D

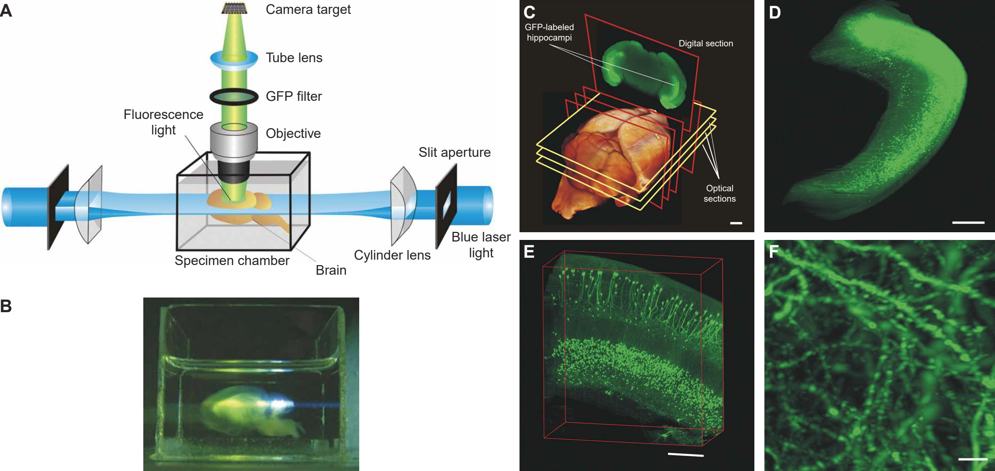
[picture p74: page 1]

Camera target

Tube lens

GFP filter

Objective

Fluorescence
light

Specimen chamber Brain

Cylinder lens

Blue laser
light

Slit aperture

B

GFP-labeled
hippocampi

E

F

Optical
sections

Digital section

C
