balintbalazs/thesis/thesis_booklet_BB_HU.tex

% !TEX program = xelatex
% spell-checker: disable
\documentclass{booklet_style}
\usepackage[magyar]{babel}
%\usepackage[pagewise, mathlines]{lineno}

%\usepackage[draft]{todonotes}
% \usepackage[disable]{todonotes} % notes not showed

\sloppy
\frenchspacing

\input{0_defBib}

\def\b3d{B\textsuperscript{3}D}

\author{\href{mailto:balint.balazs@embl.de}{Balázs Bálint}}
\supervisor{Témavezető: \href{mailto:rozsabal@koki.hu}{Rózsa Balázs, \textit{M.D., Ph.D.}}}
\lab{\href{http://www.embl.de/}{European Molecular Biology Laboratory}}
\university{\href{http://www.ppke.hu/}{Pázmány Péter Katolikus Egyetem}}
\collegeordept{\href{http://www.itk.ppke.hu/}{Információs Technológiai és Bionikai Kar \\ Roska Tamás Műszaki és Természettudományi Doktori Iskola}}
\degreedate{\textit{A Ph.D. disszertáció tézisei} \\ Budapest, 2018}
\ppkelogo{}
\degree{PhD}

\title{Light-sheet mikroszkópia és valós idejű képfeldogozás új szemszögből}
%\date{2012 november}

\begin{document}

\graphicspath{{./figures/}}
%\begin{linenumbers}
\maketitle
%\pagenumbering{roman}

\clearpage{\thispagestyle{empty}\cleardoublepage}

\setcounter{page}{1}
\section{Bevezető}

A képalkotó eljárások, mint például a mikroszkópia, az egyik legyakrabban használt eszközök az orvosi és biológiai kutatások során. Ennek az oka egyszerű: a puszta szem számára láthatatlan dolgok megjelenítése egy rendkívül hatásos módja annak, hogy betekintést kapjunk ezen rendszerek belső működésébe. Az agyunk úgy fejlődött ki, hogy rengeteg külső információt dolgozzon fel, és ezek közül vitathatatlanul a látás a legjelentősebb.

Az optika egyik ágaként a mikroszkópia (görög erdet, mikrosz, ,,apró" és szkopein ,,figyel" szavakból) a fény és vizsgált minta interakcióinak megfigyelésén alapul. Hogy láthassuk ezeket az interakciókat, a mikroszkóp optikája felnagyítja a minta képét, ami detektálható és rögzíthető egy erre alkalmas berendezéssel. A legelső mikroszkópoknál, a 17. században, ez egyszerűen a szem volt, a felvételt pedig a megfigyelt képekről készült rajzok alkották \cite{hooke_micrographia:_1665}.

A mikroszkópia egy igazán multidiszciplináris tudományág: még a legegyszerűbb formájában, egy egyszerű lencsét használva, a fizika alapelveit kihasználva nyerhetünk mélyebb megértést a bilógiáról és a természetről. Manapság a mikroszkópia felöleli a legtöbb természettudomány eredményeit, kiegészítve különféle technológiai fejlesztésekkel. Ugyan továbbra is a fizika és a biológia adják a kulcsszerepet, a kémia (fluoreszcens molekulák), mérnöki tudmányok (automatizálás) és információs technológia (képfeldolgozás) eredményei közösen alkotják a modern mikroszkópia alapjait.

\section{Kihívások az élő minták háromdimenziós képalkotásában}

\subsubsection{Kihívások a képalkotásban}

Az élő mintákról történő képalkotás elengedhetetlen az embrionális fejlődés folyamatainak megértéséhez. Ideális esetben a mikroszkóp képes lenne egy folyamatos, háromdimenziós, többszínű felvételt készíteni bármely biológiai folyamatról, a lehető legnagyobb felbontással. Sajnos azonban ez nem lehetséges; a biológia és fizika határai miatt kompromisszumra van szükség. A fény diffrakciós természete, a fluoreszcens jelölők véges élettartama és az élő minták fényérzékenysége miatt a mikroszkópiának alkalmazkodnia kell az aktuálisan megválaszolandó kérdéshez. Annak érdekében, hogy valóban hasznos felvételek készülhessenek, meg kell találni az egyensúlyt a jel-zaj viszony növelése és a térbeni és időbeni felbontás javítása közt, mindeközben szem előtt tartva, hogy maga a képalkotás ne legyen befolyással a vizsgálandó folyamatokra (\ref{fig:tradeoffs} ábra) \cite{laissue_assessing_2017}.

A light-sheet fluorescens mikroszkópia (LSFM), más néven egy-sík megvilágítású mikroszkópia (single plane illumination microscopy, SPIM) \cite{huisken_optical_2004} egy viszonylag új tagja azon technikák arzenáljának, melyek a fénymikroszkópián alapulnak. Nagy előnye, hogy különösen alkalmas élő minták hosszantartó vizsgálatára nagy térbeni és időbeni felbontással \cite{keller_quantitative_2008, huisken_selective_2009, weber_light_2011,tomer_shedding_2011}; továbbá könnyen adaptálható a vizsgálandó mintához, lehetővé téve számos különféle kísérletet, akár teljes szerveken \cite{dodt_ultramicroscopy:_2007}, akár egyes sejtek belső folyamatait vizsgálva \cite{chen_lattice_2014}.

Ugyan a light-sheet mikroskópia valódi optikai szeletelést tesz lehetővé, az axiális felbontása is rosszabb, mint a laterális, hasonlóan más mikroszkópiákhoz.
Izotróp 3D-s felbontás elérhető egyazon mintáról több irányból készült felvételek összeolvasztásával \cite{preibisch_efficient_2014}. Ezt leggyakrabban úgy lehet megvalósítani, hogy a mintát egy víz alapú zselébe ágyazzuk, mely szabad hozzáférést ad minden irányból, és megfelelően stabilan tartja a mintát, mely így pontosan pozícionálható. Bizonyos érzékeny mintáknál azonban ez a módszer nem használható, például egérembriók esetében, melyek számára egy specifikusan kialakított környezet szükséges a megfelelő fejlődéshez \cite{doherty_culture_2000}. Ilyen mintáknál a forgatás hiánya miatt más megoldásra van szükség a többnézetes képalkotás megvalósításához.

\begin{figure}[bht]
  \centering
  \begin{subfigure}[b]{0.49\textwidth}
    \raggedright
    
    \caption{}
    \label{fig:tradeoffs}
  \end{subfigure}
  \begin{subfigure}[b]{0.49\textwidth}
    \raggedleft
    
    \caption{}
    \label{fig:sizes}
  \end{subfigure}
  \bcaption[Kihívások a mikroszkópiában]{(a) Komromisszumok a fluoreszcens élő képalkotásban. A felvételi paraméterek optimalizálásánál kompromisszumra van szükség a magas felbontás, kontraszt és sebesség közt, elkerülve a minta károsítását \cite{laissue_assessing_2017}.
  % Adapted from \cite{laissue_assessing_2017}.
  (b) Kísérleti adatok méretei és az adatsebesség összehasonlítása egy-sík megvilágítású mikroszkópia (SPIM, piros), high-content screening (világoskék), lokalizációs mikroszkópia (SMLM, narancs) és konfokális mikroszkópia (kék) esetén.
  % Also called the ``pyramid of frustration". When optimizing the imaging conditions (red dot), a tradeoff has to be made between resolution, contrast, and imaging speed, while avoiding photodamage. One can only be improved at the expense of the others due to the limited photon budget of the fluorescent molecules.
  }
  \label{fig:intro}
\end{figure}

% A selective-plane illumination microscope (SPIM) uses a light-sheet to illuminate only a thin section of the sample. This illumination plane is perpendicular to the imaging axis of the detection objective and coincides with the focal plane. This way, only the section in focus will be illuminated, thus providing much better signal to noise ratio compare to wide-field illumination. In case of conventional wide-field fluorescence microscopy, where the whole specimen is illuminated, out of focus light contributes to a significant background noise. 
% With selective-plane illumination, this problem is intrinsically solved, and it also provides a true sectioning capability. This makes SPIM especially suitable for 3D imaging.

\subsubsection{Kihívások a képfeldolgozásban}

A képfeldolgozás minden mikroszkópiát alkalmazó kutatásban kritikus részét képzi a munkafolyamatnak. Ez különösképp igaz a light-sheet mikroszkópiára, ahol egy adott minta több napon keresztül történő vizsgálatára is lehetőség van, jelentős mennyiségű adatot generálva ezáltal.
Egy egyszeri \textit{Drosophila} fejlődést célzó felvétel (ami egy tipikus példája a light-sheet mikroszkópia vizsgálatoknak) több terabyte adatot eredményez.

A light-sheet mikroszkópián kívül egyéb mikroszkópos eljárások is hasonló problémával szemesülhetnek. Olyan eljárasok, mint a high content sreening \cite{carpenter_systematic_2004,echeverri_high-throughput_2006,pepperkok_high-throughput_2006}, ahol több ezer különböző genotípust vizsgálnak, vagy a loklizációs mikroszkópia (SMLM) \cite{betzig_imaging_2006,hess_ultra-high_2006,rust_sub-diffraction-limit_2006}, ahol a mintának egyetlen síkjáról készül több ezer felvétel a szuperrezolúció eléréséhez.

Ezek a módszerek nem csupán rendkívül gyorsan generálják az adatokat, hanem sokszor hosszú időn kereszül történik mindez, így egyes kísérletek a terabyte-os méretet is elérhetik (\ref{fig:sizes} ábra).
Ez a hatalmas mennyiségű adat könnyen akadályt allíthat az új felfedezéseknek, ami egyre gyakrabban jellemző a biológiai kutatásokban \cite{wollman_high_2007,reynaud_guide_2015,perkel_struggle_2016}.

% \section{Real-time image processing and compression}

% \begin{figure}[bt]
%   \centering
%   \includegraphics[width=0.6\textwidth]{spim_concept}
%   \bcaption[Basic concept of single-plane illumination microscopy]{The sample is illuminated from the side by laser light shaped to a light-sheet (blue). This illuminates the focal plane of the detection lens, that collects light in a wide-field mode (yellow). The image is recorded, and the sample is translated through the light-sheet to acquire an entire 3D stack.}
%   \label{fig:spim_concept}
% \end{figure}

\section{Új tudományos eredmények}

Jelen munka az előzőekben vázolt kihívásokra nyújt lehetséges megoldásokat: érzékny minták, például egérembriók nagyfelbontású vizsgálata élőben, és nagyméretű light-sheet adatok valós idejű feldolgozása.

  \paragraph{Tézis I.}\textit{Megterveztem es megépítettem egy light-sheet mikroszkópot, ami érzékeny minták nagy felbontású vizsgálatára alkalmas. A két darab, magas numerikus apertúrájú objektív 120 fokban történő elhelyezése, egy megdöntött light-sheettel kombinálva, izotróp 3D felbontású képalkotásra ad lehetőséget, miközben a fény begyűjtésének hatékonyságát kétszeresre növeli meg.}
  
    Kapcsolódó publikációk: \cite{de_medeiros_light-sheet_2016},\cite{strnad_inverted_2016}, \cite{hoyer_breaking_2016}

    A Dual Mouse-SPIM egy újszerű megközelítést képvisel a light-sheet mikroszkópiában. A 120 fokban elhelyezett magas numerikus apertúrájú objektívek nemcsak a felbontás javítását eredményezi a hagyományos 90 fokos elrendezéssel szemben, hanem a nagyobb detektálási szögnek köszönhetően a fény begyűjtése kétszer hatékonyabban történik. Ez legfőképpen fényérzékeny minták, mint például egérembriók esetén lehet előnyös, mivel a fototoxikus hatások lecsökkenthetők, míg a kontraszt megmarad. Mindét objektív használható megvilágításra és detektálásra is, ami lehetővé teszi a forgatás nélküli többnézetes felvételt.

    Megterveztem az optikai utat, az elrendezést és az egyedi mechanikai komponenseket, továbbá megépítetttem a mikroszkópot.
    A mikroszkóp részeként megterveztem egy egyedi nyalábosztó egységet, ami lehetővé teszi csupán egyetlen galvanometrikus szkenner használatát a light-sheet generáláshoz mindkét objektív esetén. Továbbá egy olyan testreszabott detektálás-összeolvasztó egységet is megterveztem, ami lehetővé teszi egyetlen kamera használatát mindkét nézetből.

    Karakterizáltam a mikroszkóp optikai tulajdonságait, meghatározva a megvilágítási profilt és a pontátviteli függvényt (PSF).
    A \SI{95}{\micro m}-es látómező egy \SI{3,6}{\micro m} vastagságú light-sheettel van egyenletesen megvilágítva. A mintaként használt gömböcskék két irányból történő képalkotása \SI{314}{nm} laterális és \SI{496}{nm} axiális felbontást eredményezett. Ez egy 2,67-szeres javulás egyetlen detektáló objektívlencse axiális felbontásához képest. Ezen kívül demonstráltam a  mikroszkóp képességét \textit{Drosophila melanogaster} embriókról és az egér zigótákról készült felvételekkel. 

    \begin{figure}
      \centering
      
      \bcaption[Dual Mouse-SPIM koncepció]{(a) Objektívek elrendezése. Mindkét objektívet felváltva lehet hasynálni megvilágításra és detektálásra is. (b) A két nézet együttes PSF függvénye oldalnézetből. 12 fluoreszcens gömböcske átlaga. Lépték: \SI{1}{\micro m}.}
      \label{fig:DualMouse}
    \end{figure}

  \paragraph{Tézis II.} \textit{Kidolgoztam egy GPU-alapú képfeldolgozási pipeline-t többnézetes light-sheet mikroszkópiára, amely lehetővé teszi a szemközti nézetek valós időbeni összeolvasztását.}

    Kapcsolódó publikációk: \cite{balazs_gpu-based_2016}, \cite{balazs_gpu-based_2016-1}, \cite{balazs_gpu-based_2017}

    Kidolgoztam egy GPU-alapú képfeldolgozási pipeline-t, mely közvetlenül integrálható a LabVIEW alapú univerzális mikroszkóp vezérlő rendszerünkbe. A pipeline jelenleg lehetővé teszi a háttér levonását és a háttér maszkolását, továbbá képes az azonos sík szemközti nézeteinek azonnali összeolvasztására. Megmutattam, hogy lehetséges a szemközti nézetek regisztrálásának 3D problémáját 2D problémára redukálni, anélkül, hogy ez negatív hatással lenne a képminőségre és a felbontásra. Ez jelentősen lecsökkenti a szükséges számítási kapacitást és lehetővé teszi a CUDA textúrák alkalmazását és a valós időbeni összeolvasztást. Ennek a megoldásnak a feldolgozási sebessége 138 fps, ami 18,3-szoros növekedés az egyszálú CPU verzióhoz képest.

    \begin{figure}
      \centering
      
      \bcaption[Valós idejű képfeldolgozó pipeline többnézetes light-sheet mikroszkópiához]{}
      \label{fig:pipeline}
    \end{figure}
    
  \paragraph{Téziscsoport III.} \textit{Valós idejű képtömörítés.}
  \subparagraph{Tézis III/1.} \textit{Kifejlesztettem egy képtömörítési algoritmust, ami lehetővé teszi a fénymikroszkópokkal nyert képek zaj-függő veszteséges tömörítését és akár százszoros tömörítési arányt is elérhet, megőrizve a későbbi adatfeldolgozó lépések eredményeit. A gyors CUDA implementáció lehetővé teszi a nagysebességű kamerák képeinek valós idejű tömörítését.}

    Kapcsolódó publikációk: \cite{balazs_real-time_2017}, \cite{balazs_gpu-based_2016}, \cite{balazs_gpu-based_2016-1}, \cite{balazs_gpu-based_2017}
    
    % \b3d is an efficient, GPU-based image compression library allowing losslaess and noise dependent lossy compression of microscopy images.
    Mivel a számos különféle nagyebességű mikroszkópia technikák hatalmas mennyiségű adatot generálnak, kísérletenként akár terabájtokat elérve, a képtömörítés kiemelt szerepet kap ilyen adathalmazok esetén. A jelenleg használt, mikroszkópos képekkel kompatibilis képtömörítési eljárások nem képesek a modern sCMOS kamerák nagy adatsebességével megküzdeni ($\sim \SI{800}{MB/s}$).

    Kifejlesztettem a \b3d nevű GPU-alapú párhuzamos képtömörítő algoritmust, amely képes \SI{1}{GB/s} feletti átviteli sebességre, lehetővé téve a valós idejű képtömörítést. A méret további csökkentése érdekében kidolgoztam egy zajfüggő veszteséges tömörítési eljárást, amely determinusztikus módon módosítja az adatokat. A pixelenkénti megengedett eltérés a kép zajszintjéhez képest választható, figyelembe véve a sörétzaj (shot noise) és a kamera kiolvasási zaj mértékét. A pixel prediktálásnak köszönhetően a szubjektív képminőség magasabb, mint más eljárások esetén, ahol egyszerűen a képek négyzetgyökének kvantálása történik.

  \subparagraph{Tézis III/2.} \textit{Megmutattam, hogy a zajszinten belüli tömörítés nem befolyásolja szignifikánsan a leggyakrabban használt képfeldolgozási feladatok eredményeit és a tömörítési arány 3,32-szeres átlagos javulását eredményezi a veszteségmentes tömörítéshez képest.}
  
    Kapcsolódó publikációk: \cite{balazs_real-time_2017}, \cite{balazs_gpu-based_2016}, \cite{balazs_gpu-based_2016-1}, \cite{balazs_gpu-based_2017}
    
    Mivel az adatok integritása elengedhetetlen a megfelelő következtetések levonása érdekében, ezért a veszteséges tömörítés használata ellentmodnásos lehet.
    Megmutattam, hogy a \b3d zajszinten belüli módja (within noise level, WNL) nem befolyásolja szignifikánsan a leggyakrabban használt képfeldolgozási feladatok eredményét.
    
    Light-sheet mikroszkópos adatokra megmutattam, hogy a WNL tömörítés kisebb eltérést okoz a képben, mint a sörétzaj (shot noise). A felvételek szegmentálása esetén a szegmentált régiók átfedése \textit{Drosophila} embrió sejtmagokra 99,6\%, míg \textit{Phallusia} embriók membránjára 94,5\%. A tömörítési arány a két felvételre 19,3-szoros, illetve 40,01-szeres volt.
    
    \begin{figure}
      \centering
      
      \bcaption[Zajszint függő veszteséges tömörítés hatása 3D sejtmag szegmentálásra]{
      Egy H2Av-mCherry sejtmagi markert kifejező \textit{Drosophila melanogaster} embrió MuVi-SPIM \cite{krzic_multiview_2012} felvételén 3D-ben szegmentáltuk a sejtmagokat. Az eltérések megjelnítéséhez egymásra vetítettük az eredeti (zöld) és tömörített (magenta) képekről készült szegmentálás eredményét (\textbf{b}, \textbf{c}; átfedés fehérrel jelölve). A szegmentálások átfedése és a tömörítési ráta a tömörítési szint függvényében a (\textbf{d}) alábrán látható.}
      \label{fig:wnlDroso}
    \end{figure}

    Lokalizációs mikroszkóp adatokra megmuttam, hogy a WNL tömörítés mindössze 4\%-kal növeli a lokolizációs hibát, míg az átlagos tömörítési ráta 1,44-ről (veszteségmentes) 4,96-ra emelkedik. Megmutattam továbbá, hogy a lokalizációs hiba változása nem függ a felvételek jel-zaj viszonyától.

\section{Lehetséges alkalmazások}
Mind a Dual Mouse-SPIM mikroszkópnak, mind a GPU-alapú képfeldolgozásnak közvetlen alkalmazási lehetőségei vannak az embrionális fejlődés vizsgálatában. Több potenciális együttműködő fejezte ki érdeklődését a Dual Mouse-SPIM használata iránt az egér embrionális fejlődésének vizsgálatában. A pre- es posztimplantációs fázis szimmetriatörő eseményeire összpontosíó kutatásokban ez az elrendezés lehetőséget ad nagyobb minták több irányból történő képalkotására, ami a jelenleg használt mikroszkópokkal nem valósítható meg, így lehetőseget adva eddig ismeretlen mechanizmusok feltárasára. Egy másik lehetséges alkalmazás a kromoszóma szegregáció mechanizmusainak vizsgálata az embrionális fejlődés első néhány osztódási fázisában. A nagyobb axiális felbontás lehetőséget ad minden egyes kromoszóma követésére az osztódási folyamat során, ami eddig nem volt lehetséges az axiális felbontás hiányosságai miatt.

A GPU-alapú képfeldolgozási pipeline-t, főképp a szemközti nézetek 2D fúzióját már most is használjuk laborunk nagyteljesítményű mikroszkopján, a MuVi-SPIM- en. A két szemközti objektív nézeteinek összeolvasztása a képalkotás közben nemcsak jelentős tárhely megtakarítást eredményez, de az adatelemzést is szignifikánsan felgyorsítja.

A \b3d képtömörítési algoritmus először light-sheet mikroszkópia kihívásaira fókuszálva lett megtervezve, de sokkal széleskörűbb felhasználási lehetőséget nyújt. Bármilyen nagy teljesítményű, high-throughput fénymikroszkópián alapuló vizsgálat profitálhat a zajszinten belüli tömörítési eljárásnak köszönhető jelentős adatcsökkenés adta előnyökből. Mivel a tömörítés a képalkotás alatt azonnal kivetelezhető, nemcsak a tárolási feltételek, de a szükséges sávszélesség is lecsökken, ami szükségtelenné teszi a nagyteljesítményű RAID tömbök használatát és 10 Gbit-es hálózat kiépítését tovább csökkentve a költségeket. A hasonlóan gyors kitömörítési sebességnek köszönhetően az
adatbeolvasás is gyorsabb lesz, amiből a böngészési és 3D adatmegjelenítési alkalmazások profitálhatnak. Néhany cég már érdeklődését fejezte ki a tömörítés iránt, többek között a Bitplane AG (3D adatelemzés és megjelenítés), a Luxendo GmbH (light-sheet mikroszkópia) és a Hamamatsu Photonics K.K. (kamera es szenzor gyártás).

% \cleardoublepage
% \section*{References}

\newrefcontext{journal}
\printbibliography[category=journal, title={A szerző közleményei a témában}, heading=secbib]
\markboth{\MakeUppercase{References}}{}

%\newrefcontext{others}
\nocite{jakus_genetic_2010,gyorffy_recurrenceonline:_2011,shi_combined_2014}
\printbibliography[category=others, title={A szerző további közleményei}, heading=secbib, resetnumbers=5]
\markboth{\MakeUppercase{References}}{}

\newrefcontext{conference}
\printbibliography[category=conference, title={A szerző konferencia előadásai}, heading=secbib]
\markboth{\MakeUppercase{References}}{}

\newrefcontext
\printbibliography[notcategory=journal,notcategory=conference,notcategory=others, resetnumbers=true, title={Referenciák}, heading=secbib]
\markboth{\MakeUppercase{References}}{}

%\end{linenumbers}
\end{document}
