balintbalazs/thesis/dissertation_BB.tex

% !TEX program = xelatex
\documentclass{diploma_style}

\input{0_defBib}
\input{0_acronyms}

\def\b3d{B\textsuperscript{3}D}
\newcommand{\etal}{\textit{et al.}\xspace}

\DeclareMathOperator{\na}{NA}
\DeclareMathOperator{\NA}{NA}
\DeclareMathOperator{\pred}{Pred}
\DeclareMathOperator{\Pred}{Pred}

\author{\href{mailto:balint.balazs@embl.de}{Bálint Balázs}}
\supervisor{\href{mailto:rozsabal@koki.hu}{Balázs Rózsa, \textit{M.D., Ph.D.}}}
\lab{\href{http://www.embl.de/}{European Molecular Biology Laboratory}}
\university{\href{http://www.ppke.hu/}{Pázmány Péter Catholic University}}
\collegeordept{\href{http://www.itk.ppke.hu/}{Faculty of Information Technology and Bionics \\ Roska Tamás Doctoral School of Sciences and Technology}}
\degreedate{A thesis submitted for the degree of \\ \textit{Doctor of Philosophy} \\ 2018}
\ppkelogo{}
\degree{PhD}

\makeglossaries

\title{A new angle on light-sheet microscopy and real-time image processing}
%\date{2012 november}

\hyphenation{CameraLink}

\begin{document}

\pagestyle{plain}

\maketitle
\pagenumbering{roman}

\input{0_abstract}

\addtocontents{toc}{\protect{\pdfbookmark[0]{\contentsname}{toc}}}
\tableofcontents
\pagestyle{fancy}
\markboth{\MakeUppercase{Contents}}{}

\listoffigures
\addcontentsline{toc}{chapter}{List of Figures}

\listoftables
\addcontentsline{toc}{chapter}{List of Tables}

\glsaddall[types={\acronymtype}]
\printglossary[type=\acronymtype, title=List of Abbreviations, toctitle=List of Abbreviations]

\cleardoublepage
\setcounter{page}{1}
\pagenumbering{arabic}

\chapter*{Introduction}
\markboth{\MakeUppercase{Introduction}}{}
\addcontentsline{toc}{chapter}{Introduction}
\input{0_intro}
\cleardoublepage

\input{1_spim}

\input{2_DualMouse}

\input{3_processing}

\input{4_gpu}

\chapter{Conclusions}

Each chapter was concluded with their own discussion (see \autoref{sec:discu-microscope} and \autoref{sec:discu-gpu}). Here, the new scientific results are summarized, and an outlook is provided for the possible future applications.

\graphicspath{{./}}
\label{ch:discussion}
\input{5_newResults}

% \begin{appendices}

\chapter*{Appendix}
\markboth{\MakeUppercase{Appendix}}{}
\addcontentsline{toc}{chapter}{Appendix}
\setcounter{table}{0}
\setcounter{figure}{0}
\setcounter{section}{0}
\renewcommand{\thesection}{\Alph{section}}
\renewcommand{\thetable}{\Alph{section}\arabic{table}}
\renewcommand{\thefigure}{\Alph{section}\arabic{figure}}

\input{appendix_a}
\clearpage
\setcounter{table}{0}
\setcounter{figure}{0}
\input{appendix_b}
\clearpage
\setcounter{table}{0}
\setcounter{figure}{0}
\input{appendix_c}
\clearpage
\setcounter{table}{0}
\setcounter{figure}{0}
\input{appendix_3d}

% \end{appendices}

\cleardoublepage
\chapter*{References}
\addcontentsline{toc}{chapter}{References}
\input{6_references}

\input{7_ack}

\end{document}
