balintbalazs/thesis/0_acronyms.tex

\setacronymstyle{long-short}

\newacronym{spim}{SPIM}{single-plane illumination microscopy}
\newacronym{lsfm}{LSFM}{light-sheet fluorescence microscopy}
\newacronym{smlm}{SMLM}{single molecule localization microscopy}
\newacronym{gfp}{GFP}{green fluorescent protein}
\newacronym{pdf}{PSF}{point spread function}
\newacronym{otf}{OTF}{optical transfer function}
\newacronym{opfos}{OPFOS}{orthogonal plane fluorescent optical sectioning}
\newacronym{muvi}{MuVi-SPIM}{Multiview SPIM}
\newacronym{dslm}{DSLM}{digitally scanned light-sheet microscopy}
\newacronym{dct}{DCT}{discrete cosine transform}
\newacronym{dft}{DFT}{discrete fourier transform}
\newacronym{dwt}{DWT}{discrete wavelet transform}
\newacronym{fov}{FOV}{field of view}
\newacronym{fn}{FN}{field number}
\newacronym{roi}{ROI}{region of interest}
\newacronym{2d}{2D}{two-dimensional}
\newacronym{3d}{3D}{three-dimensional}
\newacronym{na}{NA}{numerical aperture}
\newacronym{miam}{MIAM}{multi-imaging axis microscopy}
\newacronym{clsm}{CLSM}{confocal laser scanning microscopy}
\newacronym{tlsm}{TLSM}{thin light-sheet microscopy}
% \newacronym{EMBL}{EMBL}{European Molecular Biology Laboratory}
\newacronym{sted}{STED}{stimulated emission depletion}
\newacronym{resolft}{RESOLFT}{reversible saturable optical fluorescence transitions}
\newacronym{ccd}{CCD}{charge coupled device}
\newacronym{emccd}{EM-CCD}{electron multiplying CCD}
\newacronym{scmos}{sCMOS}{scientific CMOS}
\newacronym{smos}{CMOS}{complementary metal oxide semiconductor}
\newacronym{te}{TE}{trophoectoderm}
\newacronym{icm}{ICM}{inner cell mass}
\newacronym{fep}{FEP}{fluorinated ethylene propylene}
\newacronym{peek}{PEEK}{polyether ether ketone}
\newacronym{jpeg}{JPEG}{joint photographic experts group}
\newacronym{hevc}{HEVC}{high efficiency video codec}
\newacronym{dpcm}{DPCM}{differential pulse code modulation}
\newacronym{fwhm}{FWHM}{full width at half maximum}
\newacronym{bfp}{BFP}{back focal plane}
\newacronym{fpga}{FPGA}{field programmable gate array}
\newacronym{fps}{fps}{frames per second}
\newacronym{yfp}{YFP}{yellow fluorescent protein}
\newacronym{gpu}{GPU}{graphics processing unit}
\newacronym{cpu}{CPU}{central processing unit}
\newacronym{ecsd}{eCSD}{electronic confocal slit detection}
\newacronym{wnl}{WNL}{within-noise-level}
\newacronym{dstorm}{dSTORM}{direct stochastic optical reconstruction microscopy}
\newacronym{snr}{SNR}{signal-to-noise ratio}
