balintbalazs/thesis/3_processing.tex

% !TEX root = dissertation_BB.tex
%% spellcheck-language en-US

  %#######  ########   #######   ######  
  %#     ## ##     ## ##     ## ##    ## 
  %#     ## ##     ## ##     ## ##       
  %#######  ########  ##     ## ##       
  %#        ##   ##   ##     ## ##       
  %#        ##    ##  ##     ## ##    ## 
  %#        ##     ##  #######   ######  

  \graphicspath{{./figures/3_processing/}}

  % \section{Image processing for light-sheet microscopy}
  
  %   necessary preprocessing steps for multi-view light-sheet microscopy
  %   image fusion
  %     1. bead based registration
  %     2. weighted average / cake fusion
  %     3. multi-view deconvolution
  
  \chapter{Image compression}
  \label{ch:compr}
    % As we will see later (\autoref{sec:sizes}), 
    Light-sheet microscopy is capable of generating an immense amount of data in a short amount of time. For this reason not only fast data processing, but data compression also plays an important role when evaluating, sharing and storing the images. In this chapter we will briefly introduce the core concepts of image compression and show some examples as a background for \autoref{ch:GPU}. For a more comprehensive review on data compression fundamentals, the interested reader is referred to the works of Sayood \cite{sayood_introduction_2012}, and Salomon and Motta \cite{salomon_handbook_2010}.
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
