balintbalazs/thesis/figures/1_spim/sample_holder.png

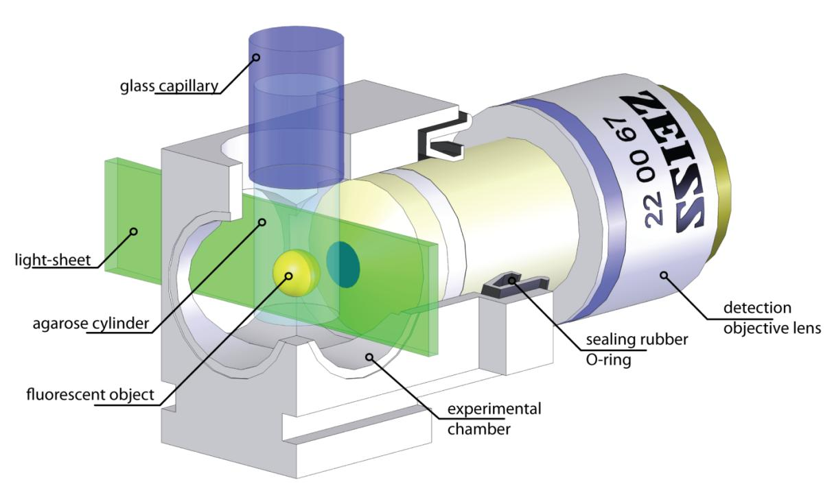
figures/1_spim/sample_holder.png
