balintbalazs/thesis/figures/2_DualMouse/beads/axial_fit_fusedPSF.png

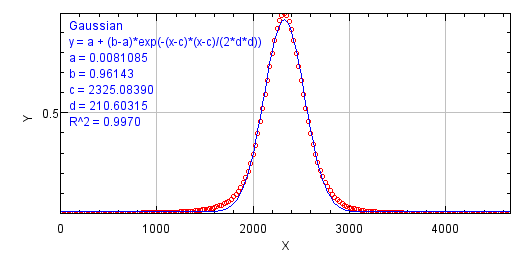
figures/2_DualMouse/beads/axial_fit_fusedPSF.png
