balintbalazs/thesis/figures/2_DualMouse/beads/lateral_fit_fusedPSF.png

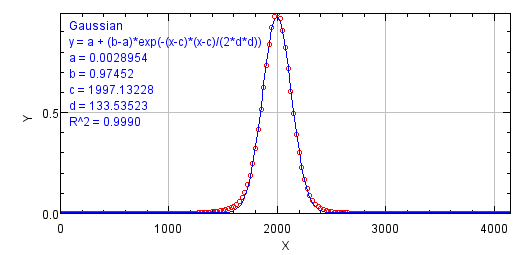
figures/2_DualMouse/beads/lateral_fit_fusedPSF.png
