balintbalazs/thesis/figures/2_DualMouse/beads/PSF_left+right.tif

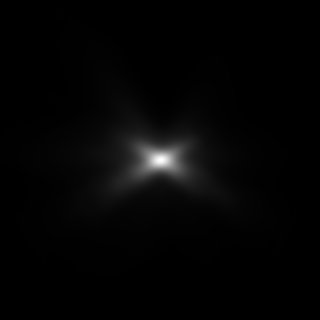
figures/2_DualMouse/beads/PSF_left+right.tif
