balintbalazs/thesis/figures/2_DualMouse/beads/PSF_left_RL10_norm.tif

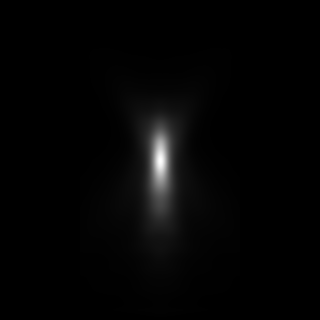
figures/2_DualMouse/beads/PSF_left_RL10_norm.tif
