balintbalazs/thesis/figures/2_DualMouse/beads/PSF_left_RL10_norm_rot+60.tif

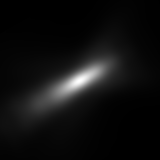
figures/2_DualMouse/beads/PSF_left_RL10_norm_rot+60.tif
