balintbalazs/thesis/figures/2_DualMouse/beads/PSF_leftxright.tif

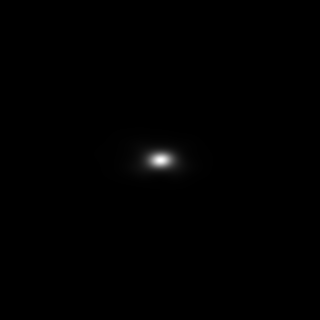
figures/2_DualMouse/beads/PSF_leftxright.tif
