balintbalazs/thesis/figures/2_DualMouse/beads/PSF_leftxright_norm.png

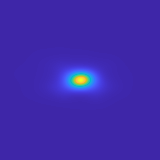
figures/2_DualMouse/beads/PSF_leftxright_norm.png
