balintbalazs/thesis/figures/2_DualMouse/beads/PSF_right_RL10_norm.tif

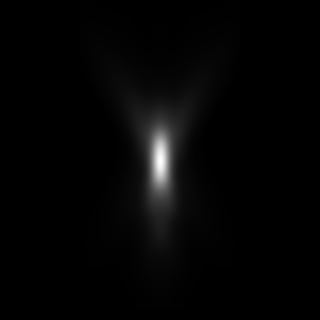
figures/2_DualMouse/beads/PSF_right_RL10_norm.tif
