balintbalazs/thesis/figures/2_DualMouse/beads/PSF_right_RL10_norm_rot-60.tif

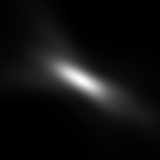
figures/2_DualMouse/beads/PSF_right_RL10_norm_rot-60.tif
