balintbalazs/thesis/figures/2_DualMouse/droso/15_centrioles_avg.png

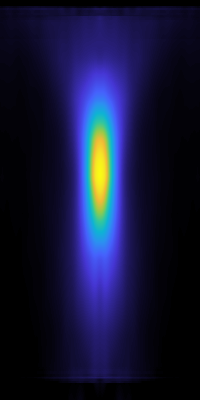
figures/2_DualMouse/droso/15_centrioles_avg.png
