balintbalazs/thesis/figures/2_DualMouse/droso/axial_fit.png

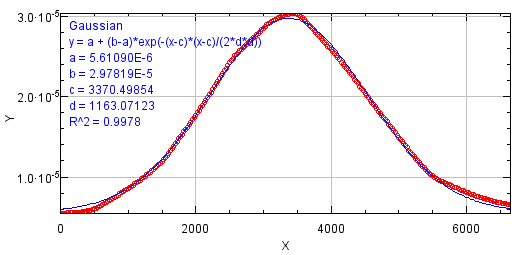
figures/2_DualMouse/droso/axial_fit.png
