balintbalazs/thesis/figures/2_DualMouse/droso/lateral_fit.png

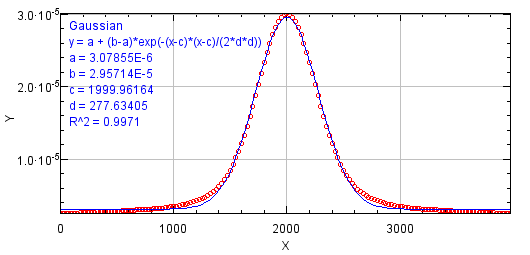
figures/2_DualMouse/droso/lateral_fit.png
