balintbalazs/thesis/figures/2_DualMouse/droso/psf_simu_561.png

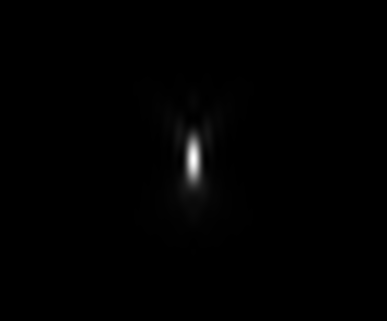
figures/2_DualMouse/droso/psf_simu_561.png
