balintbalazs/thesis/figures/2_DualMouse/photos/front_solidworks_overlay_render2.png

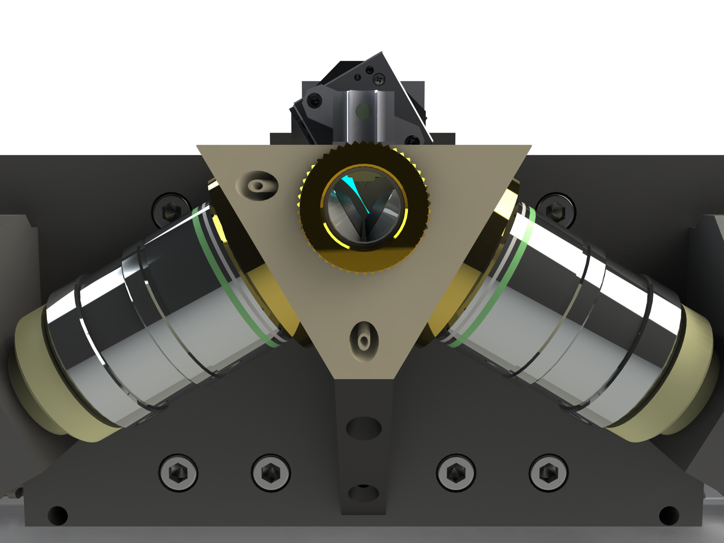
figures/2_DualMouse/photos/front_solidworks_overlay_render2.png
