balintbalazs/thesis/figures/2_DualMouse/photos/photo+solidworks_overlay.jpg

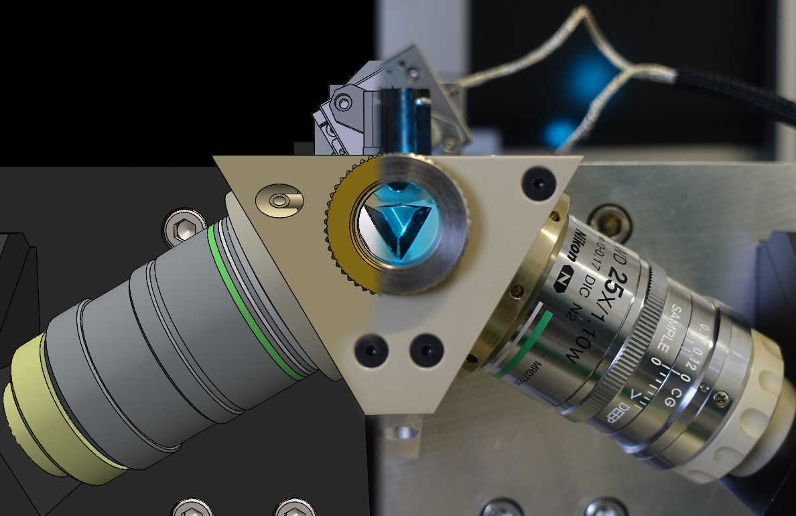
figures/2_DualMouse/photos/photo+solidworks_overlay.jpg
