balintbalazs/thesis/figures/2_DualMouse/photos/top.jpg

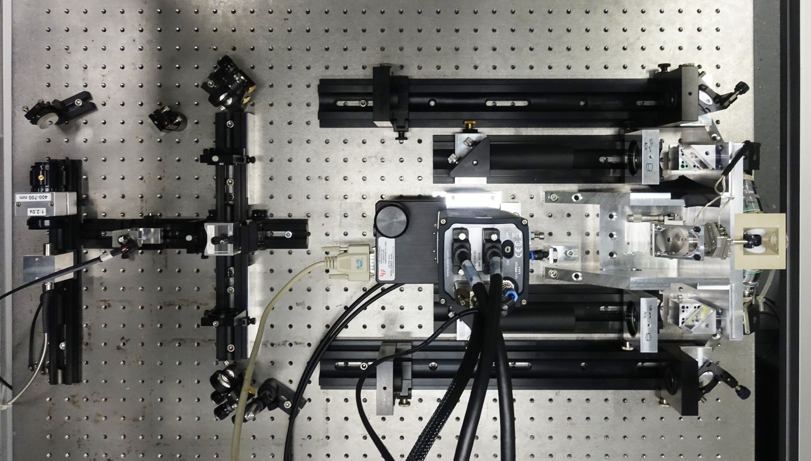
figures/2_DualMouse/photos/top.jpg
