balintbalazs/thesis/figures/2_DualMouse/SW/3d/DualMouseSPIM_beamScanning_forAppendix.png

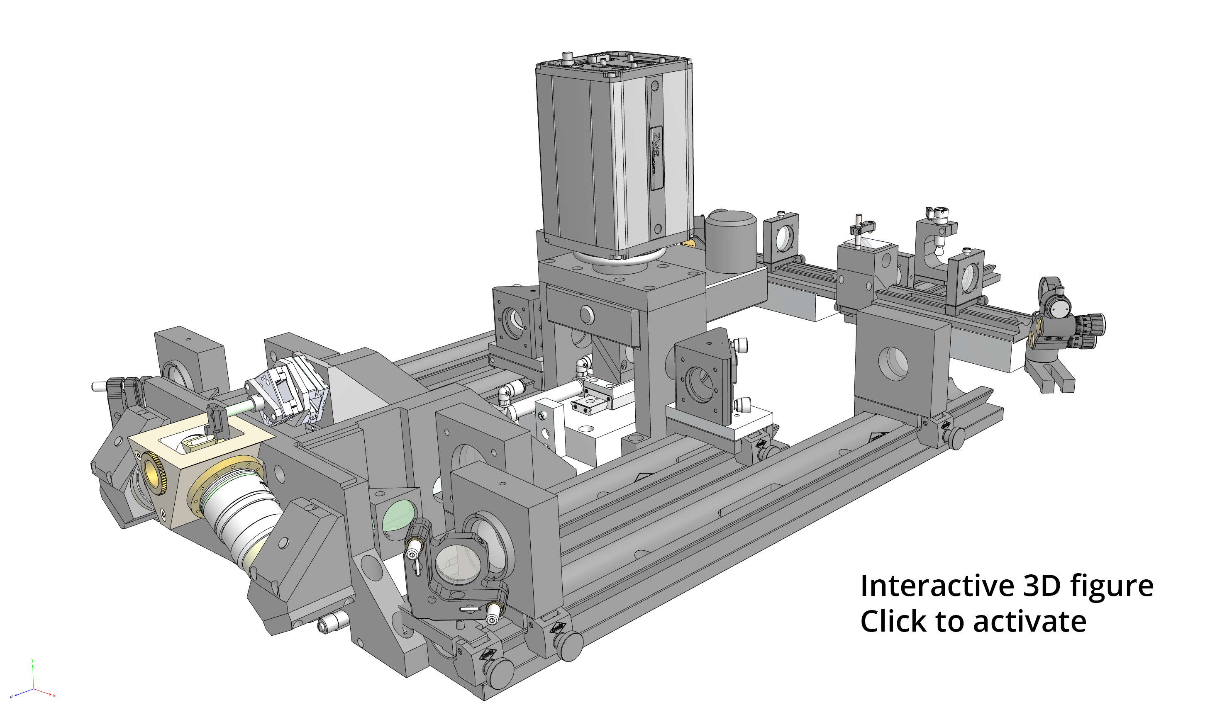
figures/2_DualMouse/SW/3d/DualMouseSPIM_beamScanning_forAppendix.png
