balintbalazs/thesis/figures/4_gpu/extraNoise.png

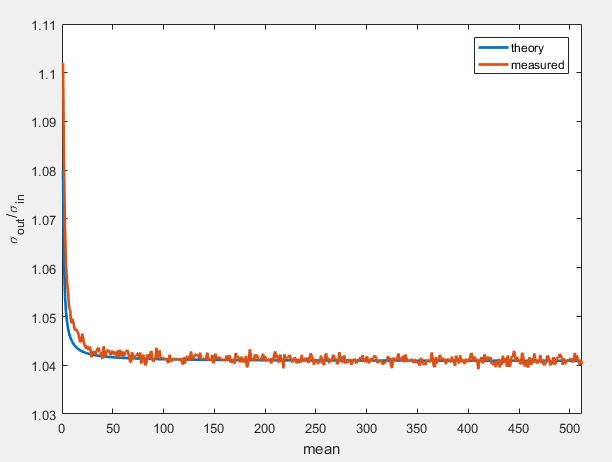
figures/4_gpu/extraNoise.png
