balintbalazs/thesis/figures/4_gpu/fusion/beads/2D_MarvinFused_area_noBG--1+ROI.png

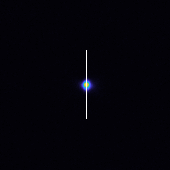
figures/4_gpu/fusion/beads/2D_MarvinFused_area_noBG--1+ROI.png
