balintbalazs/thesis/figures/4_gpu/fusion/beads/2DMarvin_axial_fit.png

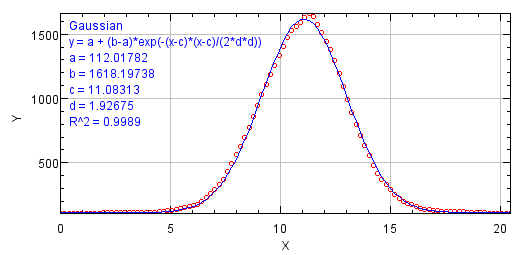
figures/4_gpu/fusion/beads/2DMarvin_axial_fit.png
