balintbalazs/thesis/figures/4_gpu/fusion/beads/2DMarvin_lateral_fit.png

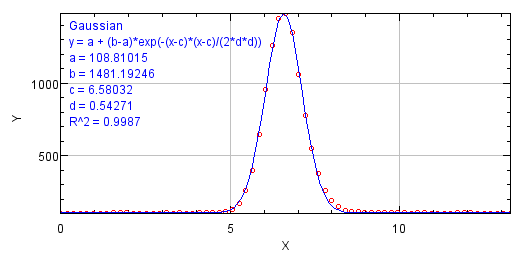
figures/4_gpu/fusion/beads/2DMarvin_lateral_fit.png
