balintbalazs/thesis/figures/2_DualMouse/efficiency/sphere.SLDASM

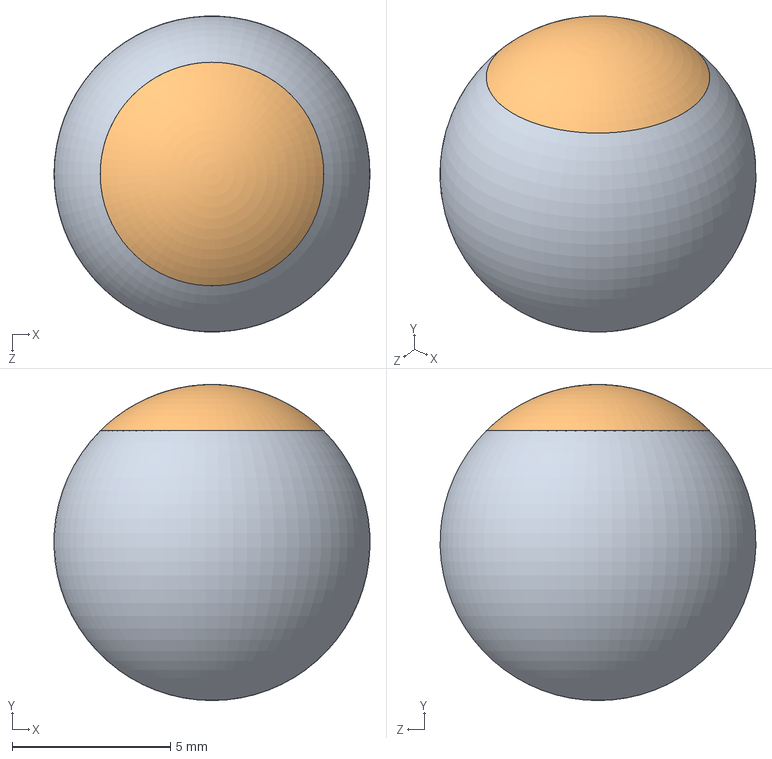
[picture p108: CAD file, 2017-08-09]
figures/2_DualMouse/efficiency/sphere.SLDASM
10.00 x 10.0 x 9.99 mm
sphere_bottom
sphere_top
