balintbalazs/thesis/figures/2_DualMouse/efficiency/sphere_top.SLDPRT

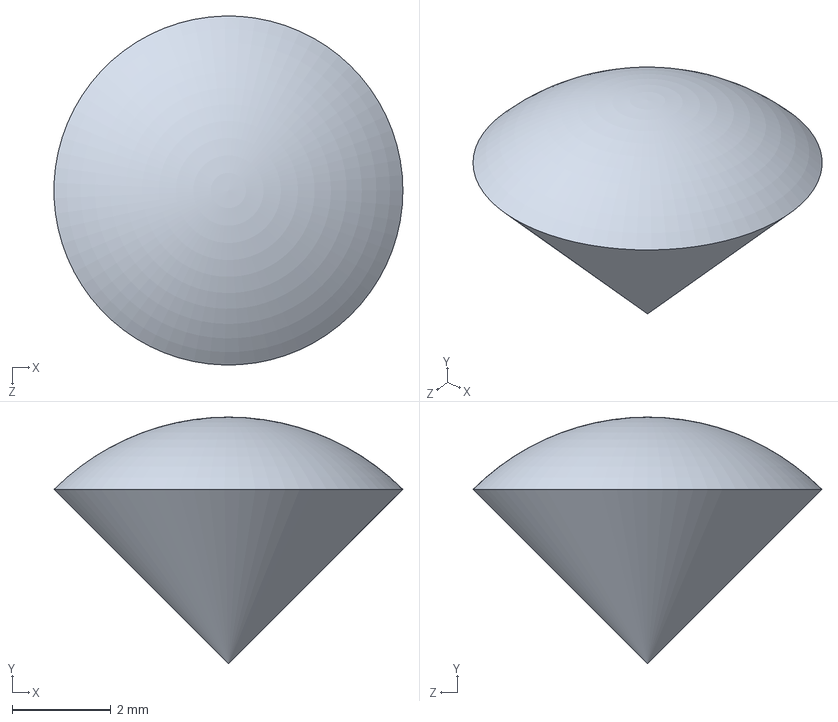
[picture p109: CAD file, 2017-08-09]
figures/2_DualMouse/efficiency/sphere_top.SLDPRT
7.07 x 5.00 x 7.07 mm
