balintbalazs/thesis/figures/2_DualMouse/efficiency/sphere_bottom.SLDPRT

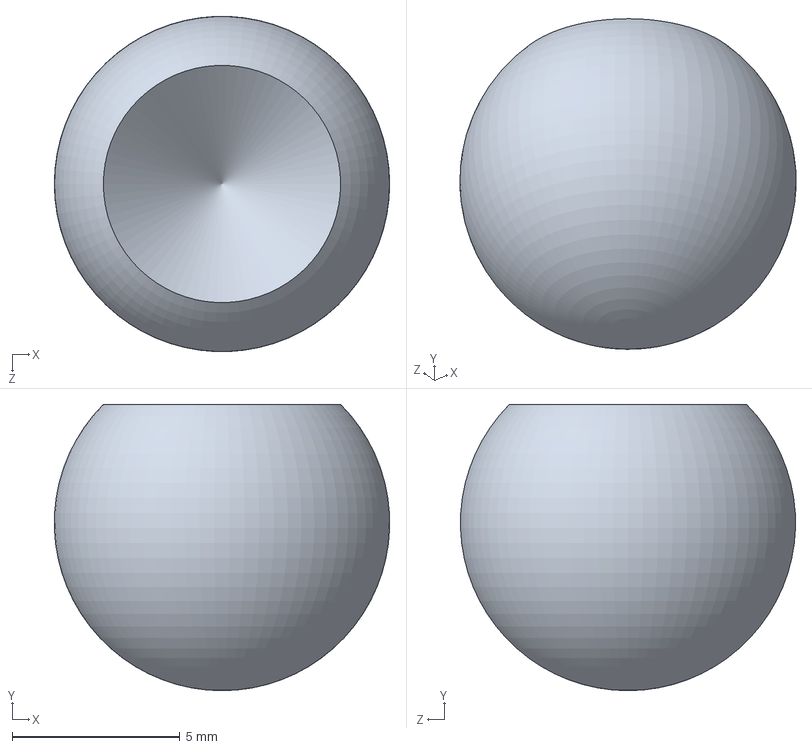
[picture p110: CAD file, 2017-08-09]
figures/2_DualMouse/efficiency/sphere_bottom.SLDPRT
10.00 x 8.54 x 9.99 mm
