balintbalazs/thesis/(list of files, cad)

Other CAD files:
figures/2_DualMouse/efficiency/sphere.SLDDRW
