balintbalazs/thesis/figures/2_DualMouse/zygoteMontage.pdf

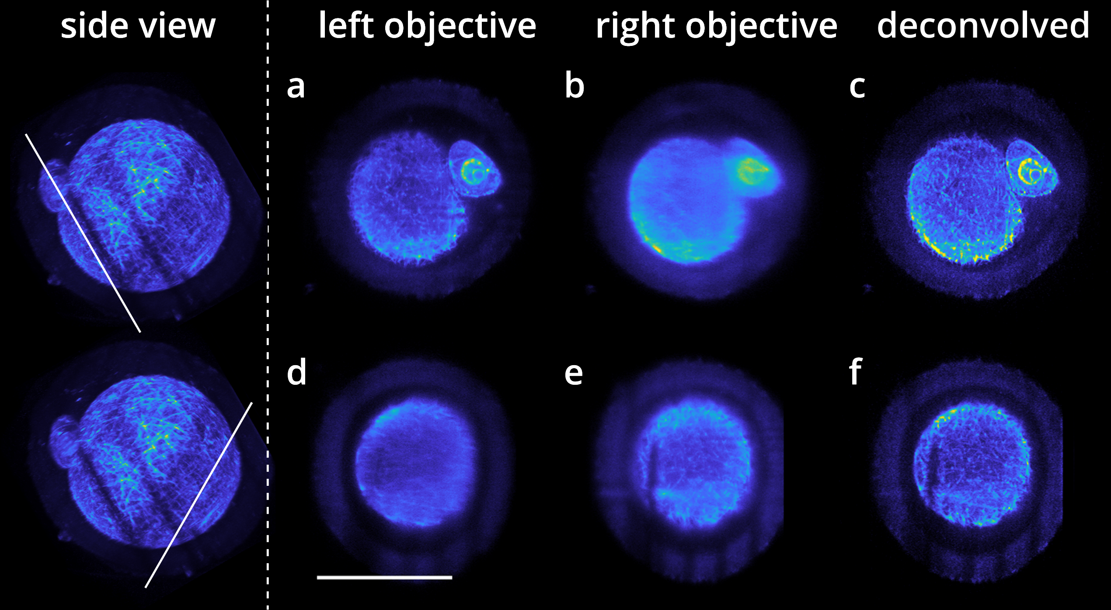
[picture p111: page 1]

a

left objective right objective deconvolved b

d | e | f c

side view
