balintbalazs/thesis/figures/2_DualMouse/fullSchematics.pdf

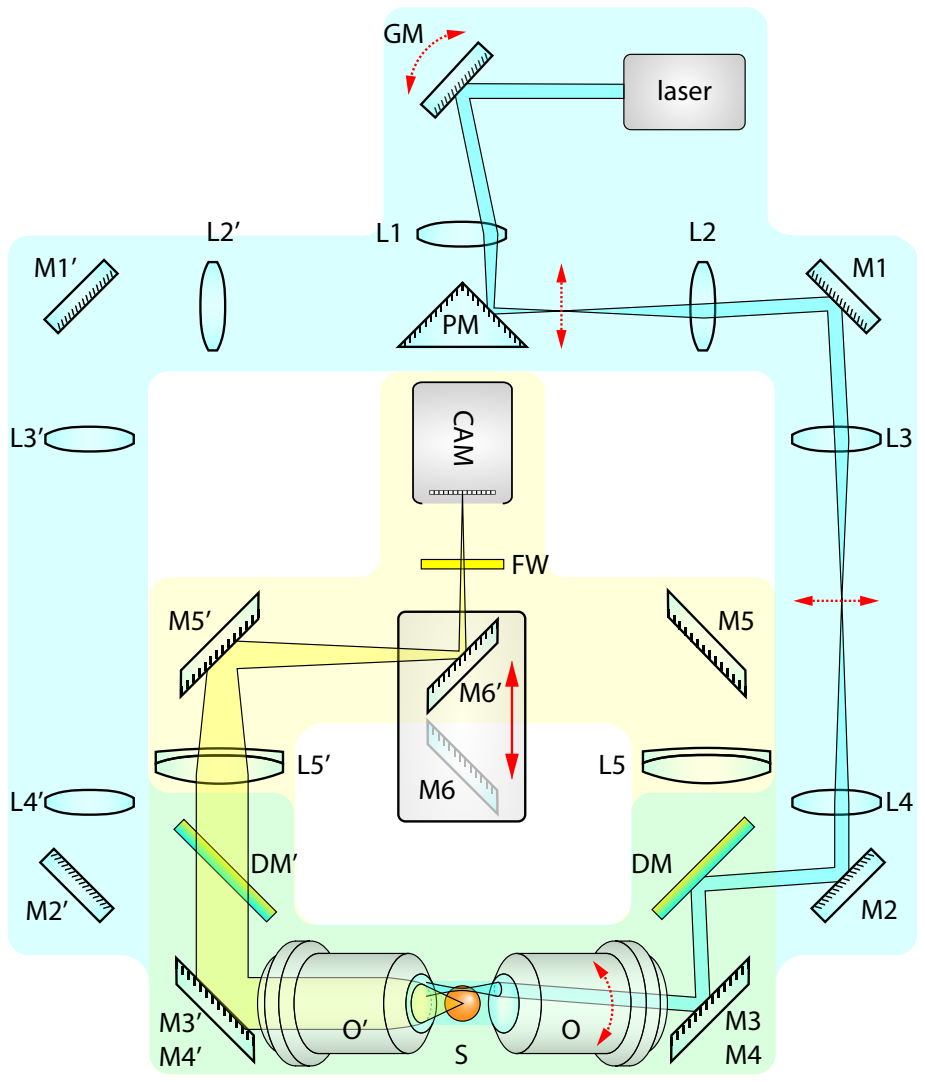
[picture p112: page 1]
CAM; laser

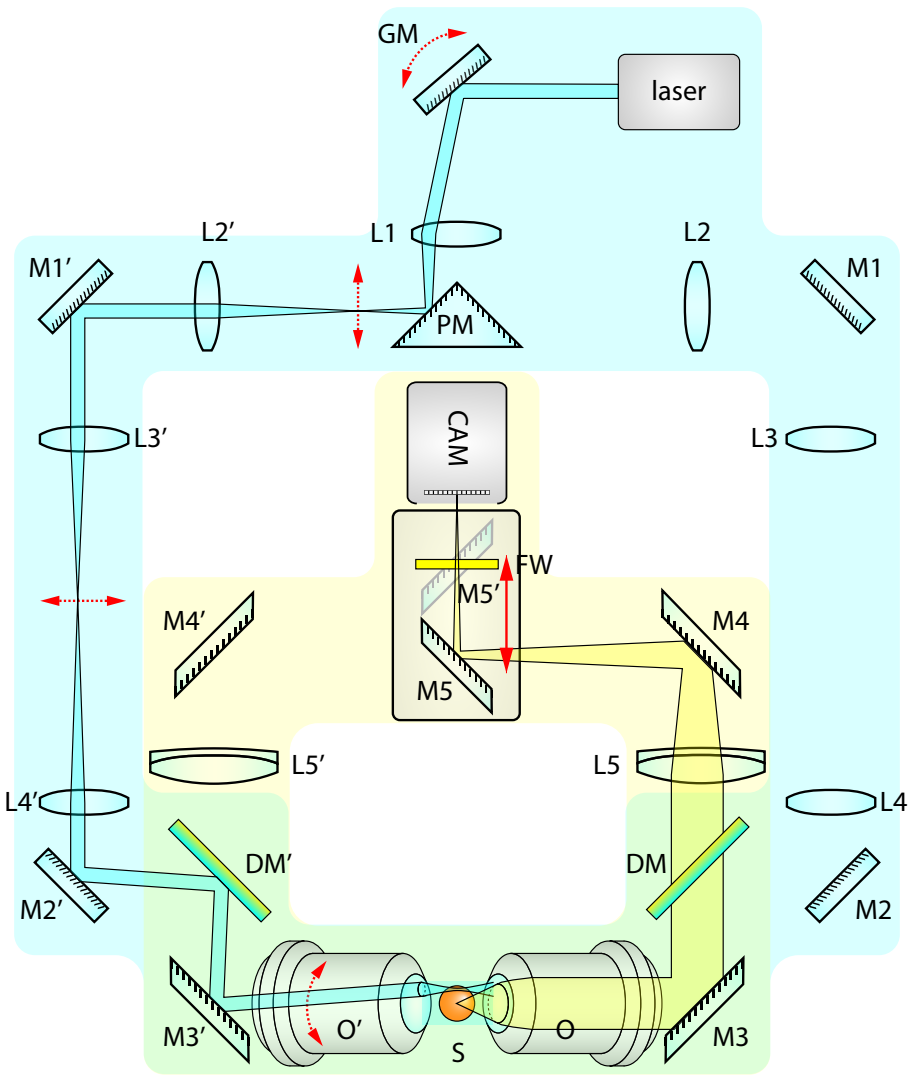
[picture p113: page 2]
CAM; laser
