balintbalazs/thesis/figures/2_DualMouse/HW.pdf

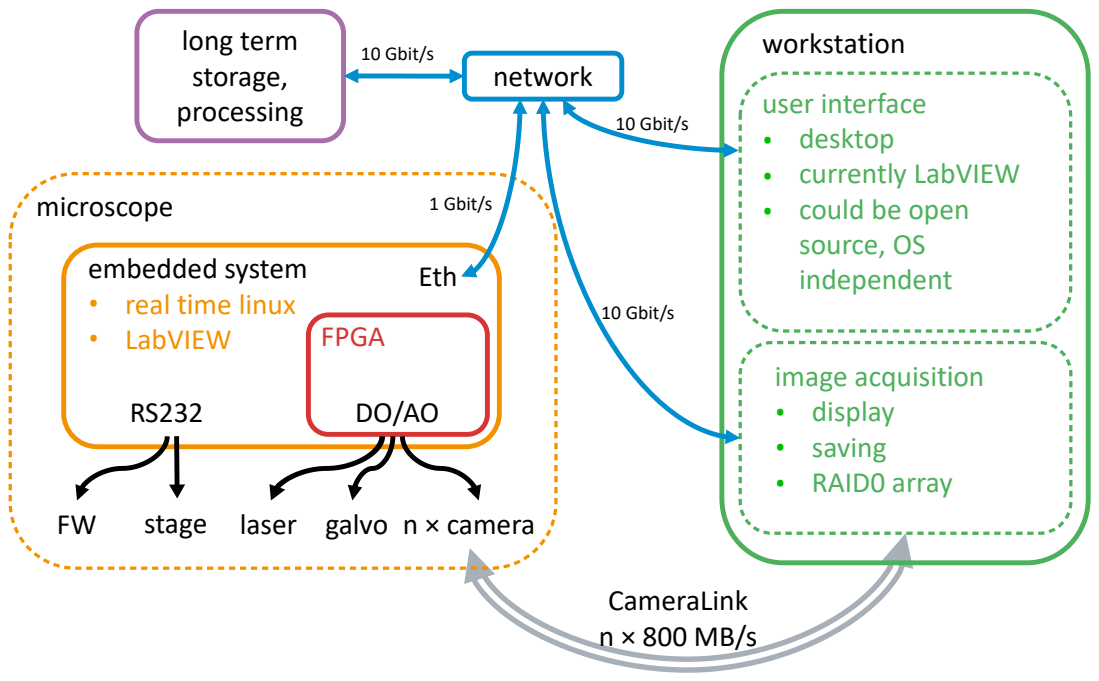
[picture p114: page 1]
image acquisition • display • saving • RAID0 array; FPGA; Eth; CameraLink n × 800 MB/s; long term storage, processing; 10 Gbit/s; stage laser galvo n × camera; network; 1 Gbit/s

workstation
user interface
• desktop
• currently LabVIEW
• could be open
source, OS
independent

microscope
embedded system
• real time linux
• LabVIEW
