balintbalazs/thesis/figures/2_DualMouse/PSF.pdf

simulated | left objective | right objective

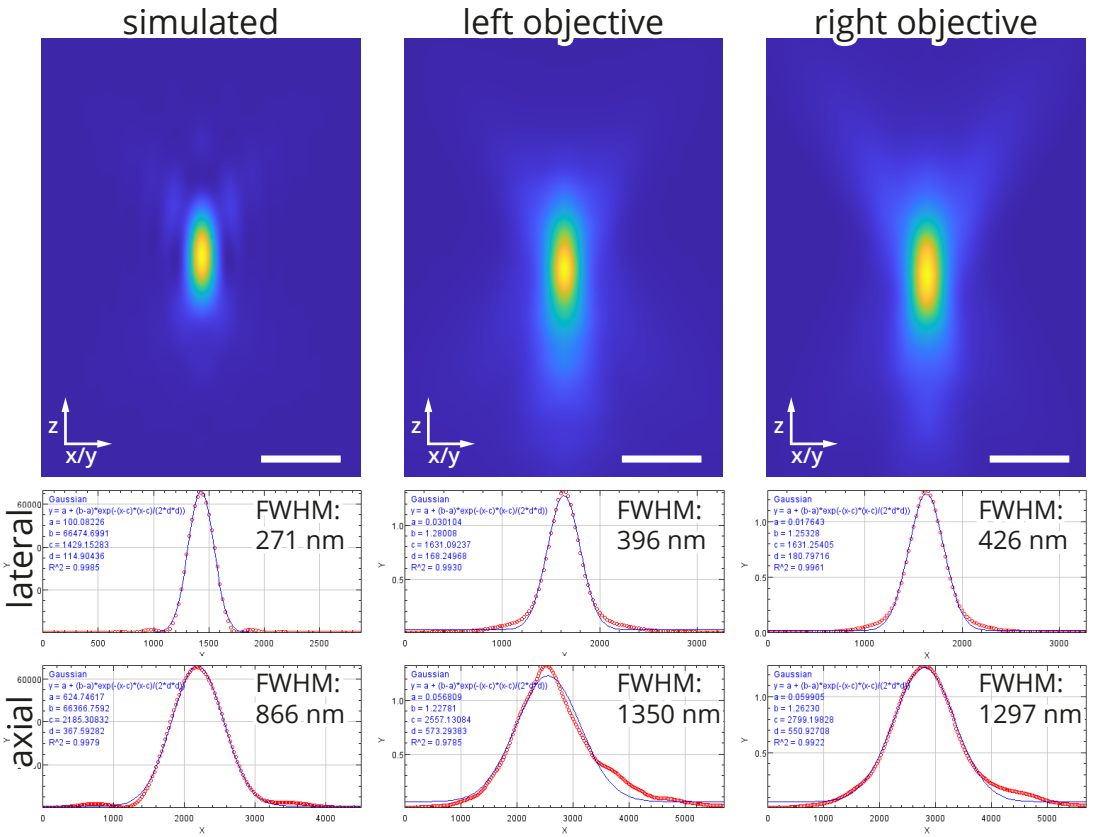
[picture p115: page 1]
lateral; axial; FWHM: 271 nm; FWHM: 866 nm; FWHM: 1350 nm; FWHM: 426 nm; FWHM: 396 nm; FWHM: 1297 nm
