balintbalazs/thesis/figures/2_DualMouse/fpgaTraces_scanner.pdf

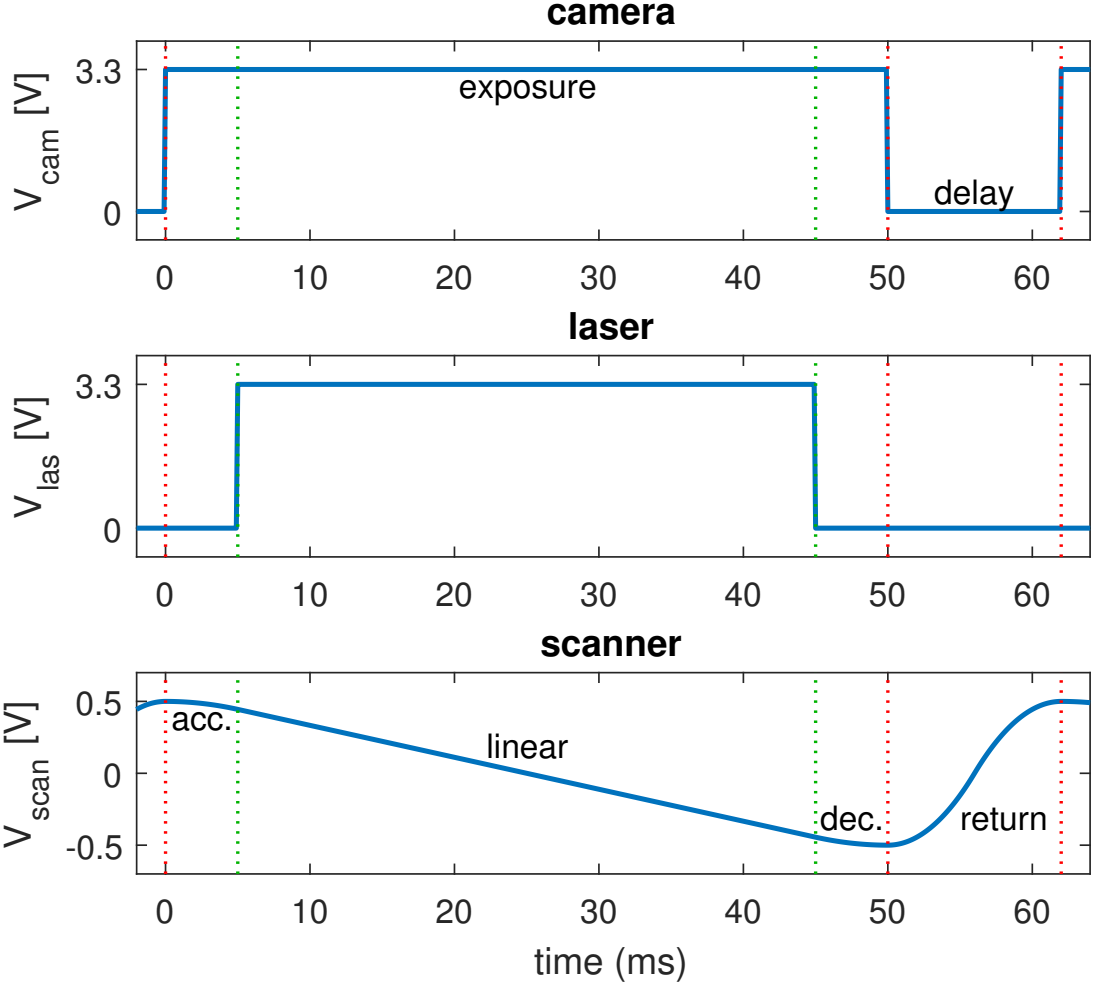
[picture p116: page 1]
cam [V]; camera; Vlas [V]; laser; time (ms); scan [V]; scanner; acc.; dec.; linear; return

exposure

delay
