balintbalazs/thesis/figures/2_DualMouse/fpgaTraces_galvo.pdf

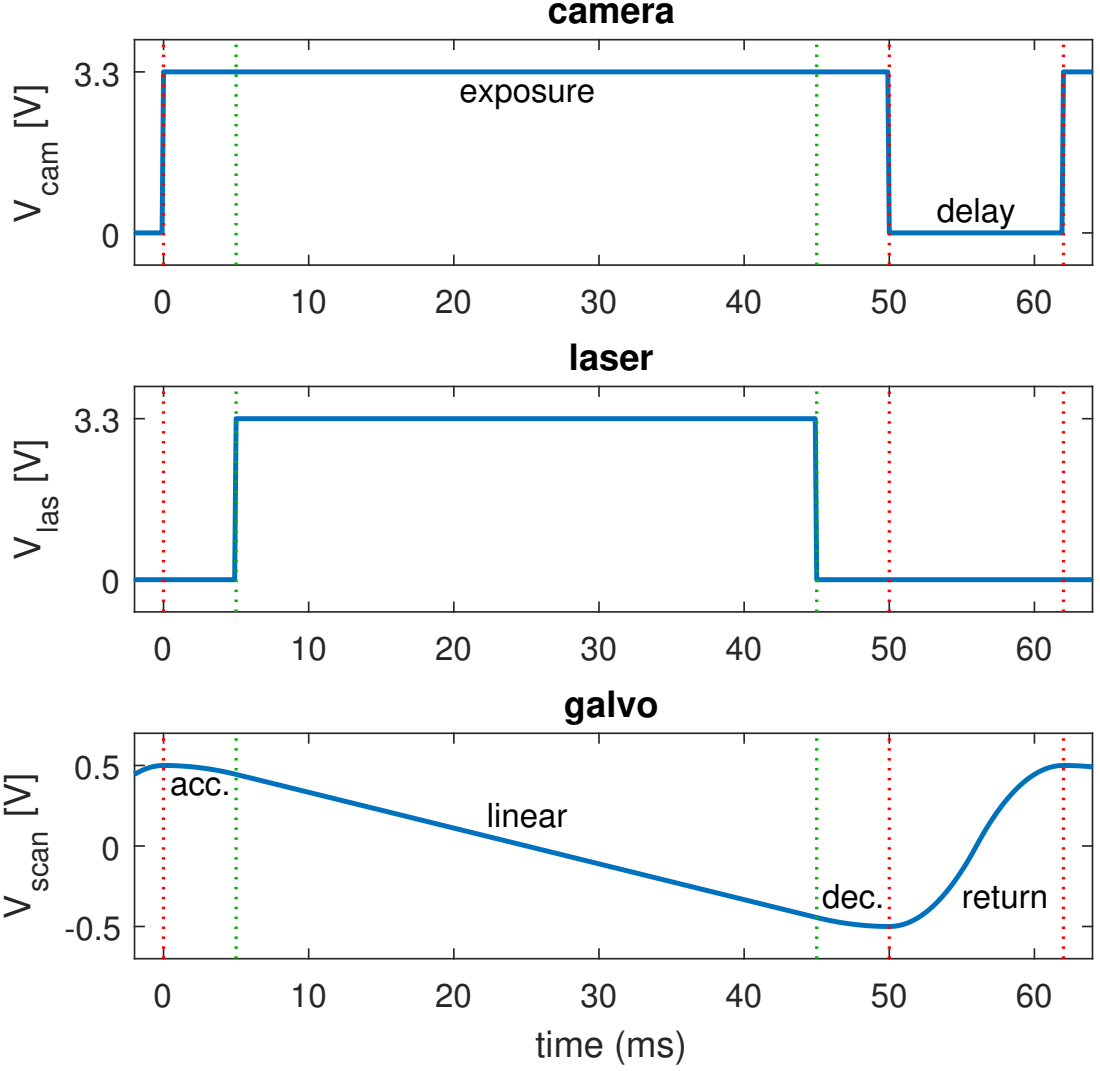
[picture p117: page 1]
cam [V]; camera; Vlas [V]; laser; time (ms); scan [V]; galvo; acc.; dec.; linear; return

exposure

delay
