balintbalazs/thesis/figures/1_spim/spim_cyl.pdf

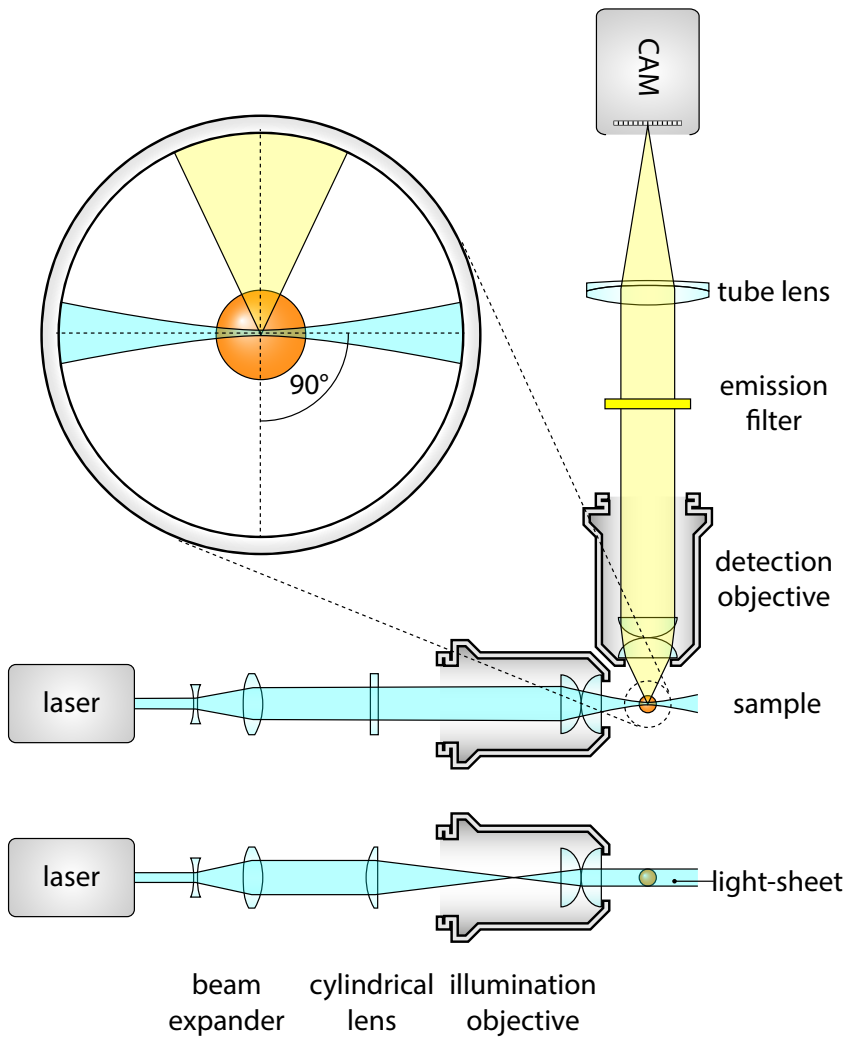
[picture p118: page 1]
CAM; laser; tube lens; emission lter; detection objective; sample; light-sheet; illumination objective; cylindrical lens; beam expander

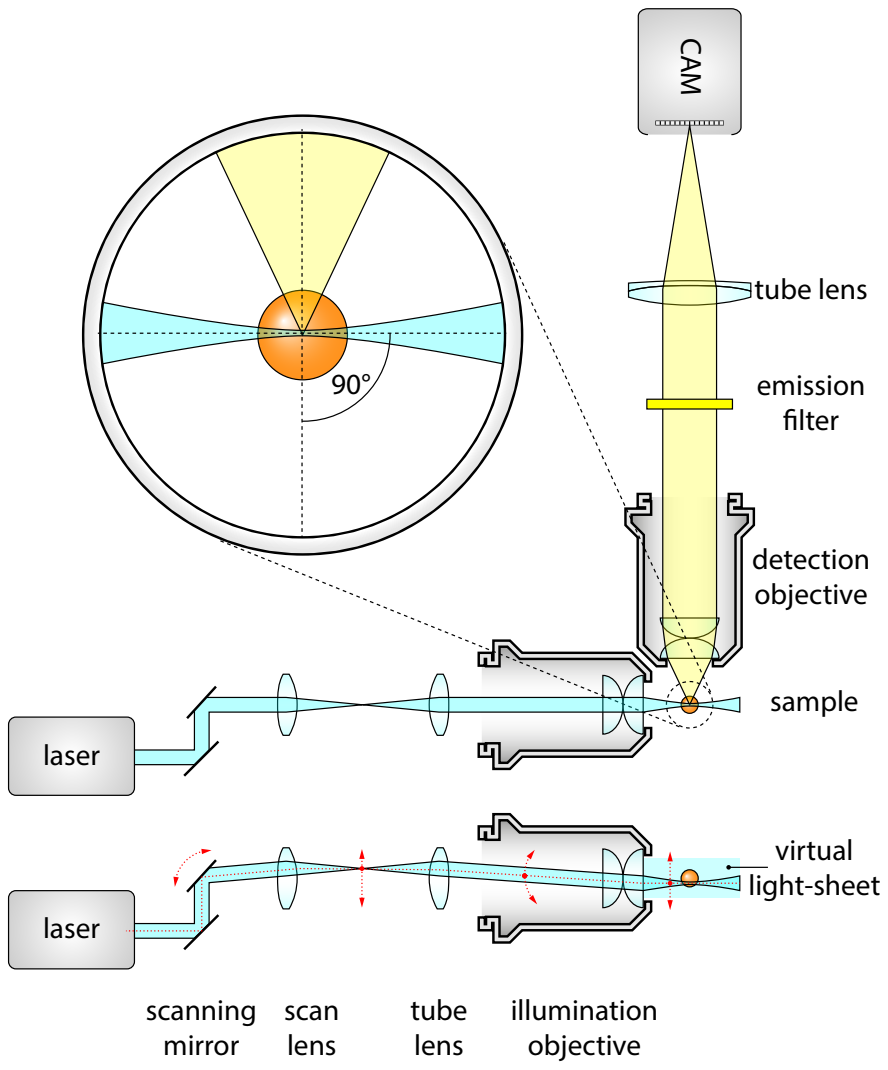
[picture p119: page 2]
CAM; laser; tube lens; emission lter; detection objective; sample; virtual light-sheet; illumination; scan lens; scanning mirror

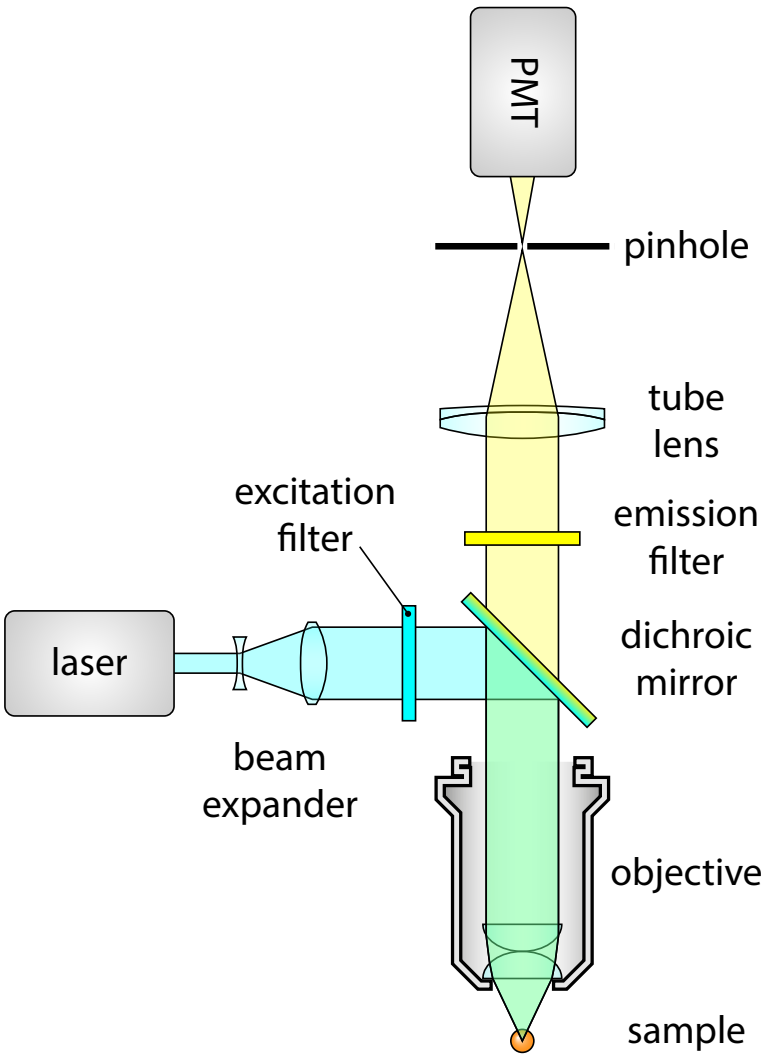
[picture p120: page 3]
laser; PMT; pinhole; tube lens emission lter; excitation lter; dichroic mirror; beam expander; objective; sample

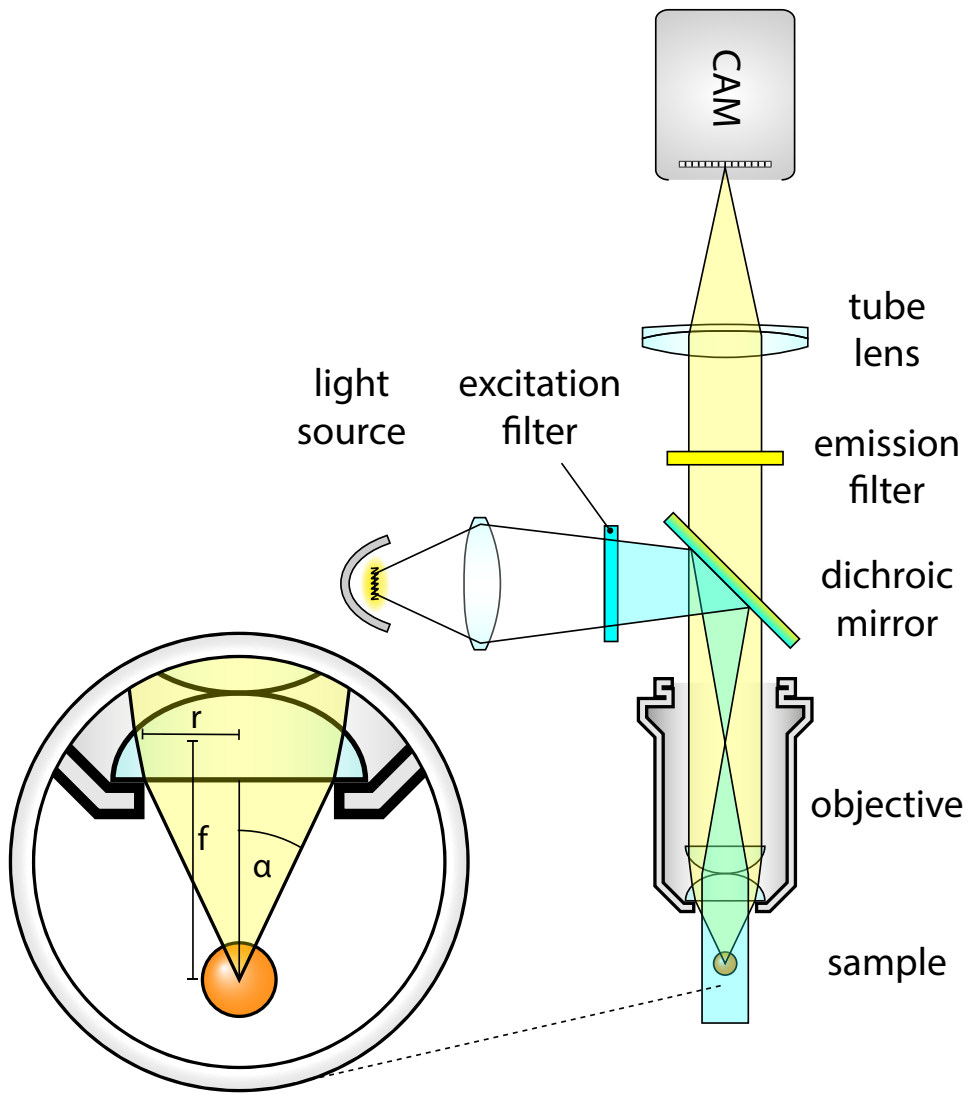
[picture p121: page 4]
CAM; tube lens; emission lter; light source; excitation lter; dichroic mirror; objective; sample

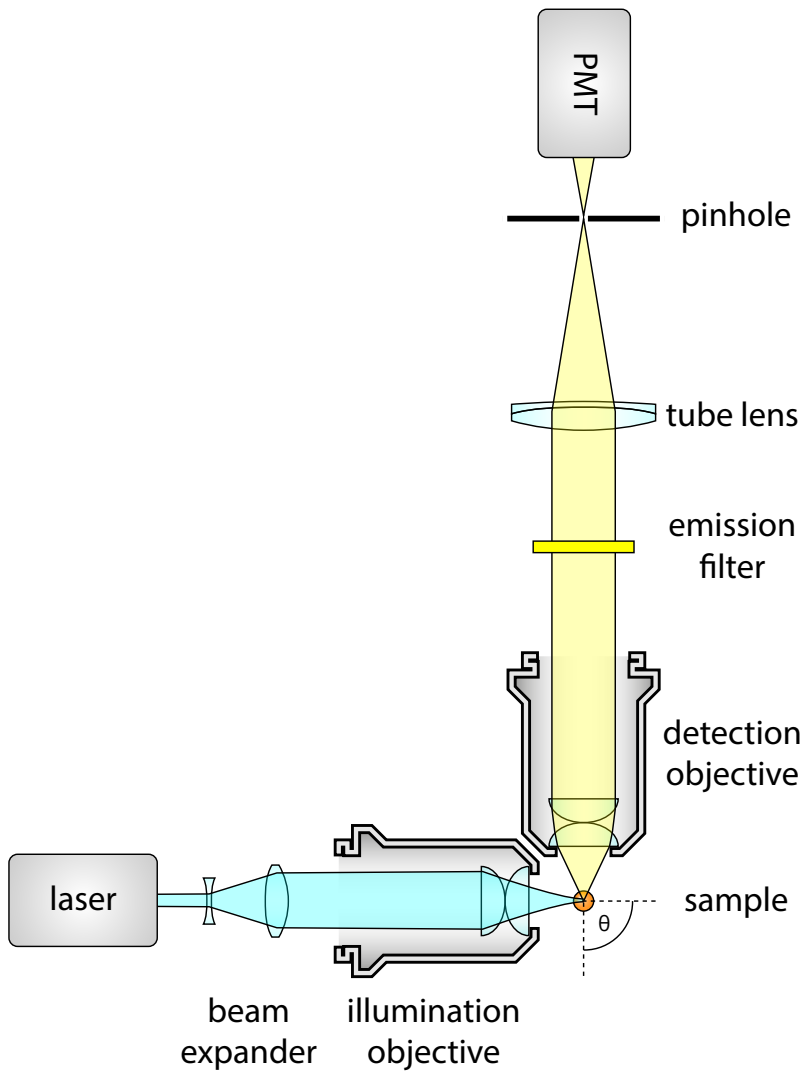
[picture p122: page 5]
laser; tube lens; emission lter; detection objective; sample; PMT; pinhole; illumination; beam expander
