balintbalazs/thesis/figures/1_spim/conf-theta.pdf

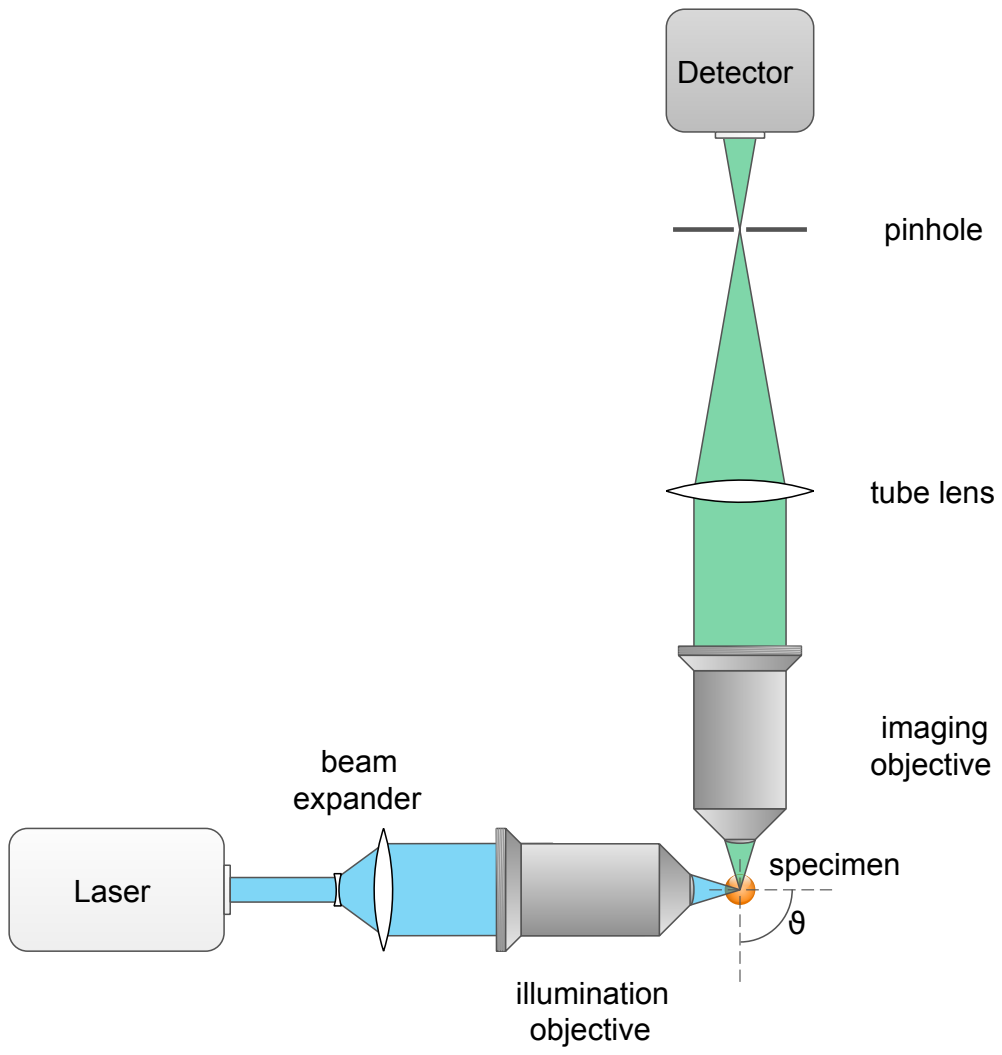
[picture p123: page 1]
Laser; pinhole; Detector; tube lens; illumination objective; beam expander; specimen; imaging objective
