balintbalazs/thesis/figures/2_DualMouse/beads/fusedPSF.pdf

a

c

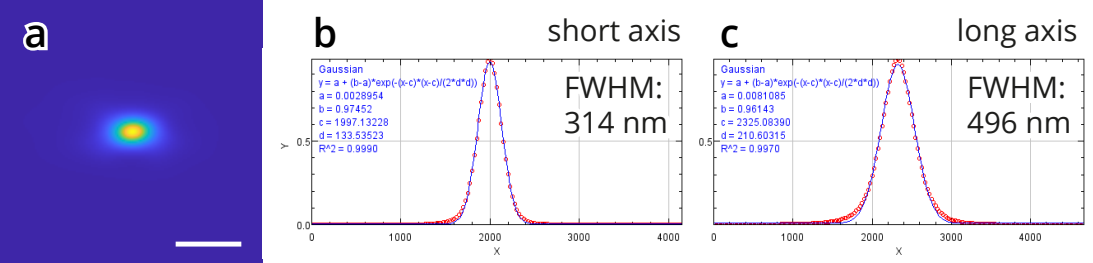
[picture p124: page 1]
FWHM: 496 nm; long axis; FWHM: 314 nm; short axis
