balintbalazs/thesis/figures/4_gpu/fusion/drosophilaContrast.pdf

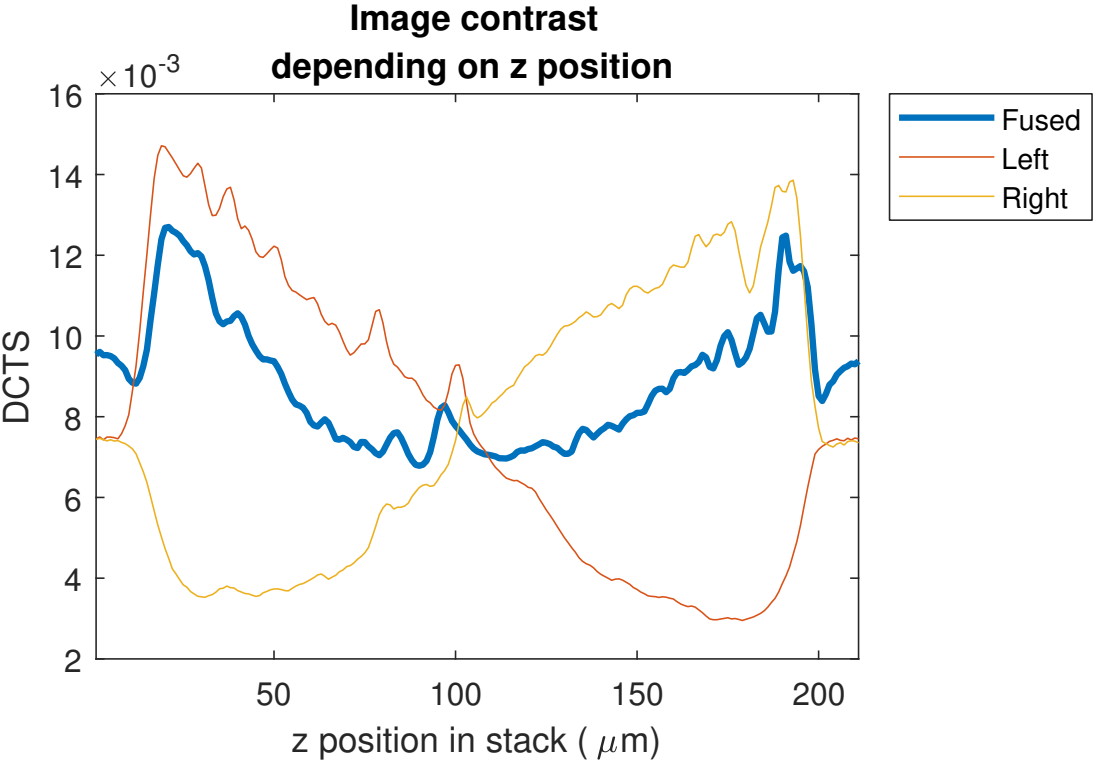
[picture p125: page 1]
DCTS; Fused Left Right

Image contrast
depending on z position

z position in stack ( m)
