balintbalazs/thesis/figures/1_spim/spim_concept.pdf

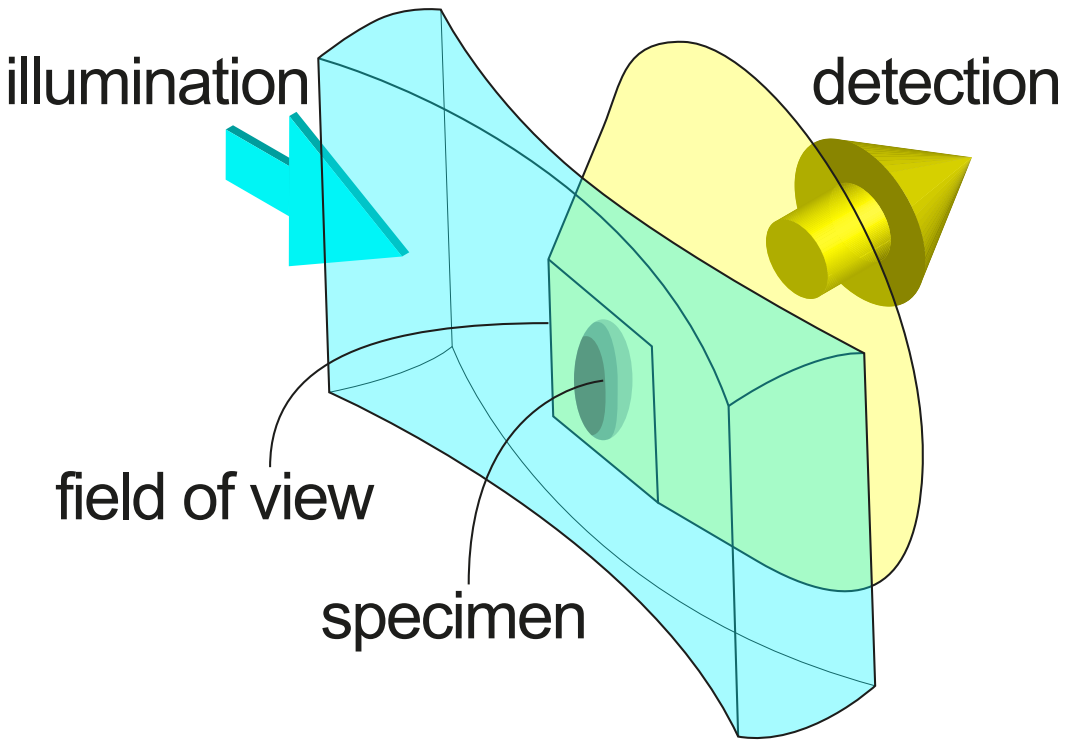
[picture p126: page 1]
detection; illumination

field of view
specimen
