balintbalazs/thesis/figures/1_spim/spectrum/egfp.pdf

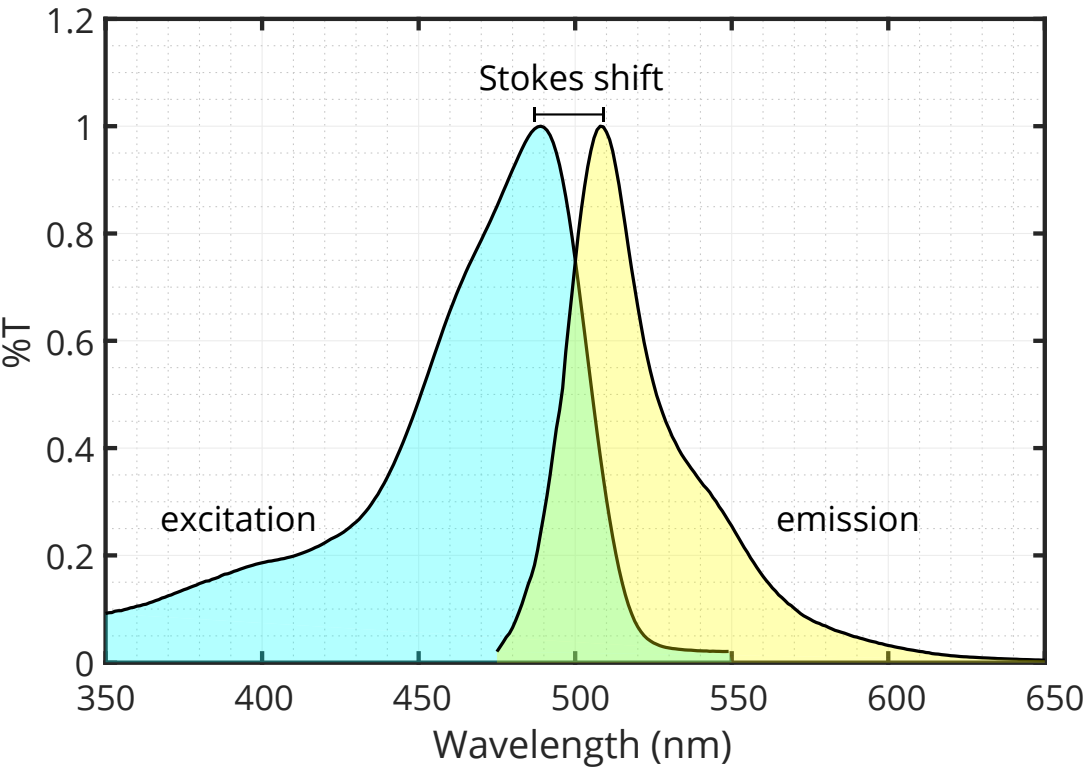
[picture p127: page 1]
Wavelength (nm); Stokes shift; excitation; emission
