balintbalazs/thesis/figures/2_DualMouse/beamPlots_view.pdf

0.81

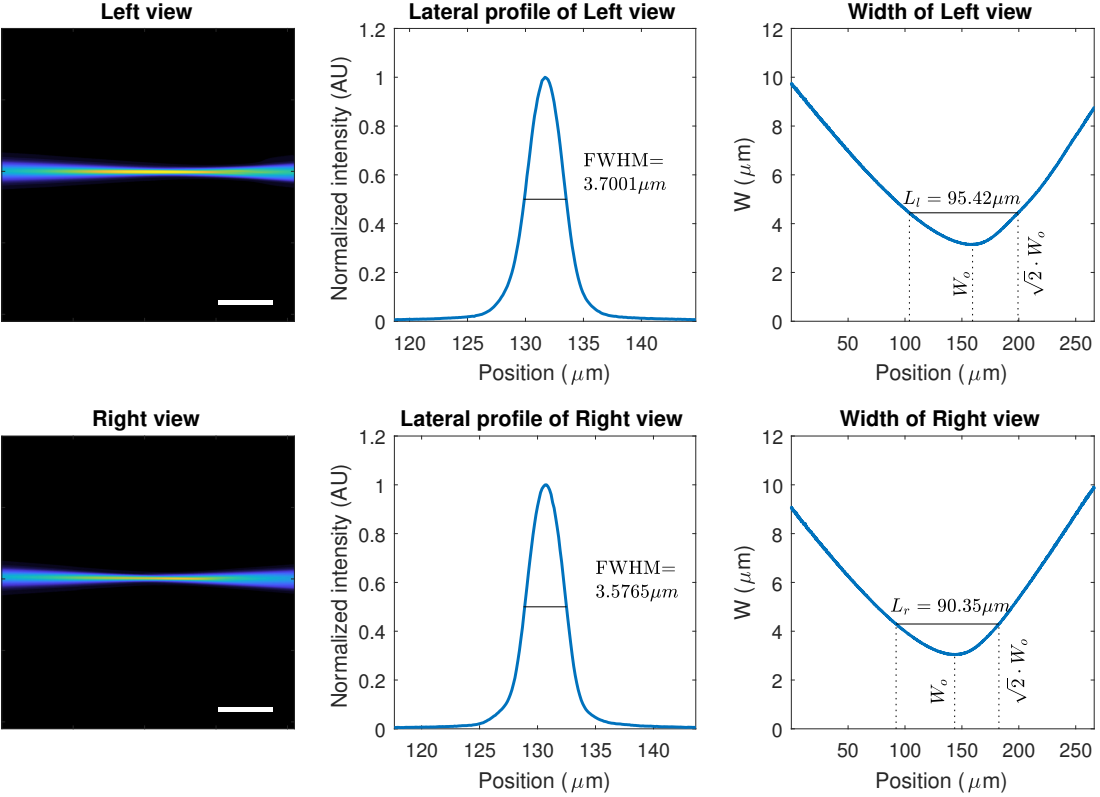
[picture p128: page 1]
Left view; Right view; Position ( m)

Lateral profile of Left view

Width of Left view

Normalized intensity (AU)

Lateral profile of Right view

Width of Right view
