balintbalazs/thesis/figures/1_spim/airy.pdf

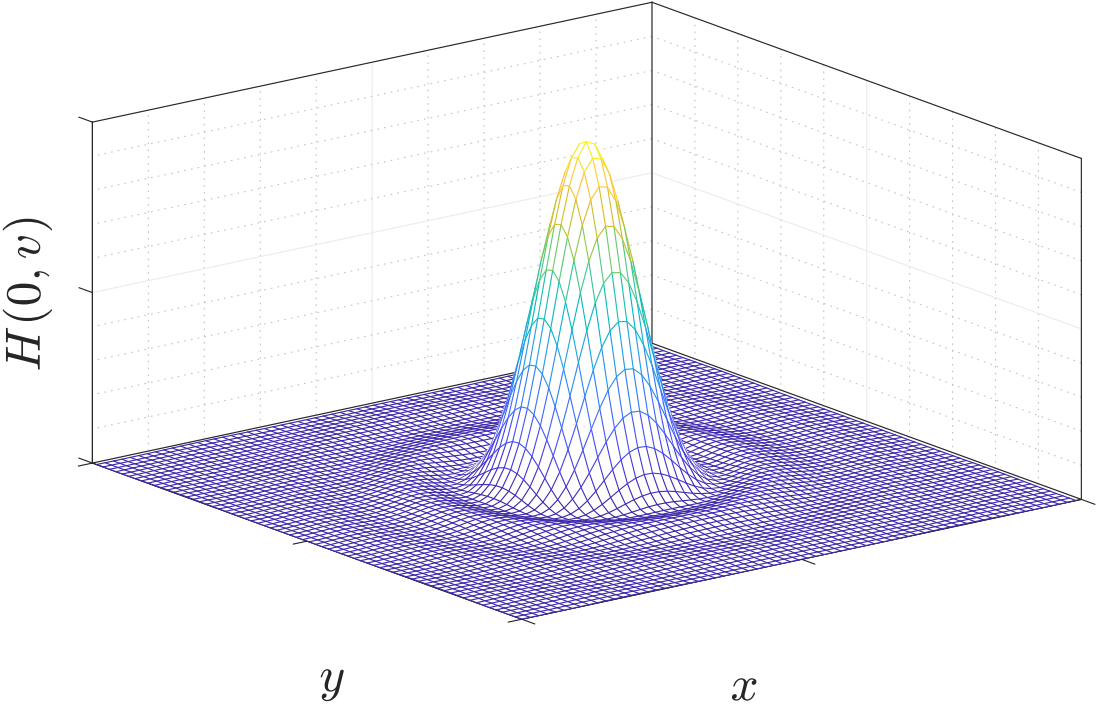
[picture p129: page 1]
