balintbalazs/thesis/figures/2_DualMouse/120+psf.pdf

a

b

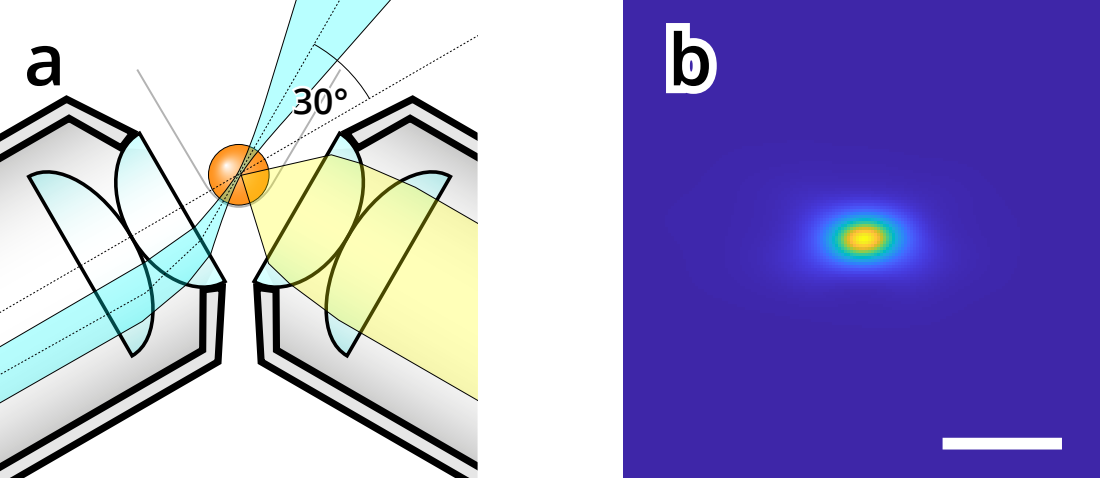
[picture p130: page 1]
