balintbalazs/thesis/figures/4_gpu/wnlSamples.pdf

a | b
d | e

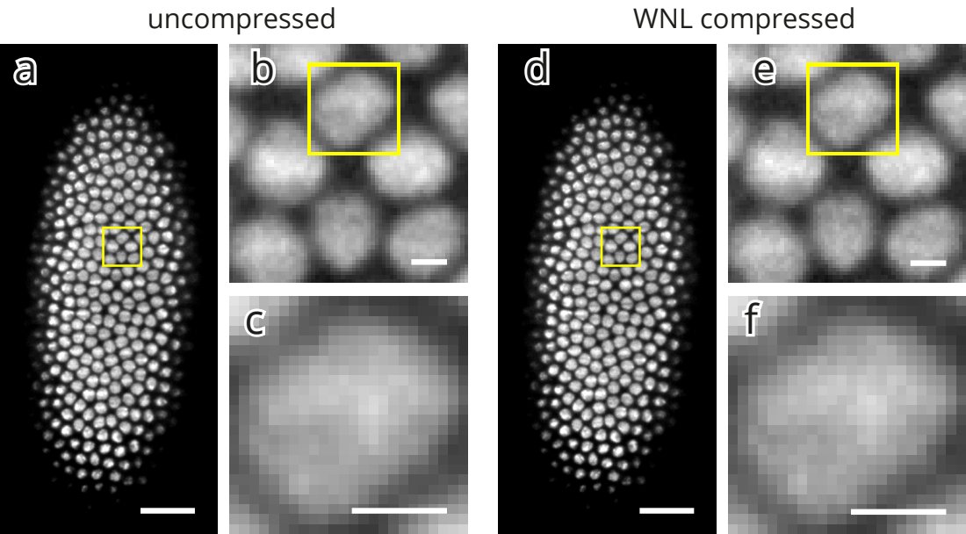
[picture p131: page 1]
uncompressed; WNL compressed
