balintbalazs/thesis/figures/4_gpu/pipeline.pdf

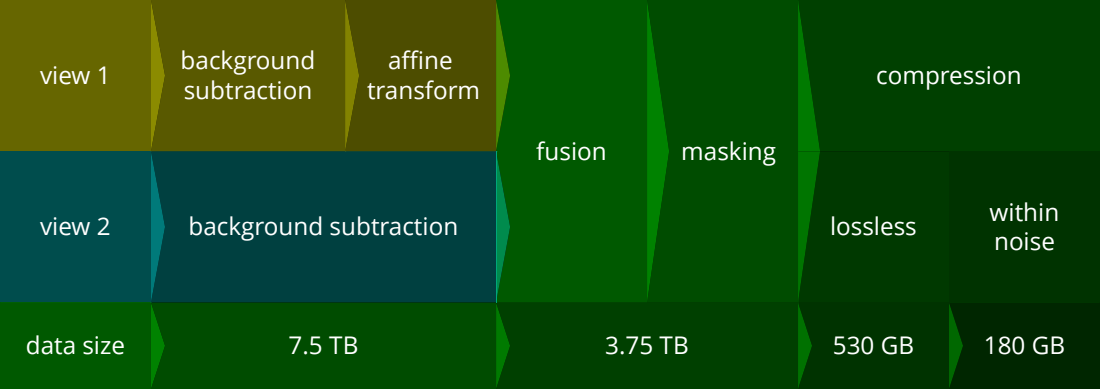
[picture p132: page 1]
view 1; background; subtraction; affine transform; fusion; masking; compression; view 2; background subtraction; lossless; within noise; data size
