balintbalazs/thesis/figures/2_DualMouse/objectiveCloseup.pdf

a

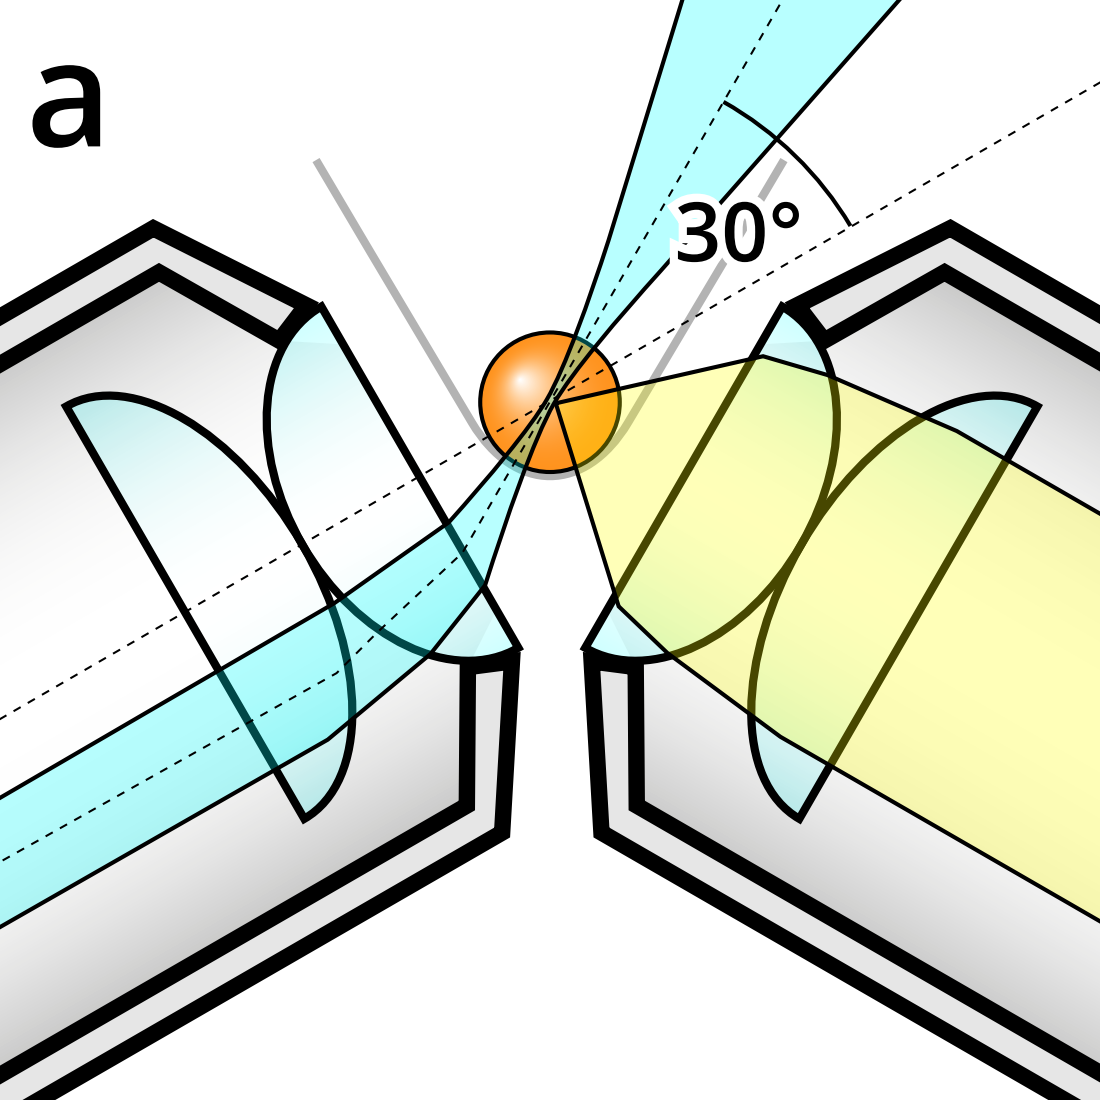
[picture p133: page 1]

b

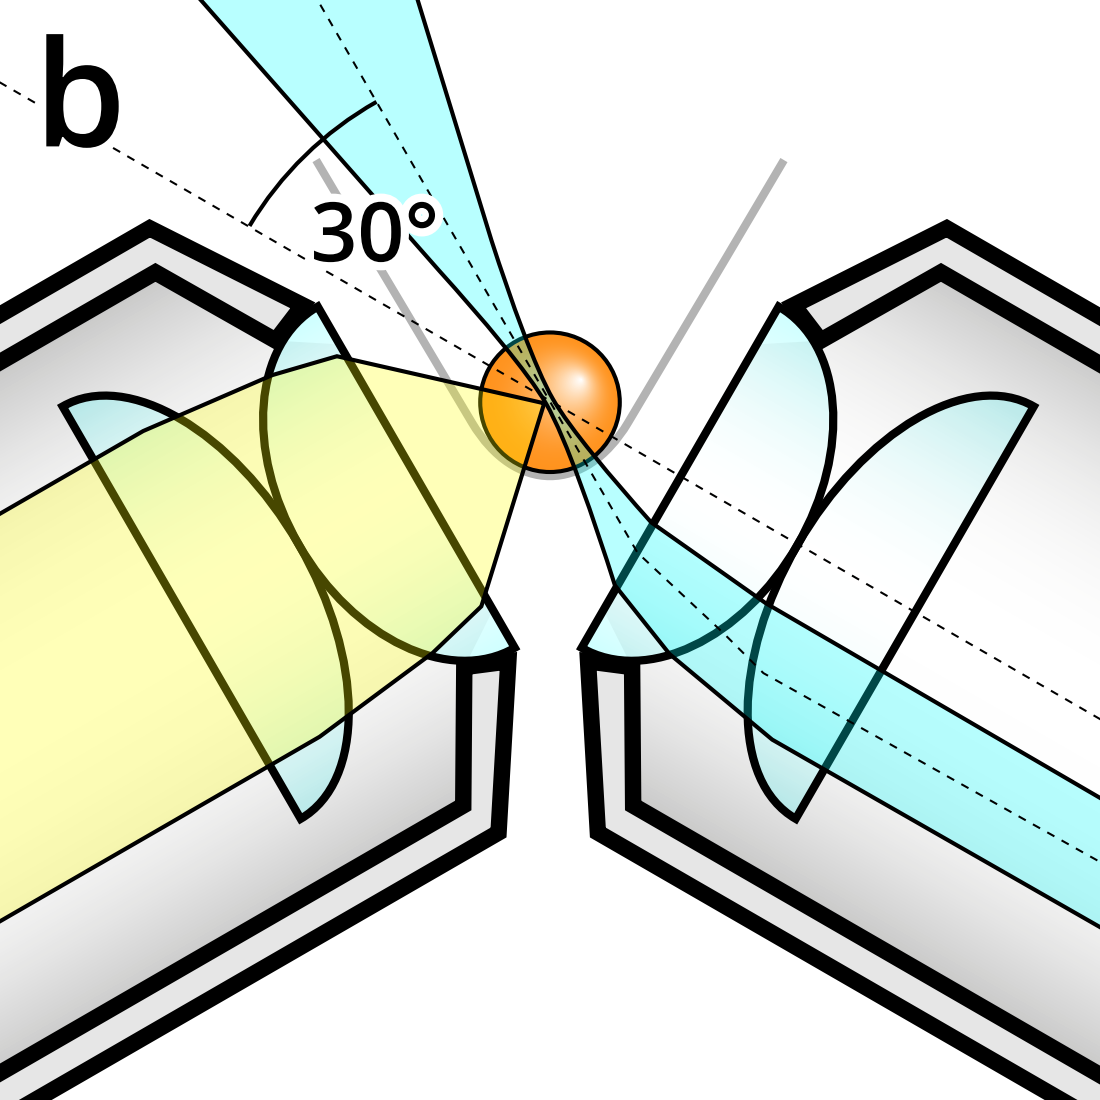
[picture p134: page 2]
