balintbalazs/thesis/figures/2_DualMouse/trackCenter.pdf

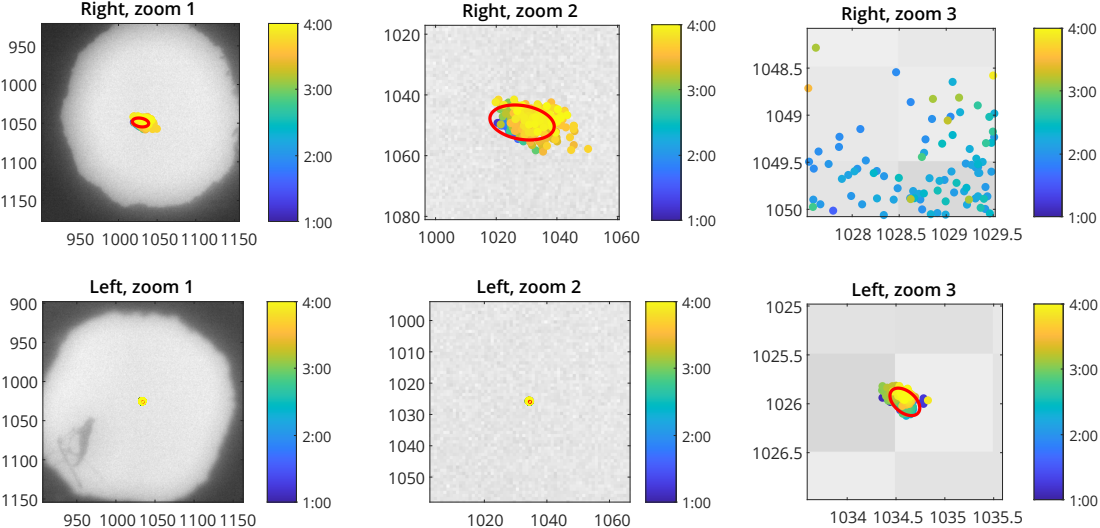
[picture p135: page 1]
Right, zoom 1; Right, zoom 2; Right, zoom 3; Left, zoom 1; Left, zoom 2; Left, zoom 3
