balintbalazs/thesis/figures/2_DualMouse/rotated_psfs.pdf

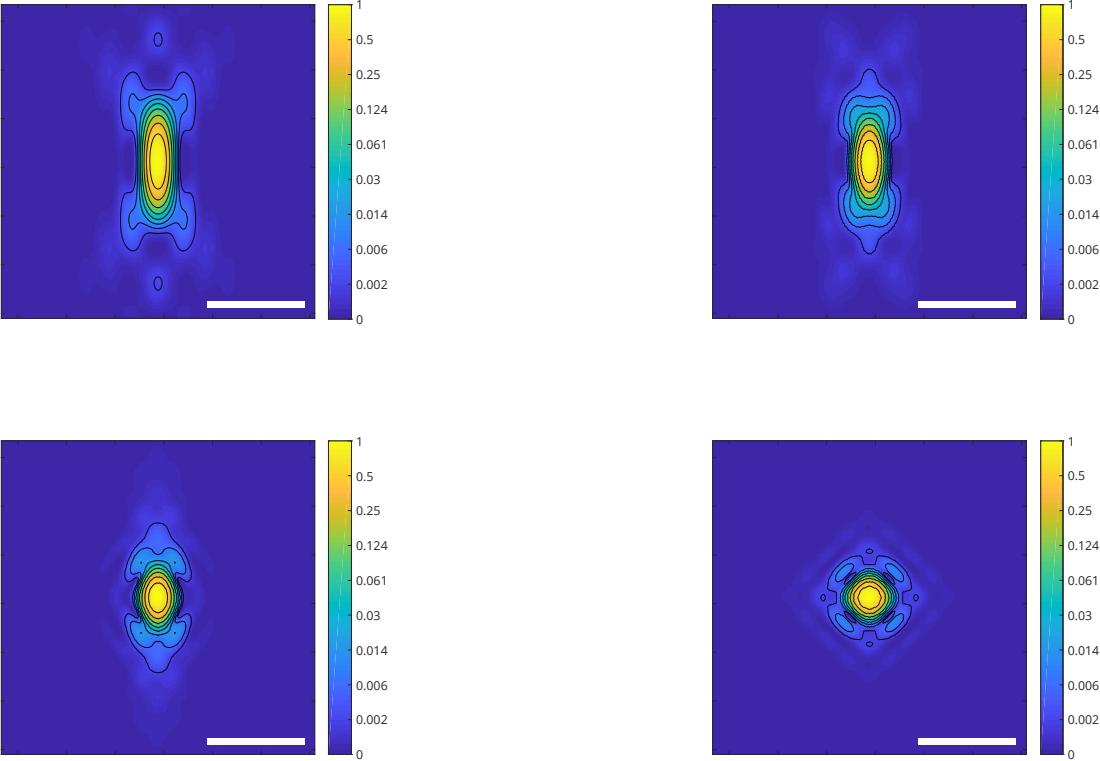
[picture p136: page 1]
