balintbalazs/thesis/figures/4_gpu/swapping.pdf

100

150

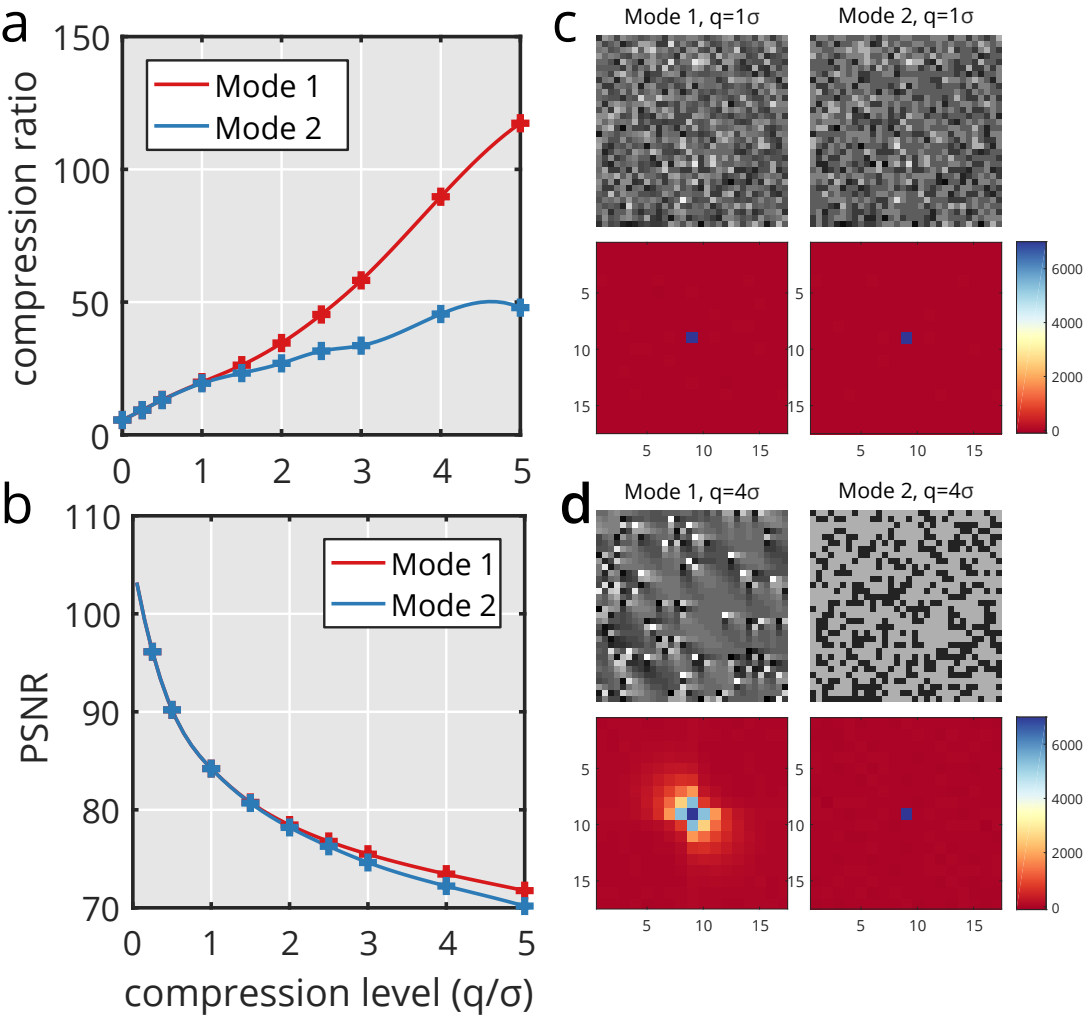
[picture p137: page 1]
compression ratio; Mode 1 Mode 2; FRPSUHVVLRQOHYHOT; PSNR; Mode 2, q=4σ; Mode 1, q=1σ; Mode 1, q=4σ; Mode 2, q=1σ
