balintbalazs/thesis/figures/4_gpu/TheFigure_brief_comm.pdf

a | b

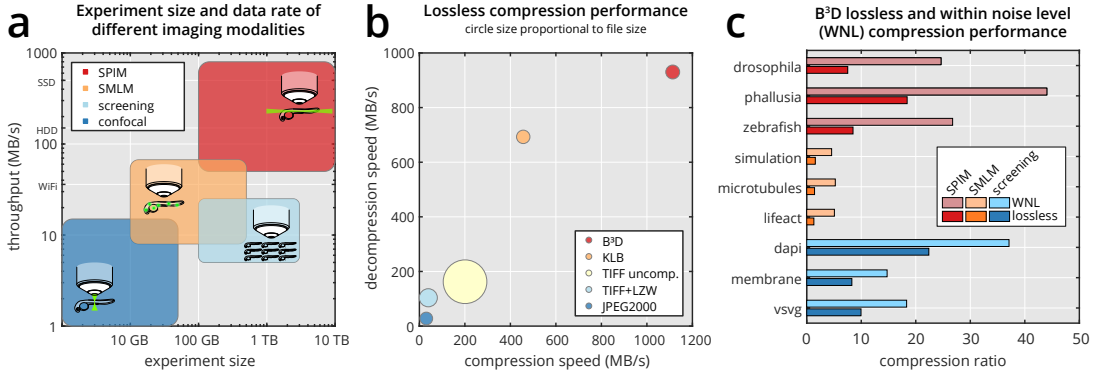
[picture p138: page 1]
Experiment size and data rate of; Lossless compression performance; experiment size; WiFi; HDD; SSD; throughput (MB/s); compression ratio; drosophila; phallusia; ]HEUDVK; simulation; microtubules; lifeact; dapi; membrane; vsvg; SPIM; SMLM; screening; D lossless and within noise level c; (WNL) compression performance

GLHUHQWLPDJLQJPRGDOLWLHV

FLUFOHVL]HSURSRUWLRQDOWROHVL]H

SPIM
SMLM screening confocal

decompression speed (MB/s)

WNL lossless

B³D KLB TIFF uncomp.

TIFF+LZW JPEG2000

compression speed (MB/s)

q=1 | q=4
a | b | c | d

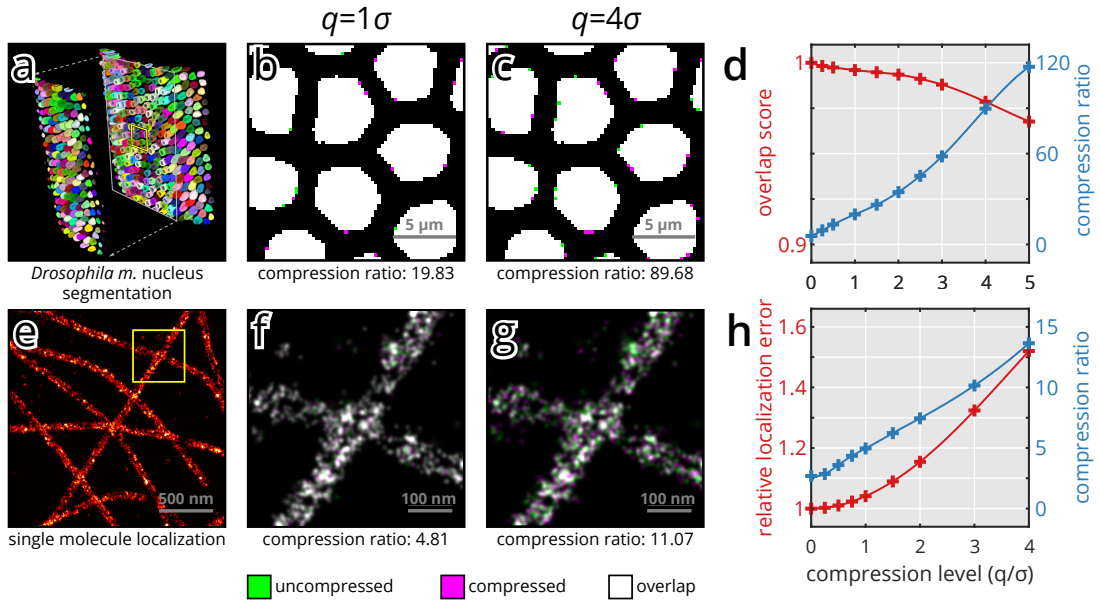
[picture p139: page 2]
compression level; overlap score; 120 compression ratio; FRPSUHVVLRQOHYHOT; compression ratio; compression ratio: 19.83; compression ratio: 89.68; uncompressed; compressed; overlap; Drosophila m. nucleus segmentation; single molecule localization; compression ratio: 4.81; compression ratio: 11.07

relative localization error
