balintbalazs/thesis/figures/1_spim/height.pdf

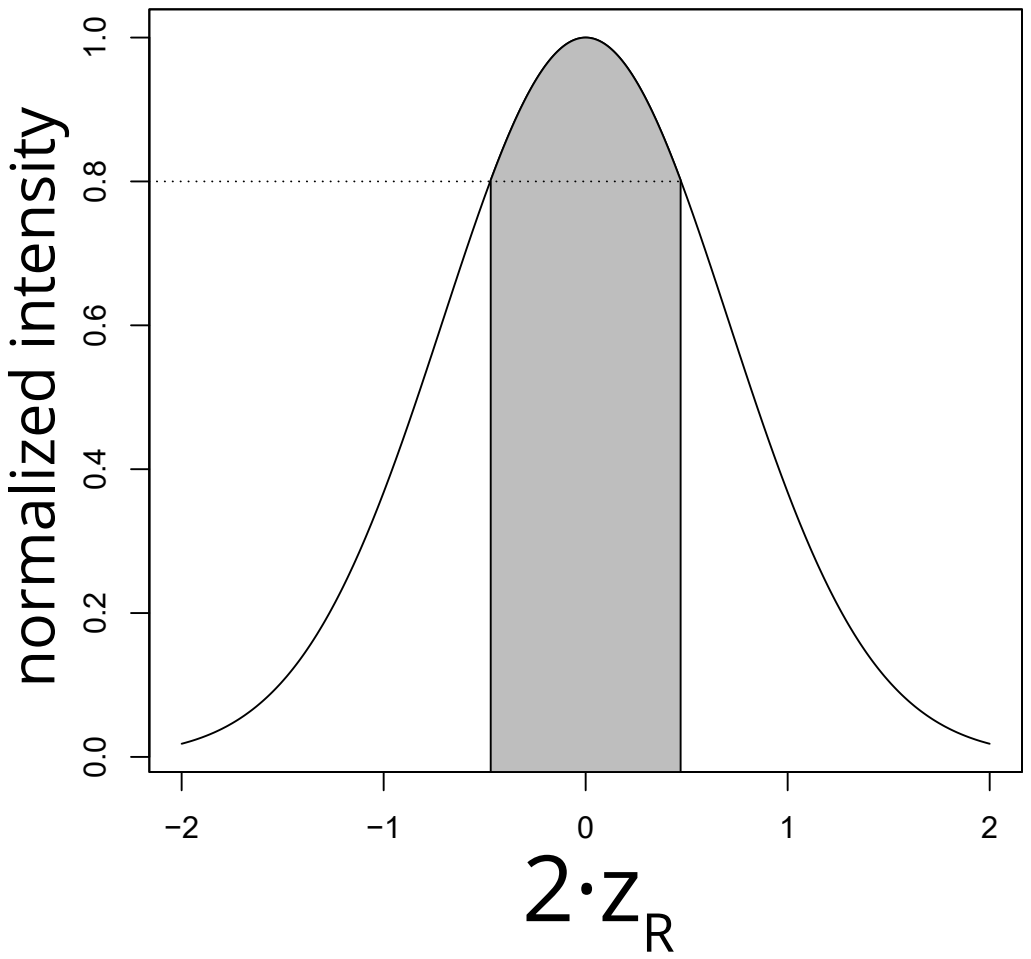
[picture p140: page 1]
normalized intensity
