balintbalazs/thesis/figures/1_spim/width.pdf

2·z

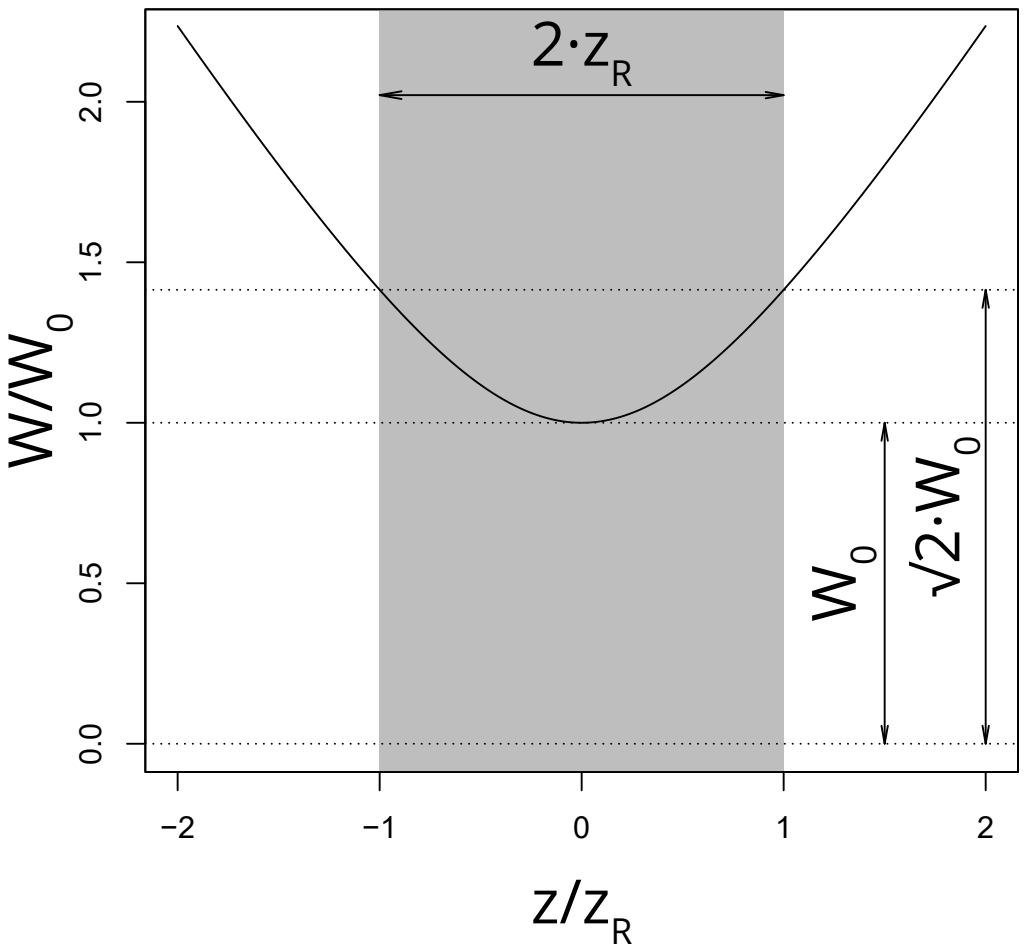
[picture p141: page 1]
