balintbalazs/thesis/figures/1_spim/spim_zoo.pdf

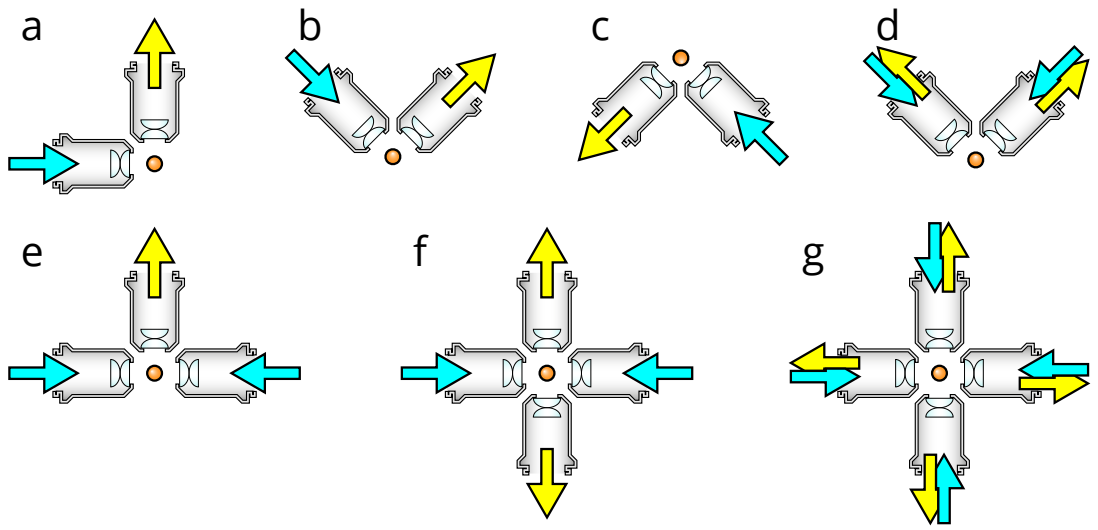
[picture p142: page 1]
