balintbalazs/thesis/figures/4_gpu/comparison_with_pictograms.pdf

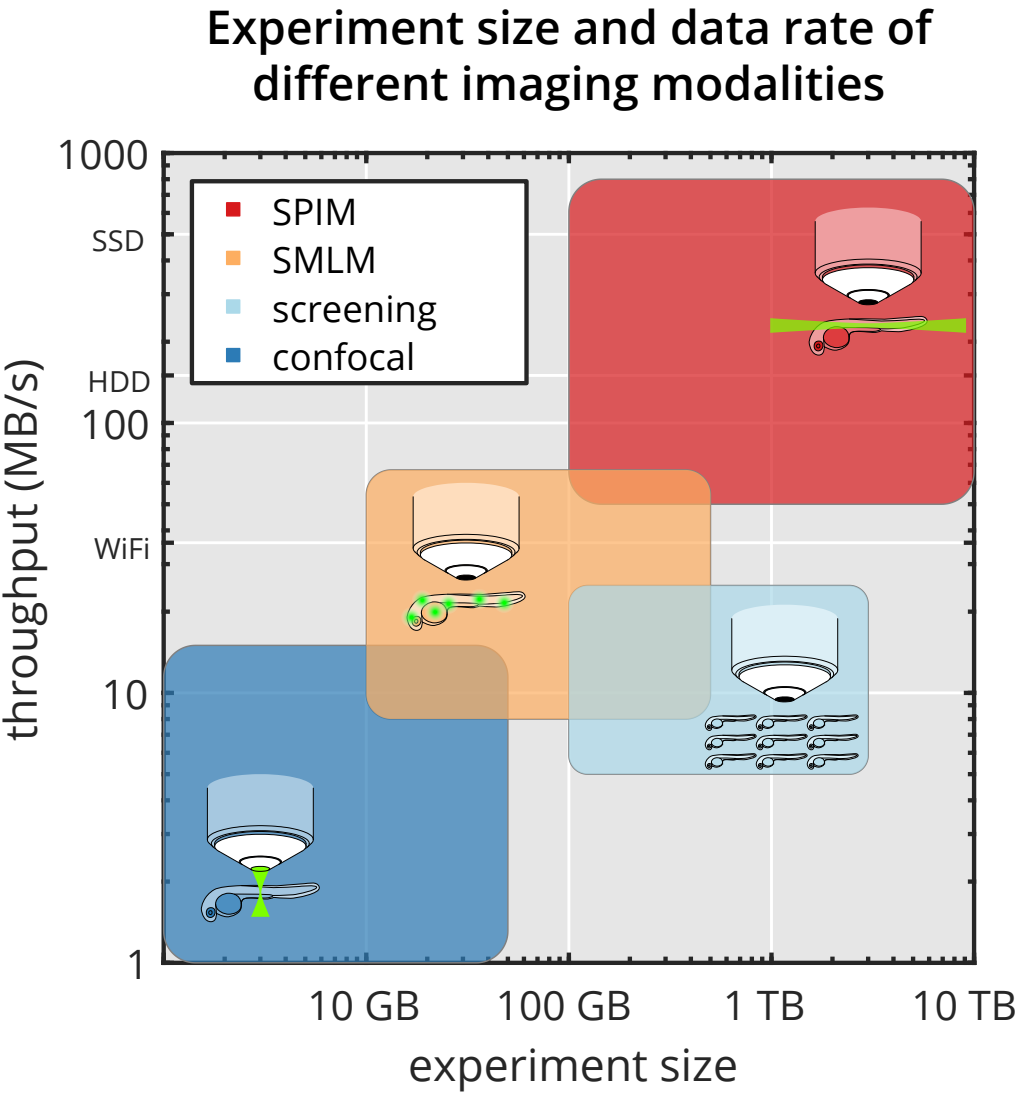
[picture p143: page 1]
experiment size; WiFi; HDD; SSD; throughput (MB/s)

Experiment size and data rate of
different imaging modalities

SPIM
SMLM screening confocal
