balintbalazs/thesis/figures/4_gpu/SFig6_locprecVsNphotons.pdf

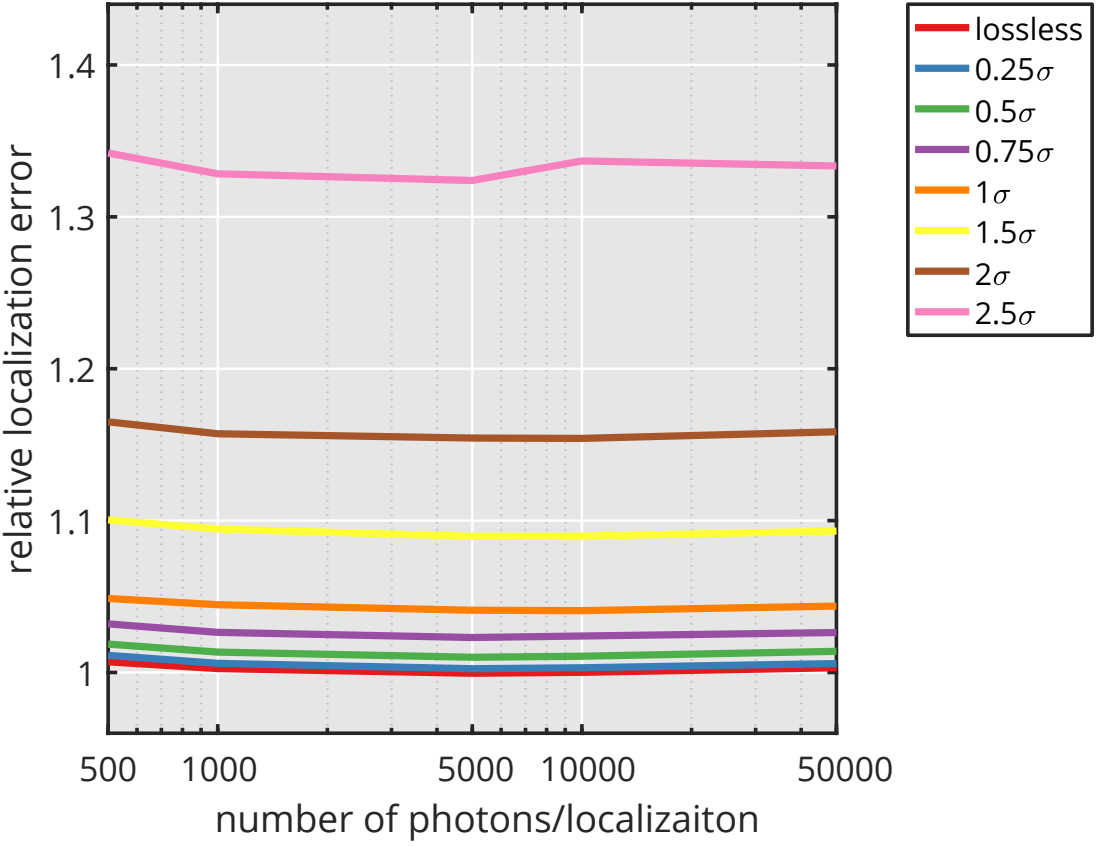
[picture p144: page 1]
lossless 0.25 0.5 0.75 1 1.5 2 2.5

relative localization error

number of photons/localizaiton
