balintbalazs/thesis/figures/2_DualMouse/objective_projection.pdf

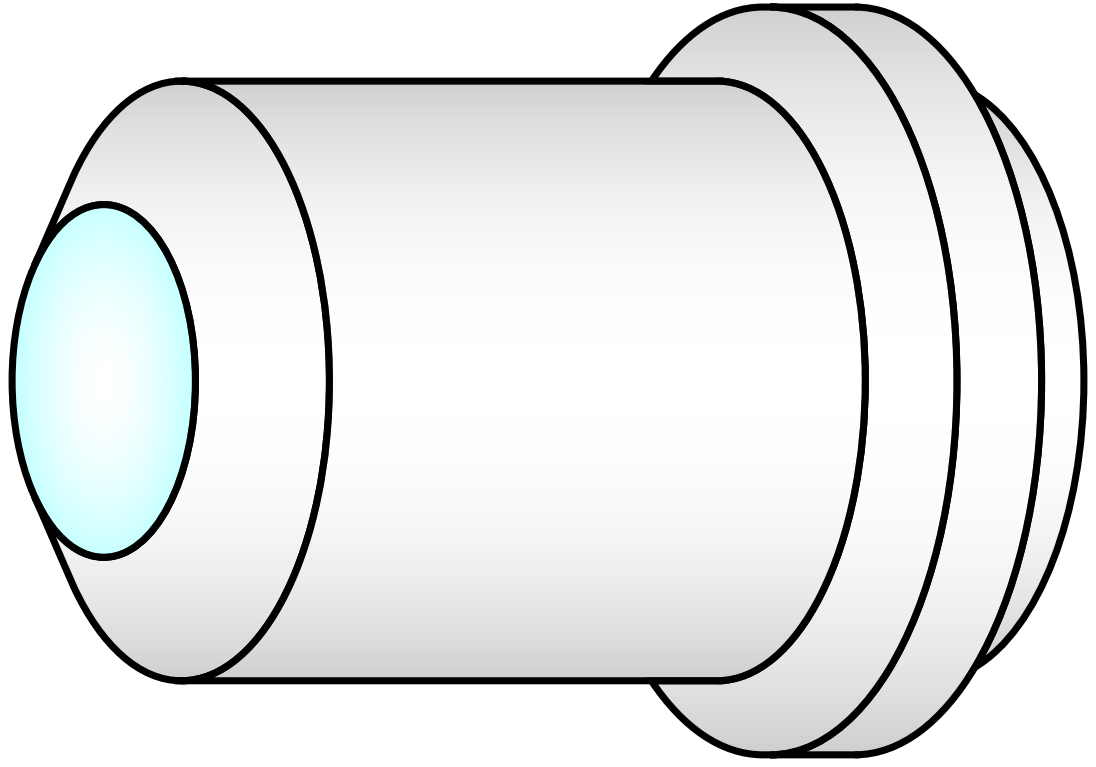
[picture p145: page 1]
