balintbalazs/thesis/figures/0_front/EMBL_logo.pdf

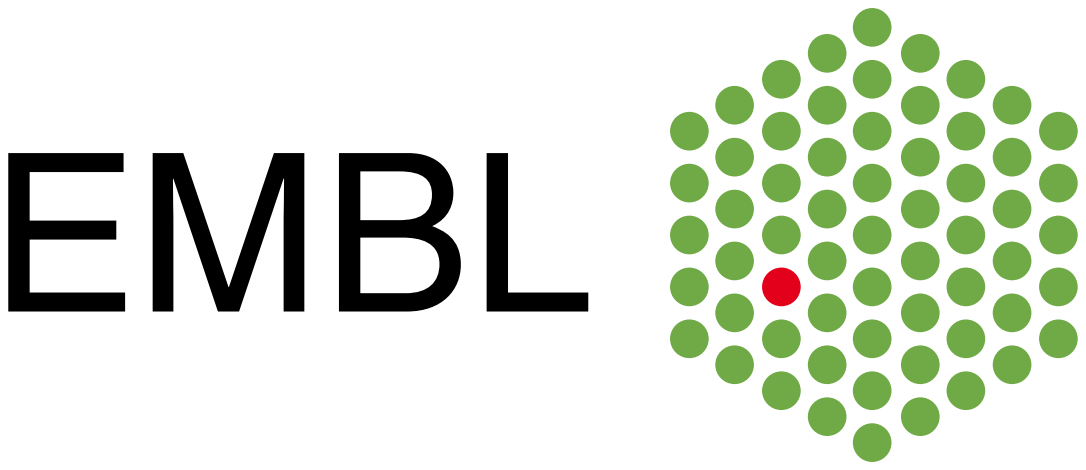
[picture p146: page 1]
