balintbalazs/thesis/figures/0_front/ITK_logo.pdf

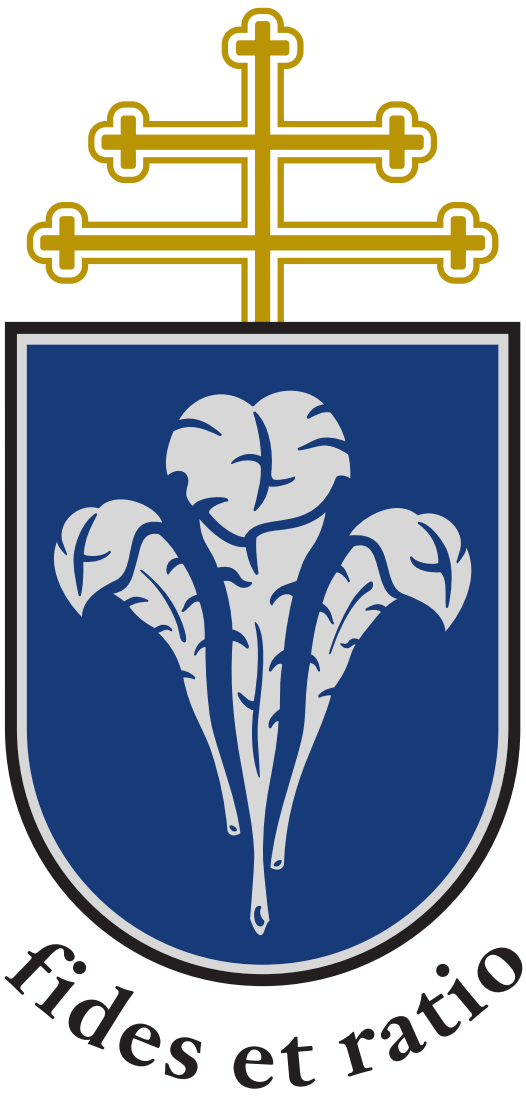
[picture p147: page 1]
