balintbalazs/thesis/figures/1_spim/resolution.pdf

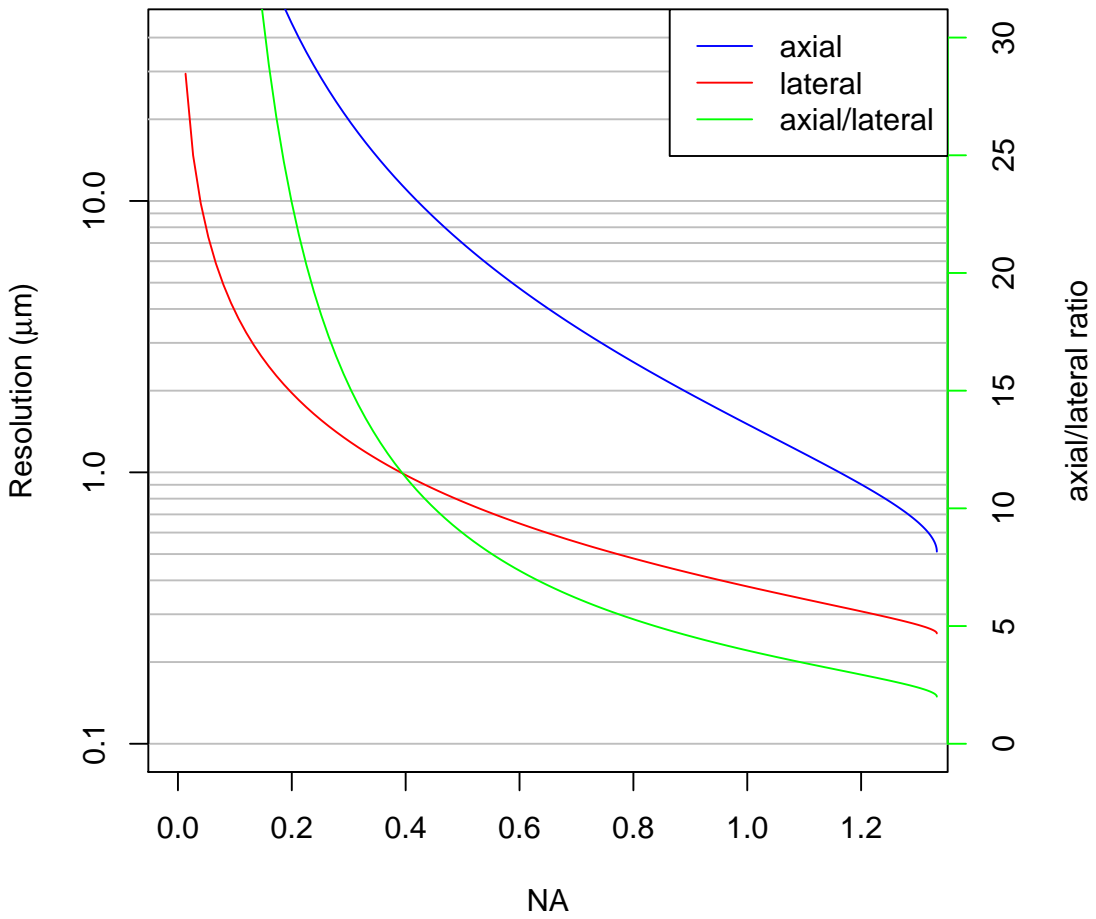
[picture p148: page 1]
axial; lateral axial/lateral; Resolution (µm)

axial/lateral ratio
