balintbalazs/thesis/figures/1_spim/resolution7.pdf

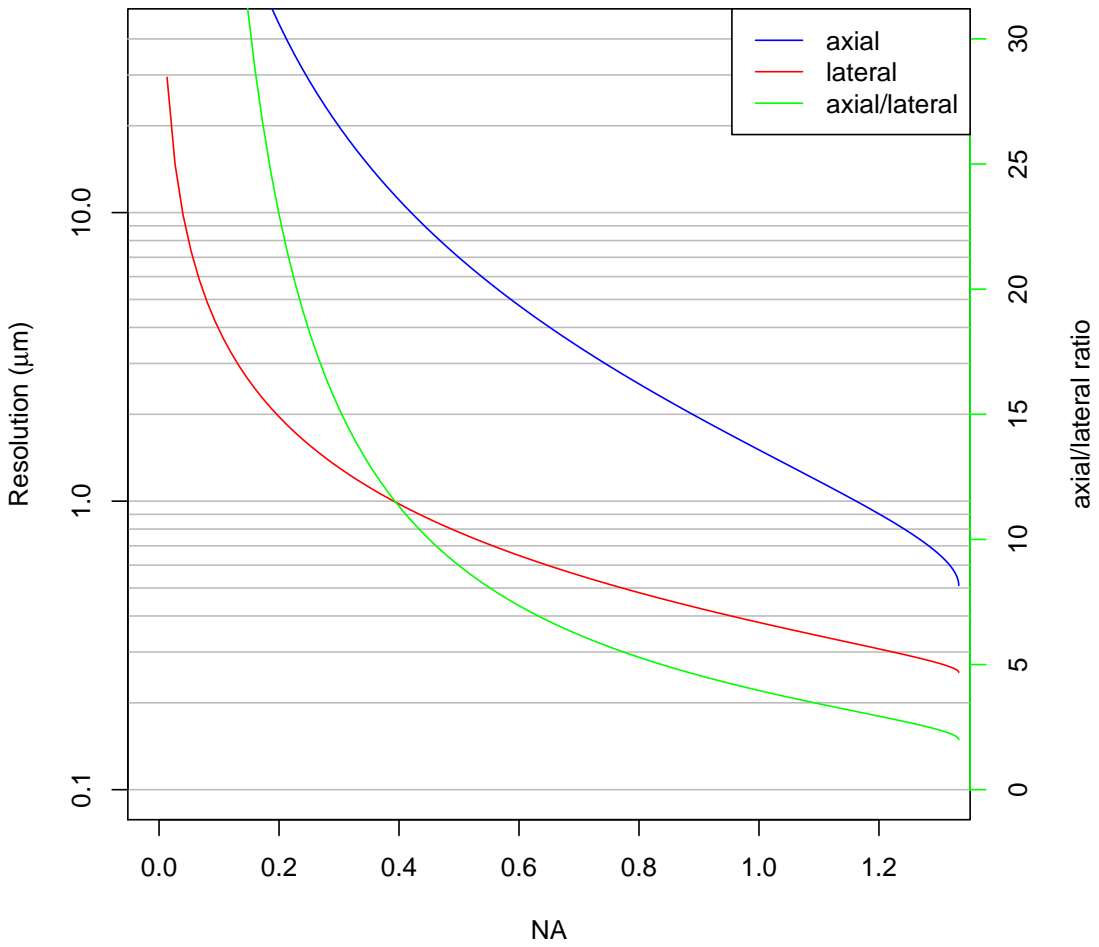
[picture p149: page 1]
axial; lateral axial/lateral; Resolution (µm)

axial/lateral ratio
