balintbalazs/thesis/figures/2_DualMouse/SW/frontRenderÜblack.pdf

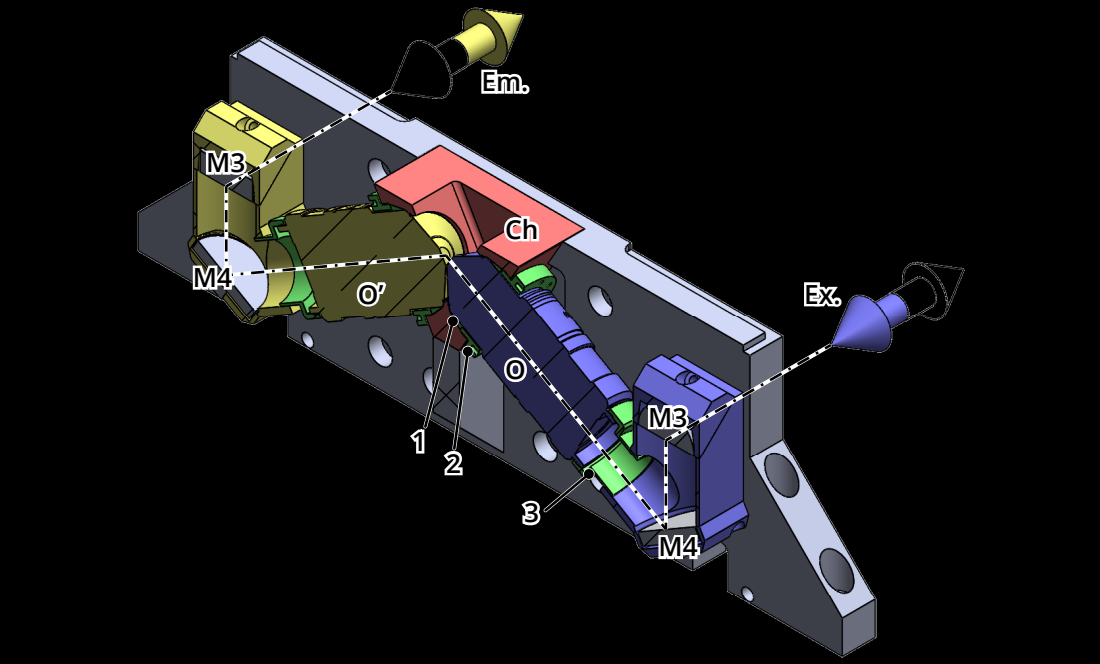
[picture p150: page 1]
