balintbalazs/thesis/figures/1_spim/psfs/confocal.pdf

PSF | OTF

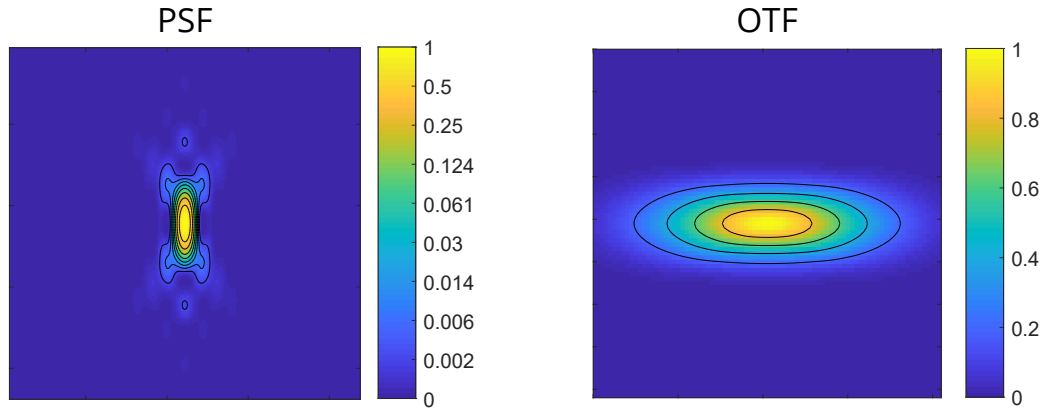
[picture p151: page 1]
