balintbalazs/thesis/figures/1_spim/psfs/WF.pdf

PSF | OTF

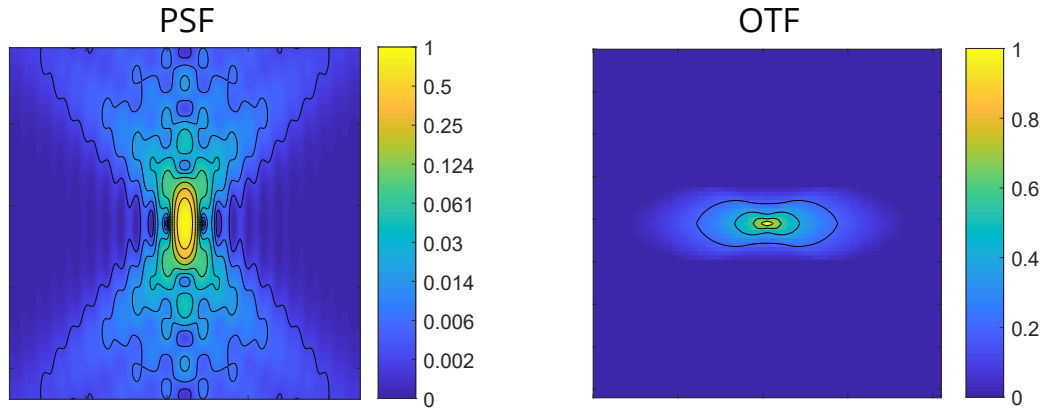
[picture p152: page 1]
