balintbalazs/thesis/figures/4_gpu/fusion/acquisition.pdf

N
a

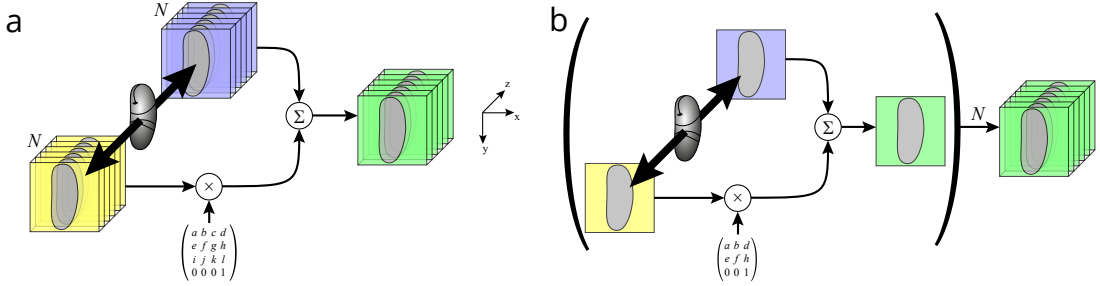
[picture p153: page 1]
