balintbalazs/thesis/figures/2_DualMouse/photos/top+light.pdf

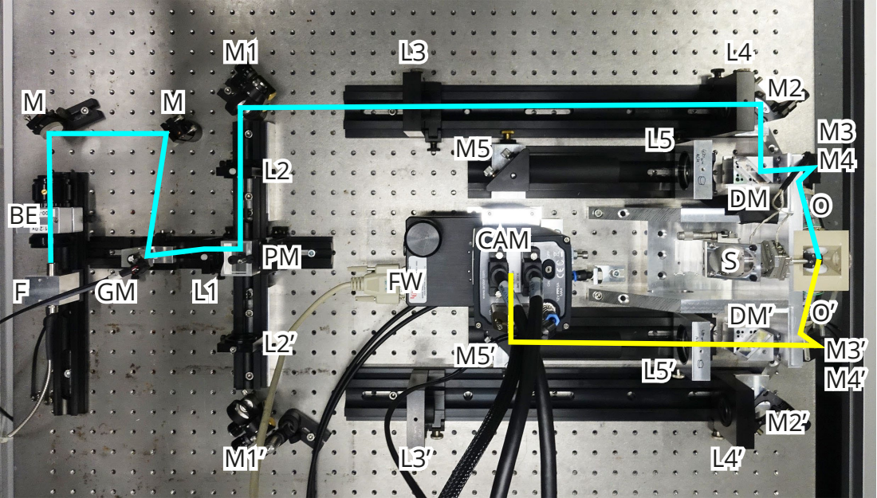
[picture p154: page 1]
CAM
