balintbalazs/thesis/figures/2_DualMouse/SW/frontRender.pdf

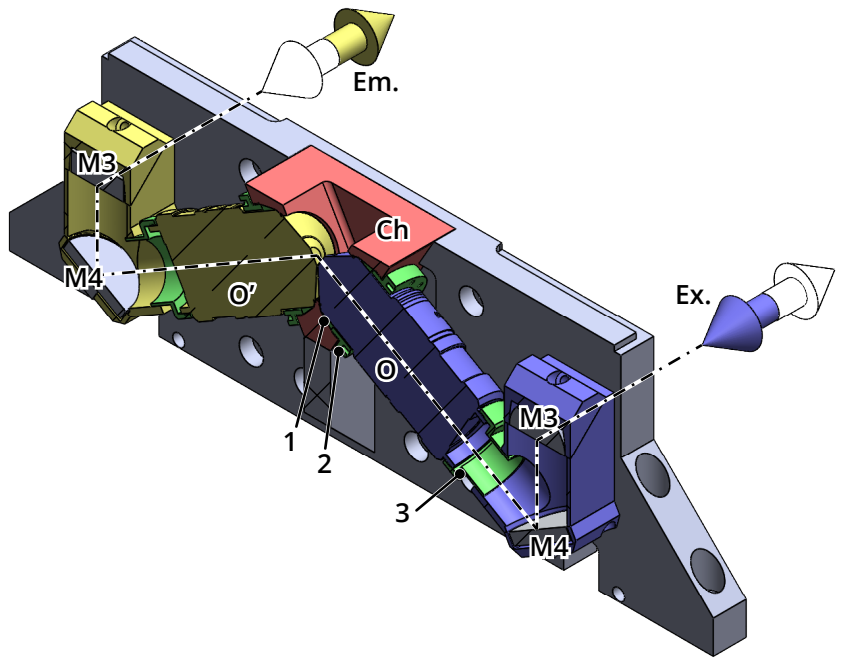
[picture p155: page 1]
