balintbalazs/thesis/figures/2_DualMouse/SW/frontLines.pdf

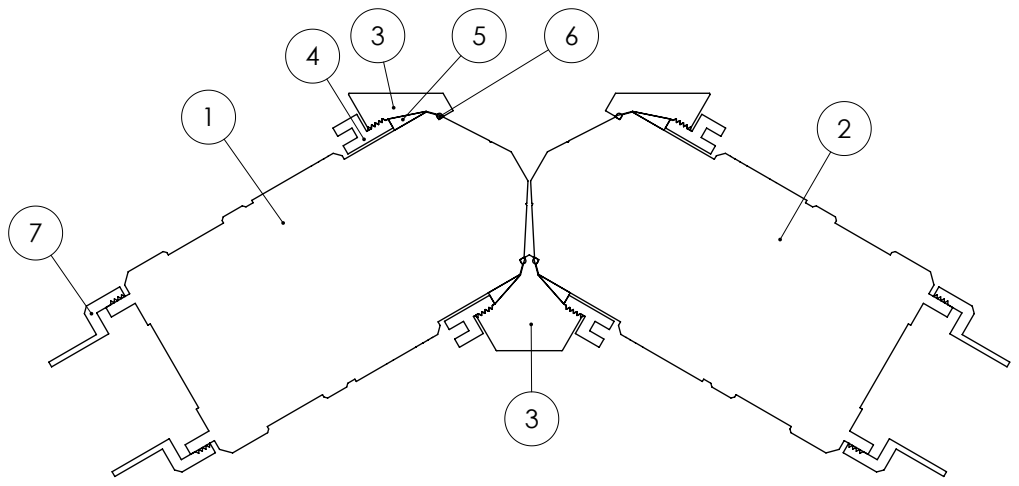
[picture p156: page 1]
