balintbalazs/thesis/figures/2_DualMouse/SW/splitterFigure_block.PDF

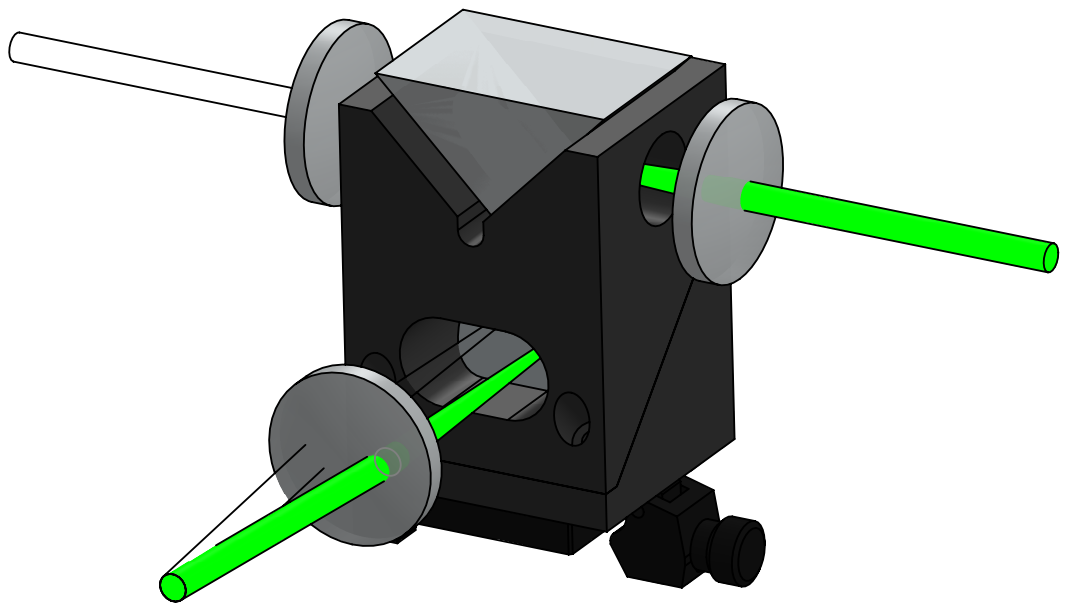
[picture p157: page 1]
