balintbalazs/thesis/figures/2_DualMouse/SW/splitterFigure_outline.pdf

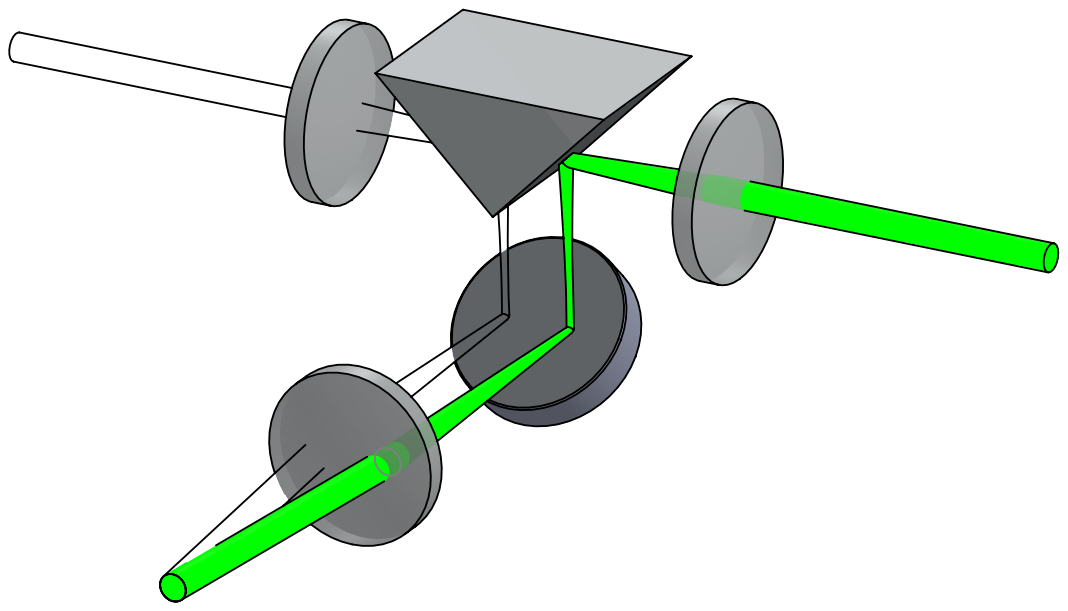
[picture p158: page 1]
