balintbalazs/thesis/figures/1_spim/psfs/psf_spim.pdf

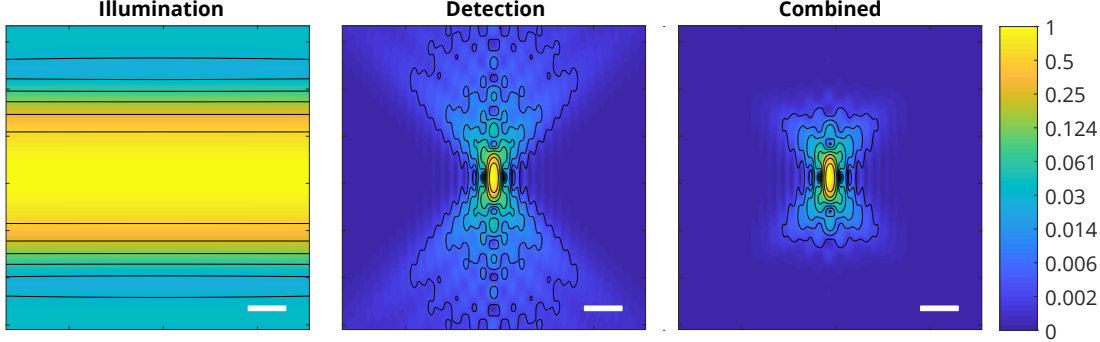
[picture p159: page 1]
Illumination; Detection; Combined
