balintbalazs/thesis/figures/1_spim/psfs/SPIM.pdf

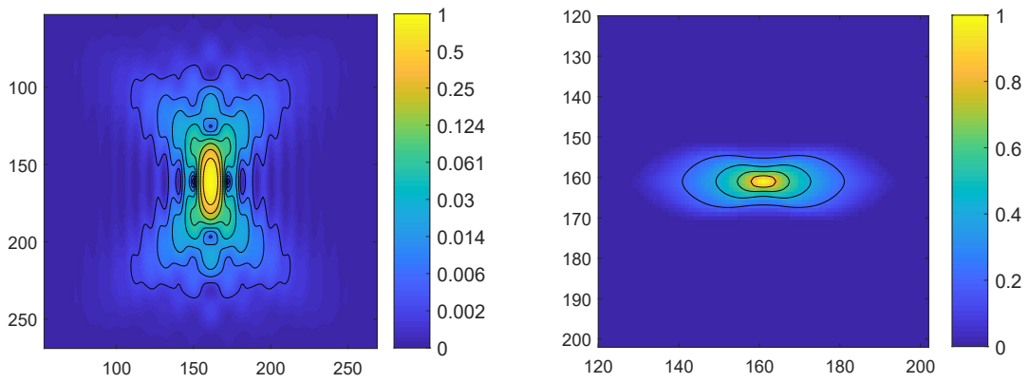
[picture p160: page 1]
