balintbalazs/thesis/figures/1_spim/psfs/SPIM_2x120.pdf

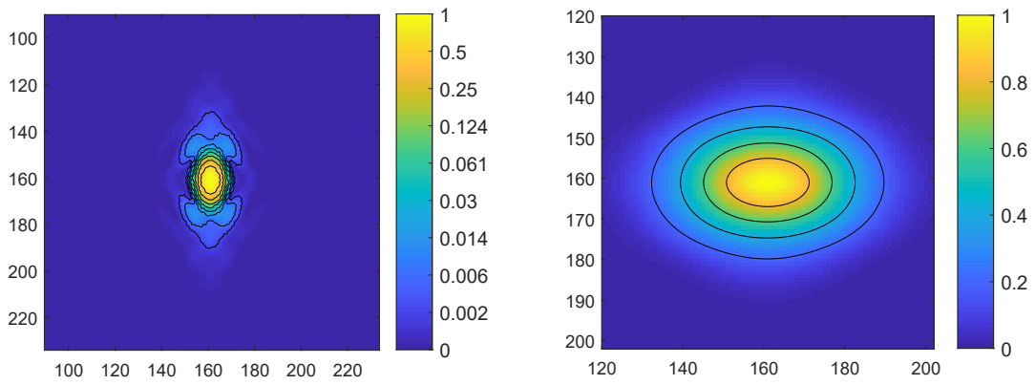
[picture p161: page 1]
