balintbalazs/thesis/figures/1_spim/psfs/SPIM_2x180.pdf

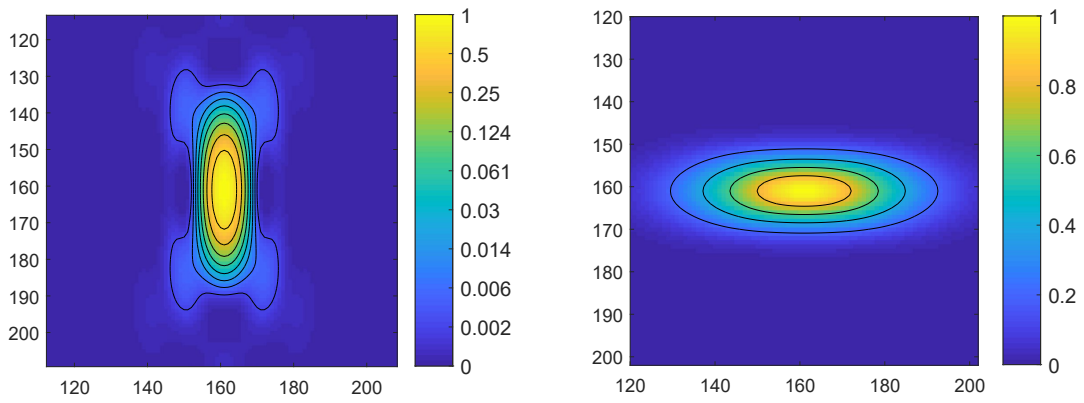
[picture p162: page 1]
