balintbalazs/thesis/figures/1_spim/psfs/SPIM_2x30.pdf

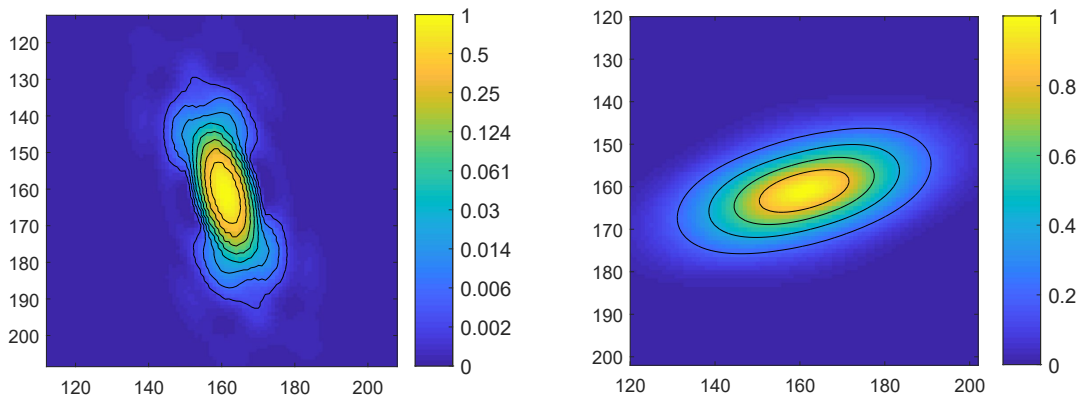
[picture p163: page 1]
