balintbalazs/thesis/figures/1_spim/psfs/SPIM_2x90.pdf

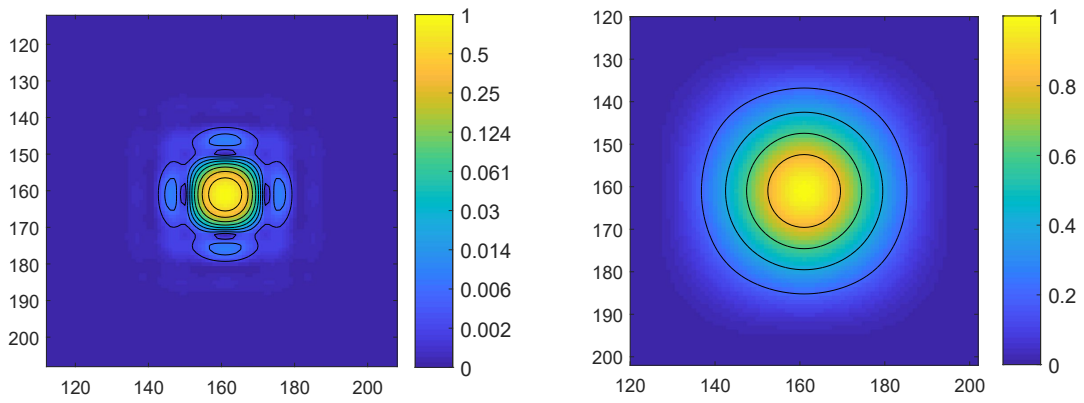
[picture p164: page 1]
