balintbalazs/thesis/figures/1_spim/psfs/SPIM_3x120.pdf

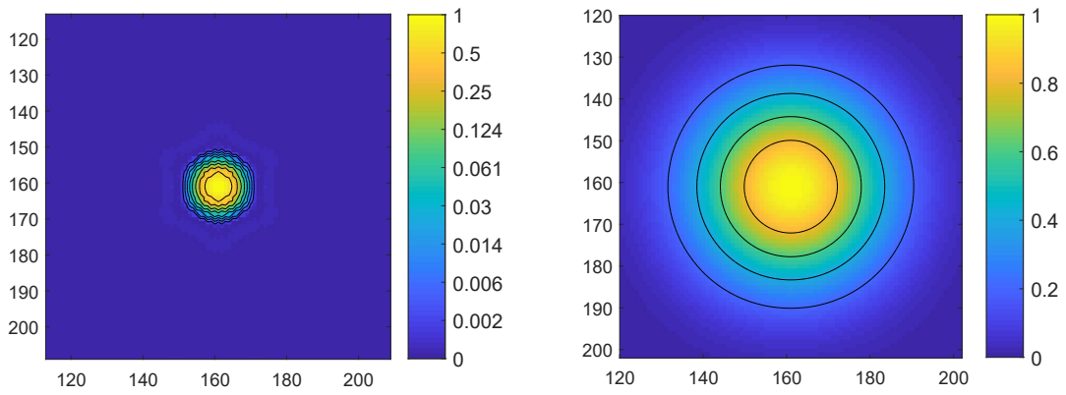
[picture p165: page 1]
