balintbalazs/thesis/figures/1_spim/psfs/SPMI_2x120.pdf

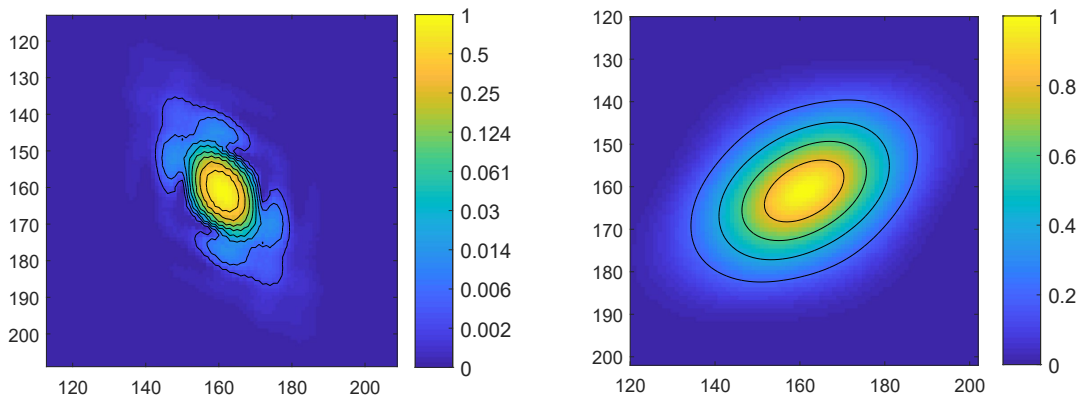
[picture p166: page 1]
