balintbalazs/thesis/figures/2_DualMouse/psfs/SPIMx120.pdf

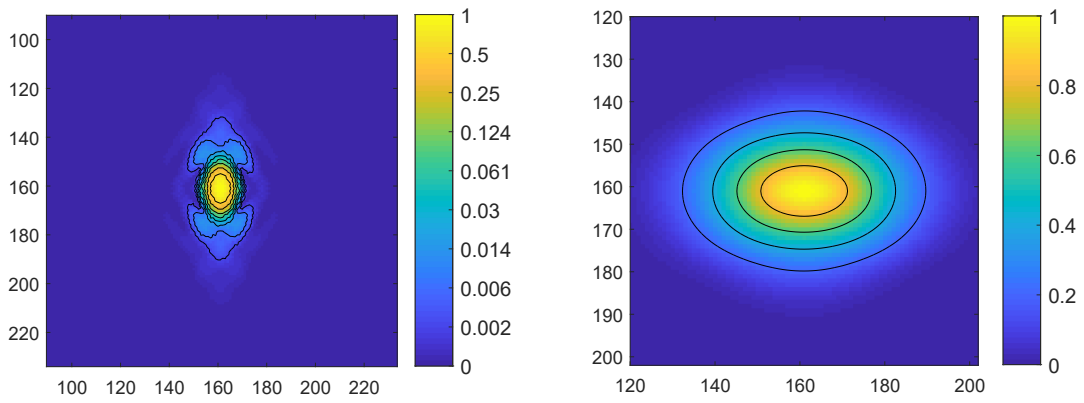
[picture p167: page 1]
