balintbalazs/thesis/(commit log)

2017-08-04 reorganized old figures
    [Characteristics.xlsx]
2017-08-07 added 3D drawings
    [dissabbiatore.blend, dissabbiatore.stl]
2017-08-07 spim_cyl with text, inserted to tex
2017-08-08 added figures fo MuVi-SPIM, and started DualMouseSPIM drawing
    [sphere.SLDPRT]
2017-08-09 added gitignore and sphere drawing
    [sphere.SLDDRW]
2017-08-09 new sphere drawing
    [sphere.SLDASM, sphere.SLDDRW, sphere.SLDPRT, sphere_bottom.SLDPRT, sphere_top.SLDPRT]
2017-08-22 reorganized figures folder to 4 parts, finished full schematics, added tables to main text
    [Characteristics.xlsx, dissabbiatore.blend, dissabbiatore.stl, sphere.SLDASM, sphere.SLDDRW, sphere_bottom.SLDPRT, sphere_top.SLDPRT]
2017-09-25 chamber and rings addeed
2017-09-25 chamber and rings addeed plus pdf updated
2017-09-26 illumination arm done
2017-09-26 detection arm almost done
2017-09-28 FPGA traces.m added, galvo done
2017-09-28 full traces done
2017-09-28 fpga trace fig added to main
2017-10-12 added parallel scheme to algo flowchart
